makerbase-mks/MKS-Robin-Nano-V1.X/hardware/Image/MKS_Robin_Nano_Wiring_Cn.png

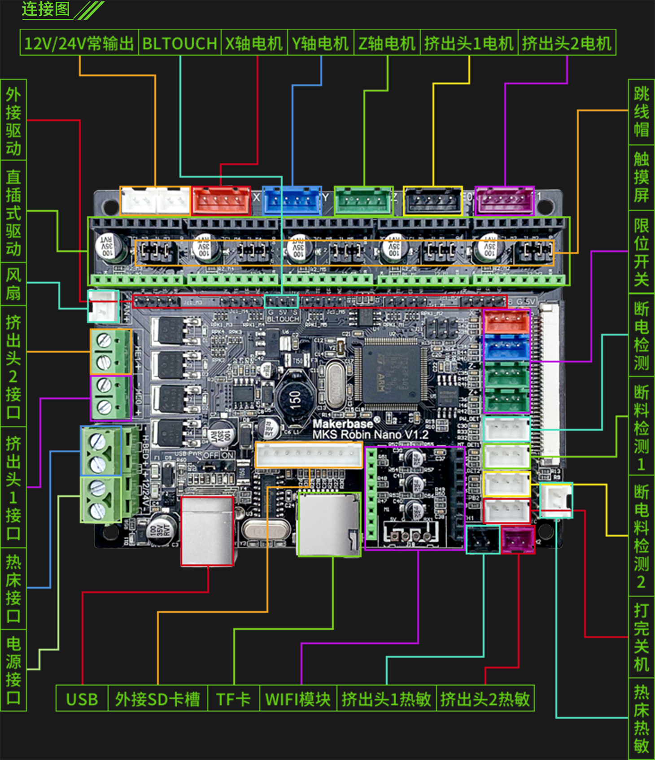
hardware/Image/MKS_Robin_Nano_Wiring_Cn.png
