makerbase-mks/MKS-Robin-Nano-V1.X/hardware/README.md

# MKS-Robin-Nano hardware log
MKS Robin Nano V1.2_004 change(2020/03/03)
Change base on 003 version
- Optimize TF card package

MKS Robin Nano V1.3_002 change(2021/1/30)
change base on V1.2_004 version
- MCU compatible with STM32F103VET6 and STM32F407VET6
- MKS Robin Nano V1.3_002 hardware MCU use STM32F407VET6

MKS Robin Nano-S V1.3_001
- MCU use STM32F407VET6
- Integrated 4 TMC2225 standard mode + 1 plug-in drive interface
