makerbase-mks/MKS-Robin-Nano-V1.X/Nano firmware v1.x.x/README.md

# MKS-Robin-Nano
1、The files in the nano32 folder are for nano + robin tft32.</br>
2、The files in the nano35 folder are for nano + robin tft35.</br>
