makerbase-mks/MKS-Robin-Nano-V1.X/hardware/Image/MKS_Robin_Nano_Pin.png

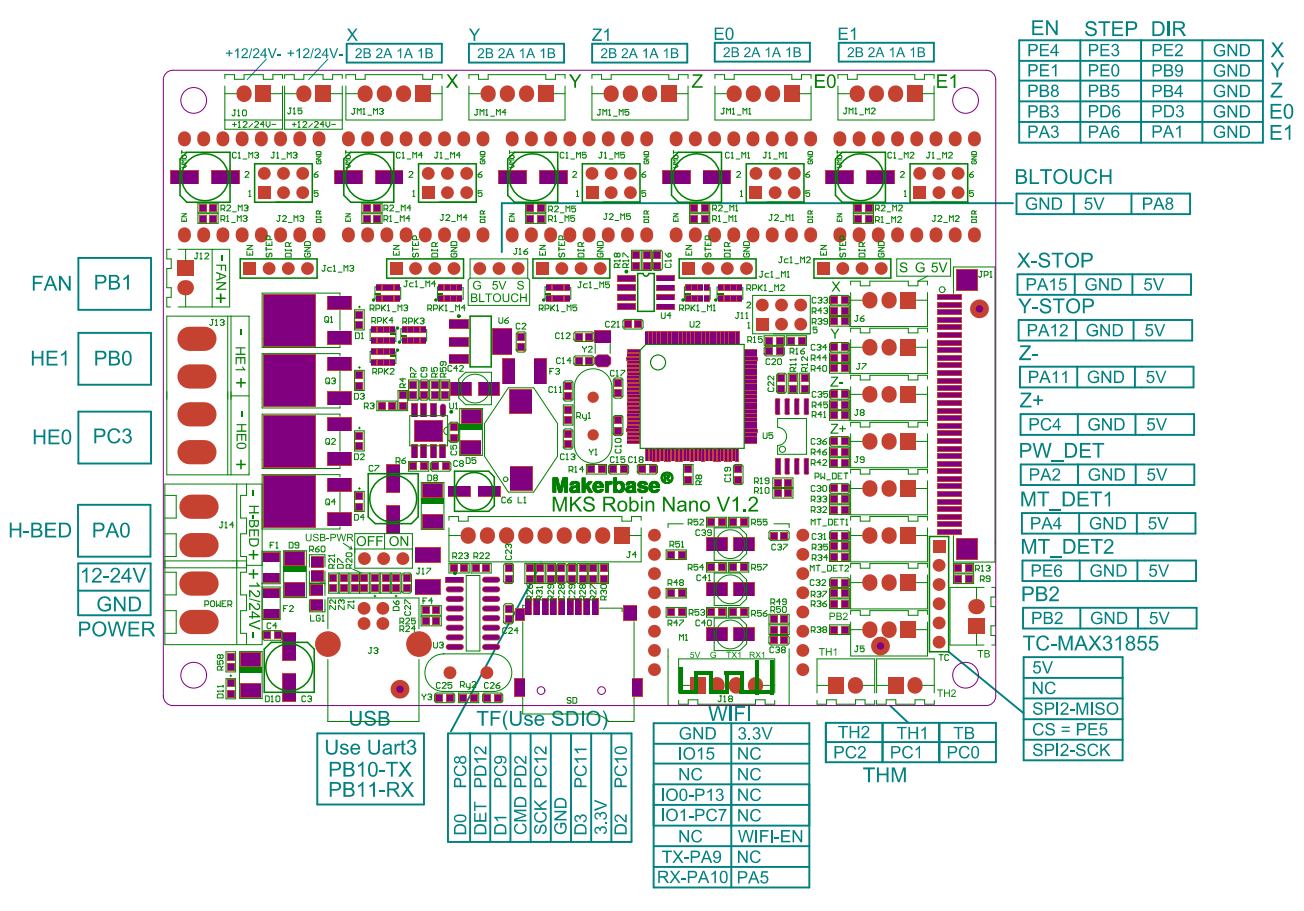
hardware/Image/MKS_Robin_Nano_Pin.png
