makerbase-mks/MKS-Robin-Nano-V1.X/hardware/Image/MKS_Robin_Nano_Size.png

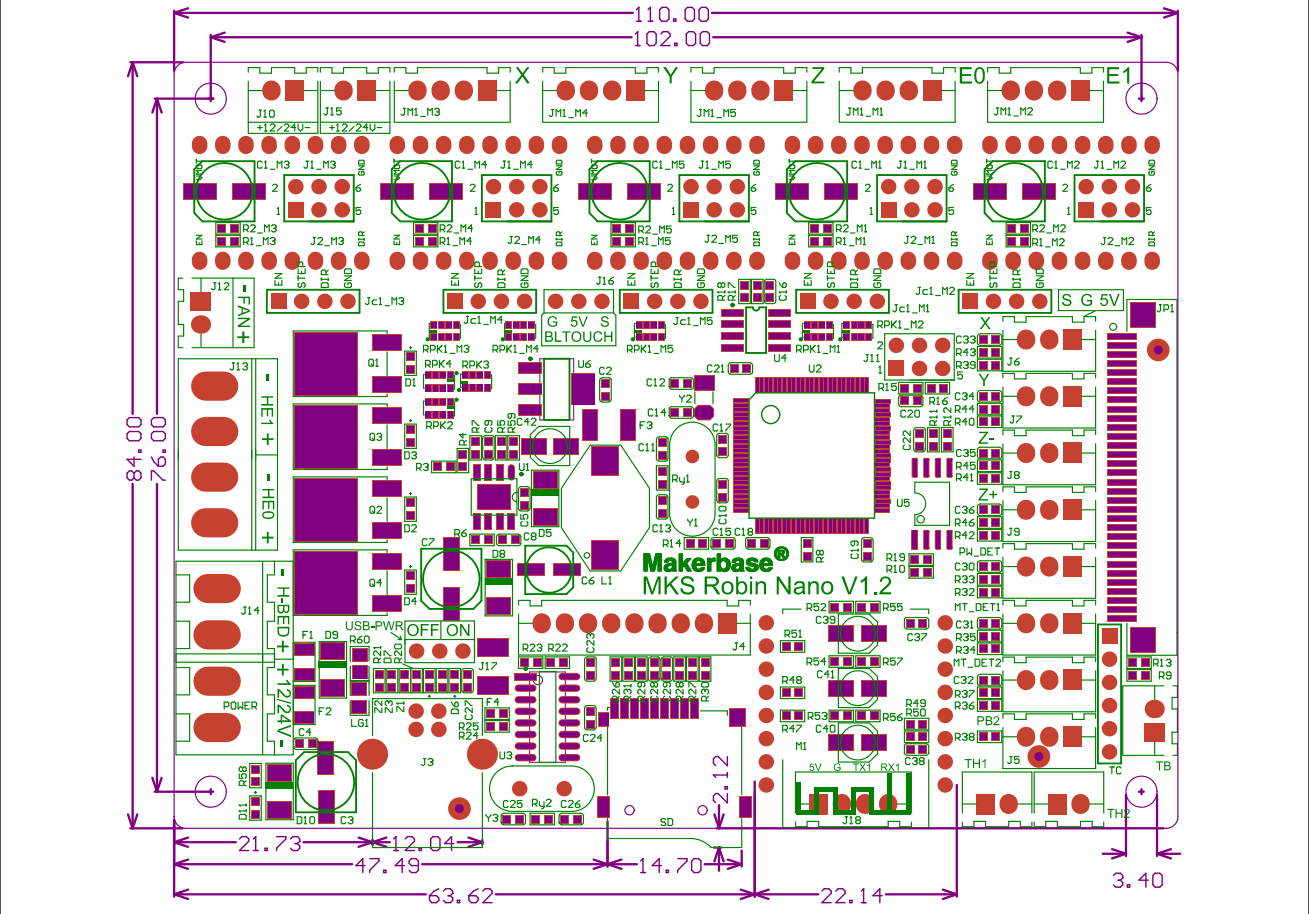
hardware/Image/MKS_Robin_Nano_Size.png
