makerbase-mks/MKS-Robin-Nano-V1.X/(threads)

Thread 2 (2019-12-10):

How to configure 2208 Driver

vespassassina, 2019-12-10:
I need to replace the existing drivers with 2208, how do i configure the firmware and hardware to use them ?

makerbase-mks, 2019-12-12:
Hi, no setup required, just plug it in and use

MowMoney, 2019-12-13:
> Hi, no setup required, just plug it in and use

Will this work with 2208 v3.0 IN UART?
I can adjust my VREF and switch between speadcycle and silent modes on my display with my SKR boards. I hope to have this ability with my Robin Nano as well.

Thank you

makerbase-mks, 2019-12-14:
OK, thank your suggestion！

Closed 2020-04-08.

Thread 4 (2020-01-11):

BED LEVELING (MESH) PROBLEM

pepe1125, 2020-01-11:
Hello,

I have an Two Trees Sapphire Plus 3D Printer, and I configured this firmware to Auto/Manual MESH bed leveling, and the firmware not corrected the bed level when I print. I used Two Tree Auto Level sensor, and manual mesh leveling. Is there a bug in the firmware?

My Config:

#===================Advanced  Settings=======================================
>cfg_insert_det_module			0			#Assemble power outage module (1:mks 220det;0:mks pwc)

>cfg_have_ups_device			0			# UPS(1:yes;0:no)

>cfg_print_over_auto_close		1			# auto-off when print finishes(1:yesŁ»0:no)

>PRINT_FINISHED_COUNT 			180			#After the shutdown delay time (unit: second)

>cfg_filament_det0_trigger_level	1			#the level signal of  outage detection E0 module (1:high level;0:low level)
>cfg_filament_det1_trigger_level	1			#the level signal of  outage detection E1 module (1:high level;0:low level)

>cfg_filament_load_length		100			#the lenght to extrude filament (mm),Max:2000mm
>cfg_filament_load_speed		800			#the speed to extrude filament(mm/min)
>cfg_filament_load_limit_temperature	200			#It is the minimum temperature to extrude filament .

>cfg_filament_unload_length		100			#It is the minimum temperature to extrude filament .
>cfg_filament_unload_speed		800			#the speed to retract filament(mm/min)
>cfg_filament_unload_limit_temperature	200			#It is the minimum temperature to retract filament .

#=========================== Bed Leveling  =============================
#Leveling mode settings
>cfg_leveling_mode			1			#1:auto-leveling; 0:manual leveling

#=========================== Manual Leveling ==================================

>cfg_point_number			5			#the point number of manual leveling(3,4,5 point available)

#the 5 point location of  manual leveling
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

#========================== Auto Leveling ===================================

>cfg_auto_leveling_cmd:G28;G29;                                #the setting of auto-leveling command button

#=================== Language settings ==========================================
>cfg_language_adjust_type		1	#multi-language(enable:1, disable:0)

>cfg_language_type			2	#languages setting,this configuration is valid when "cfg_multiple_language" is disabled.
						#(simplified Chinese:1; traditional Chinese:2; English:3; Russian:4; Spanish:5;French:6;Italian:7).
#==================Display Effect(refer to MKS TFT datasheet)=================================
#user-defined function1
>setmenu_func1_display		1				#1:display this buttonŁ¬0:no

#each command must be separated by semicolon ";"
>setmenu_func1:M84;

>moreitem_pic_cnt		0				#the number of "more" button

#edit command for 1~7 "More" button
#each command must be separated by semicolon ";"
#each icon command must be less than 200 bytes
>moreitem_button1_cmd:G28 X0;G28 Y0;G28 Z0;

>moreitem_button2_cmd:G28 X0;G28 Y0;G28 Z0;

>moreitem_button3_cmd:G28 X0;G28 Y0;G28 Z0;

>moreitem_button4_cmd:G28 X0;G28 Y0;G28 Z0;

>moreitem_button5_cmd:G28 X0;G28 Y0;G28 Z0;

>moreitem_button6_cmd:G28 X0;G28 Y0;G28 Z0;

>moreitem_button7_cmd:G28 X0;G28 Y0;G28 Z0;

#the number of "more" button to dispaly on printing interface
>morefunc_cnt			0

#button1~button6 function
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

#-------------------------------------------------------------
########  Display Customization ##########

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

>cfg_btn_text_offset		23		#position of button font offset bottom(unit:pixel)

>cfg_screen_display_mode	1		#the style of display on the screen home(0:classic,1:simple)
>cfg_screen_overturn_180	0x00		#The screen flips 180ˇă (0x00: no flip, 0xEE: flip)

#============================= Basic Settings =========================

>MACHINETPYE  2		# 0:Cartesian; 1:DELTA ; 2:COREXY

>HAS_TEMP_BED 1	        # whether enable the heated bed (disable: 0, enable: 1)

>EXTRUDERS    1		#This defines the number of extruders

#enable z2.
#====2 in 1 out setting===
>SINGLE_NOZZLE		0             #(0:disable;1:enable)

>Z2_STEPPER_DRIVERS	0		#1:enable z_dual;	0:disable
>Z2_ENDSTOPS		0	#Enable Z-axis double limit;   	0:disable;	1:enable;
>Z2_USE_ENDSTOP		0	#Z axis second limit interface;  	0:useless;  1:Z_MAX;	2:Z_MIN

# Travel limits after homing (units are in mm)
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

# position of hotend  for filament change and pause print
>FILAMENT_CHANGE_X_POS 5	 # X position of hotend  for filament change and pause print
>FILAMENT_CHANGE_Y_POS 5	 # Y position of hotend  for filament change and pause print
>FILAMENT_CHANGE_Z_ADD 5	 # Z addition of hotend (lift)	for filament change and pause print

#Offset of the second extruders.
>HOTEND_OFFSET_X 	-20.00 		#(in mm) offset of the second hotend on the X axis ,Offsets for the first hotend must be 0.0.
>HOTEND_OFFSET_Y 	-5.00  		#(in mm) offset of the second hotend on  the Y axis ,Offsets for the first hotend must be 0.0.
#============================== Stepper Motor Settings ============================
#Invert the stepper direction.
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

#Movement setting
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

#For Inverting Stepper Enable Pins  (0:Low,1:High)
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

>PULSE_DELAY		5		#Pulse hold time (unit: machine cycle)
#============================= Thermal Settings ============================
>TEMP_SENSOR_0		1		#1: 100k thermistorŁ»-3 : thermocouple with MAX31855

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

#======================== Thermal Runaway Protection =======================
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

# Type of heat manager for extruder.
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

#Type of heat manager for this heatedBed.
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

#============================== Endstop  Settings ===========================

>MIN_SOFTWARE_ENDSTOPS	 1              # 0:axes can move below MIN_POS;  1:axes won't move below MIN_POS.
>MAX_SOFTWARE_ENDSTOPS 	 1              # 0:axes can move below  MAX_POS;  1:axes won't move below MIN_POS.

# Mechanical endstop with COM to ground and NC to Signal uses "false" here (most common setup).
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

# Specify here all the endstop connectors that are connected to any endstop or probe.
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

#==============================  Home Settings ==============================

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

#============================= Z Probe Options =============================
#BLTOUCH			0	# 0:disable BLTOUCH; 1:enable BLTOUCH
#Select for a probe connected to Z-Min or Z-Max.
>Z_MIN_PROBE_PIN_MODE		2	# 0 : NULL; 1: ZMIN; 2: ZMAX

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

#=============================== Bed Leveling ==============================

>BED_LEVELING_METHOD 		5	# 0:NULL_BED_LEVELING; 3:AUTO_BED_LEVELING_BILINEAR; 5:MESH_BED_LEVELING

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

# Set the boundaries for probing (where the probe can reach).
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

>MESH_INSET			20	# Mesh inset margin on print area for MESH_BED_LEVELING
#============================= Z_PROBE settings =============================
>BLTOUCH			0	# 0:Disable BLTOUCH; 1:Enable BLTOUCH

#============================== Delta Settings =============================
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

#============================== Wifi Settings =============================
>CFG_WIFI_MODE			0			#wifi mode(0:sta;1:ap)
>CFG_WIFI_AP_NAME		WiFitest		#wifi name
>CFG_WIFI_KEY_CODE		makerbase		#wifi password

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

#Do not display wifi button 0: Display WiFi button 1: Do not display
>DISABLE_WIFI		1

#About information
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

#Suspend/resume extrusion configuration (unit: mm)
>PAUSE_UNLOAD_LEN   -3
>RESUME_LOAD_LEN    10

#Suspend/resume extrusion increase percentage, when 0, the item does not work (unit: %)
>RESUME_SPEED    80

#Wake mode configuration
>cfg_Standby_mode		0			#Whether to enable the wake-up function (0: off, 1: on)
>cfg_Standby_gap_time           600                     #Set to enter sleep time (unit: second)

#end.

makerbase-mks, 2020-03-05:
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
These two values you set to the same value try.

mks-viva, 2020-11-11:
Hi! No response, then I will temporarily close this question.

Closed 2020-11-11.

Thread 5 (2020-01-23):

Mks Robin Nano ,Why  mks firmware can't play buzzer with M300 gcode?

fenoloji, 2020-01-23:
I have Two trees bluer and it's mks firmware 1.0.3
I send gcode M300 but can't play buzzer.
However load Marlin firmware, it's play buzzer with gcode M300.
Mks firmware is bug.
How to solve?

makerbase-mks, 2020-02-29:
1. First, the motherboard only installs an active buzzer; it can only be turned on or off, and cannot be controlled by frequency;
2. Of course, you can add control buzzer switch……
3. If you have the programming ability, you can also add the switch buzzer function by yourself, Nano motherboard source code: https://github.com/makerbase-mks/MKS-Robin-Nano-Firmware

Closed 2020-04-08.

Thread 6 (2020-01-27):

TFT35 screen on Sapphire PRO - Marlin 2

EG1313, 2020-01-27:
Have installed Marlin 2 ("bugfix") on Sapphire Pro and it works fine (board MKS Robin Nano).
Trying to do the same with latest Marlin release (official), ATOM produces the BIN file but as on upload screen goes to 128x64 resolution and so far didn't manage to bring it to 320x240 pixel size.
Upscale x3 - doesn't work, low resolution menu screen with clearly visible items is jammed to upper left corner.

Please help, thanks.
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

makerbase-mks, 2020-02-29:
I has upload Nano+robin tft35 marlin firmware
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

EG1313, 2020-03-29:
Hello!
my point is - I have succeeded with Marlin 2.0 (bugfix) version but no luck with official releases - any of them.
For instance I'm trying to get screen "in place" with 2.0.5 and having the same issue.
Permanently low resolution screen gets attached to upper left corner, so called "upscale 3" wont work.
One more, buttons are working and they are where they are suppose to be but hidden.
Essentially printer is functional but screen...

Appreciate any help on this, thanks!
Attaching my configuration files

P.S. as well, I can control the printer with any terminal program.

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
[Marlin_conf.zip](https://github.com/makerbase-mks/MKS-Robin-Nano/files/4398283/Marlin_conf.zip)

mks-viva, 2020-11-11:
Hi! At present, the latest marlin firmware has fully supported this function. So I will close this question.

Closed 2020-11-11.

Thread 7 (2020-02-02):

Random movements during printing due to sd card reading errors

atomphil, 2020-02-02:
I got an issue with the MKS Robin nano v1.1. The print head moves to random locations in the middle of printing, after that printing continues as normal.
I have activated the debugging of the board (M111 S7) and can see that the errors happen randomly when reading from SD card. It is not because of the SD card itself. I have tried different tested cards and different file systems.
At the moment I use vanilla Marlin.

In the change log there is a point:

    2.V1.0.2 Modifications:
    2.1.Fix the bug that read Large capacity sd card data error sometimes.

@makerbase-mks What did you do to fix the read errors?

makerbase-mks, 2020-03-05:
I modified some card reading functions and changed the types of some of these variables

atomphil, 2020-03-05:
>
>
> I modified some card reading functions and changed the types of some of these variables

What did you changed to make it work better?

makerbase-mks, 2020-03-05:
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
You can change the type of the variable so that it can accommodate a larger address.

mks-viva, 2020-11-11:
Hi! I will close this question temporarily.

Closed 2020-11-11.

Thread 8 (2020-02-24):

Adding a language

karohan, 2020-02-24:
Hello.

I want to add the language of my country.
I cannot edit the .bin files.
Markerbase Image Editor Does not work properly.

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

Can you help me?

makerbase-mks, 2020-02-25:
Hello, this tool can help you.
https://github.com/makerbase-mks/Software/blob/master/MKS_Image2bin_tool/MKS_Image2bin_tool.rar

karohan, 2020-02-25:
I know how to make .bmp to.bin files.
I did not ask you this.
how to add a new language?
Please help me

makerbase-mks, 2020-02-25:
Hello, there are two ways to add a language:
1. Disable multi-language in the configuration file
> cfg_language_adjust_type 0 # multi-language (enable: 1, disable: 0)
You add your language when designing the picture, and then convert the picture into a .bin file. After updating, you can see the text you designed on the picture.
2. The source code needs to be modified. We have opened the source code for Robin_nano35. You can modify the source code to add your language.

karohan, 2020-02-26:
hi mks.
I managed to turn the buttons.
where should i translate the articles?
I can't interfere in Chinese writing
All posts, error messages, alerts are in chinese
Please Help me.

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

makerbase-mks, 2020-02-27:
The articles supports the following 7 languages, which you can configure in the configuration file. If you want to add other languages, you need to modify the source code:
> cfg_language_type 2 #languages setting, this configuration is valid when "cfg_multiple_language" is disabled.
# (simplified Chinese: 1; traditional Chinese: 2; English: 3; Russian: 4; Spanish: 5; French: 6; Italian: 7).

karohan, 2020-02-27:
Thank you. Where can I find the source code?

makerbase-mks, 2020-02-27:
https://github.com/makerbase-mks/MKS-Robin-Nano-Firmware/tree/1.0.5

makerbase-mks, 2020-02-27:
https://github.com/makerbase-mks/MKS-Robin-Nano-Firmware/tree/1.0.4

karohan, 2020-02-27:
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
I did not make any changes.
I wanted to test it.
I get this error.
thanks a lot for your support.
All my devices mks <3

makerbase-mks, 2020-03-05:
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
Maybe you should open it with this version.

karohan, 2020-03-12:
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

What is the problem?

mks-viva, 2020-11-11:
Has this problem been resolved?

Closed 2021-08-09.

Thread 10 (2020-03-03):

No manual move if endstops on double Z triggered

PowerEditon, 2020-03-03:
Hi,

with double Z only Z,
double optical/mechanical endstops,
endstops on Z **triggered** after homing,

power off,
restart,

now you can't move any axis over manual menu,

homing on all axis are working!

Simple solution is to move Z 5 mm after homing to untrigger, but i cloud not
found a setting for the config file.

Thanks

PowerEditon, 2020-03-03:
`#===================Advanced  Settings=======================================
>cfg_insert_det_module			0			#Assemble power outage module (1:mks 220det;0:mks pwc)

>cfg_have_ups_device			0			# UPS(1:yes;0:no)

>cfg_print_over_auto_close		1			# auto-off when print finishes(1:yes£ª0:no)

>cfg_filament_det0_trigger_level	0			#the level signal of  outage detection E0 module (1:high level;0:low level)
>cfg_filament_det1_trigger_level	0			#the level signal of  outage detection E1 module (1:high level;0:low level)

>cfg_filament_load_length		100			#the lenght to extrude filament (mm),Max:2000mm
>cfg_filament_load_speed		800			#the speed to extrude filament(mm/min)
>cfg_filament_load_limit_temperature	200			#It is the minimum temperature to extrude filament .

>cfg_filament_unload_length		100			#It is the minimum temperature to extrude filament .
>cfg_filament_unload_speed		800			#the speed to retract filament(mm/min)
>cfg_filament_unload_limit_temperature	200			#It is the minimum temperature to retract filament .

#=========================== Bed Leveling  =============================
#Leveling mode settings
>cfg_leveling_mode			0			#1:auto-leveling; 0:manual leveling

#=========================== Manual Leveling ==================================

>cfg_point_number			5			#the point number of manual leveling(3,4,5 point available)

#the 5 point location of  manual leveling
#Printer Head Body at the corners of the headbed, X,Y
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

#========================== Auto Leveling ===================================

>cfg_auto_leveling_cmd:G28;G29;                                #the setting of auto-leveling command button

#=================== Language settings ==========================================
>cfg_language_adjust_type		1	#multi-language(enable:1, disable:0)

>cfg_language_type			3	#languages setting,this configuration is valid when "cfg_multiple_language" is disabled.
						#(simplified Chinese:1; traditional Chinese:2; English:3; Russian:4; Spanish:5;French:6;Italian:7).
#==================Display Effect(refer to MKS TFT datasheet)=================================
#user-defined function1
>setmenu_func1_display		1				#1:display this button£¨0:no

#each command must be separated by semicolon ";"
>setmenu_func1:M84;

>moreitem_pic_cnt		0				#the number of "more" button

#edit command for 1~7 "More" button
#each command must be separated by semicolon ";"
#each icon command must be less than 200 bytes
>moreitem_button1_cmd:G28 X0;G28 Y0;G28 Z0;

>moreitem_button2_cmd:G28 X0;G28 Y0;G28 Z0;

>moreitem_button3_cmd:G28 X0;G28 Y0;G28 Z0;

>moreitem_button4_cmd:G28 X0;G28 Y0;G28 Z0;

>moreitem_button5_cmd:G28 X0;G28 Y0;G28 Z0;

>moreitem_button6_cmd:G28 X0;G28 Y0;G28 Z0;

>moreitem_button7_cmd:G28 X0;G28 Y0;G28 Z0;

#the number of "more" button to dispaly on printing interface
>morefunc_cnt			2

#button1~button6 function
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

#-------------------------------------------------------------
########  Display Customization ##########

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

>cfg_btn_text_offset		7		#position of button font offset bottom(unit:pixel)

>cfg_screen_display_mode	0		#the style of display on the screen home(0:classic,1:simple)

#============================= Basic Settings =========================

>MACHINETPYE  2		# 0:Cartesian; 1:DELTA ; 2:COREXY

>HAS_TEMP_BED 1	        # whether enable the heated bed (disable: 0, enable: 1)

>EXTRUDERS    1		#This defines the number of extruders

#enable z2.
>Z2_STEPPER_DRIVERS 1		#1:enable z_dual;     0:disable
>Z2_ENDSTOPS 1                  #enable z2_endstop;   0:disable z_dual_endstop;    1:enable z_dual_endstop;
>Z2_USE_ENDSTOP 1               #use Z_MIN or Z_MAX;  0:unused;1:Z_MAX;    2:Z_MIN

# Travel limits after homing (units are in mm)
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

# position of hotend  for filament change and pause print
>FILAMENT_CHANGE_X_POS 5	 # X position of hotend  for filament change and pause print
>FILAMENT_CHANGE_Y_POS 5	 # Y position of hotend  for filament change and pause print
>FILAMENT_CHANGE_Z_ADD 5	 # Z addition of hotend (lift)	for filament change and pause print

#Offset of the second extruders.
>HOTEND_OFFSET_X 	20.00 		#(in mm) offset of the second hotend on the X axis ,Offsets for the first hotend must be 0.0.
>HOTEND_OFFSET_Y 	5.00  		#(in mm) offset of the second hotend on  the Y axis ,Offsets for the first hotend must be 0.0.
#============================== Stepper Motor Settings ============================
#Invert the stepper direction.
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

#Movement setting
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

#For Inverting Stepper Enable Pins  (0:Low,1:High)
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

#============================= Thermal Settings ============================
>TEMP_SENSOR_0		1		#1: 100k thermistor£ª-3 : thermocouple with MAX31855

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

#======================== Thermal Runaway Protection =======================
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

# Type of heat manager for extruder.
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

#Type of heat manager for this heatedBed.
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

#============================== Endstop  Settings ===========================

>MIN_SOFTWARE_ENDSTOPS	 1              # 0:axes can move below MIN_POS;  1:axes won't move below MIN_POS.
>MAX_SOFTWARE_ENDSTOPS 	 1              # 0:axes can move below  MAX_POS;  1:axes won't move below MIN_POS.

# Mechanical endstop with COM to ground and NC to Signal uses "false" here (most common setup).
# Optical Endstop set to 0
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

# Specify here all the endstop connectors that are connected to any endstop or probe.
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

#==============================  Home Settings ==============================

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

#============================= Z Probe Options =============================
#BLTOUCH			0	# 0:disable BLTOUCH; 1:enable BLTOUCH
#Select for a probe connected to Z-Min or Z-Max.
>Z_MIN_PROBE_PIN_MODE		2	# 0 : NULL; 1: ZMIN; 2: ZMAX

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

#=============================== Bed Leveling ==============================

>BED_LEVELING_METHOD 		0	# 0:NULL_BED_LEVELING; 3:AUTO_BED_LEVELING_BILINEAR; 5:MESH_BED_LEVELING

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

# Set the boundaries for probing (where the probe can reach).
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

>MESH_INSET			20	# Mesh inset margin on print area for MESH_BED_LEVELING
#============================= Z_PROBE settings =============================
>BLTOUCH			0	# 0:Disable BLTOUCH; 1:Enable BLTOUCH

#============================== Delta Settings =============================
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

#============================== Wifi Settings =============================
>CFG_WIFI_MODE			0			#wifi mode(0:sta;1:ap)
>CFG_WIFI_AP_NAME		WiFitest		#wifi name
>CFG_WIFI_KEY_CODE		makerbase		#wifi password

>CFG_CLOUD_ENABLE		1			#cloud service enable(0:disable;  1:enable)
>CFG_WIFI_CLOUD_HOST		www.baizhongyun.cn	#cloud server url
>CFG_CLOUD_PORT			10086			#cloud server port

#============================== About information =========================

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

#end.`

bates1337, 2020-03-20:
Same probleme here with a mks robin nano v1.1

MKS-Sean, 2020-03-28:
[robin_nano35_cfg.txt](https://github.com/makerbase-mks/MKS-Robin-Nano/files/4396565/robin_nano35_cfg.txt)
I use this configuration file is normal, you can modify some parameters, such as pulse, motor direction, etc., and then try to use on your machine

Thread 9 (2020-03-03):

Changed Leveling Points at the Manual Leveling Menu !!!

PowerEditon, 2020-03-03:
Hi,
why you change the level Points at the Leveling Menu.

From 1.02-1.04 to now 2.0 you change the 4 manual leveling points,
or only the icons, can you correct this or is it a needed change!?

1.03:
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

2.0:
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

PowerEditon, 2020-03-03:
`#===================Advanced  Settings=======================================
>cfg_insert_det_module			0			#Assemble power outage module (1:mks 220det;0:mks pwc)

>cfg_have_ups_device			0			# UPS(1:yes;0:no)

>cfg_print_over_auto_close		1			# auto-off when print finishes(1:yes£ª0:no)

>cfg_filament_det0_trigger_level	0			#the level signal of  outage detection E0 module (1:high level;0:low level)
>cfg_filament_det1_trigger_level	0			#the level signal of  outage detection E1 module (1:high level;0:low level)

>cfg_filament_load_length		100			#the lenght to extrude filament (mm),Max:2000mm
>cfg_filament_load_speed		800			#the speed to extrude filament(mm/min)
>cfg_filament_load_limit_temperature	200			#It is the minimum temperature to extrude filament .

>cfg_filament_unload_length		100			#It is the minimum temperature to extrude filament .
>cfg_filament_unload_speed		800			#the speed to retract filament(mm/min)
>cfg_filament_unload_limit_temperature	200			#It is the minimum temperature to retract filament .

#=========================== Bed Leveling  =============================
#Leveling mode settings
>cfg_leveling_mode			0			#1:auto-leveling; 0:manual leveling

#=========================== Manual Leveling ==================================

>cfg_point_number			5			#the point number of manual leveling(3,4,5 point available)

#the 5 point location of  manual leveling
#Printer Head Body at the corners of the headbed, X,Y
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

#========================== Auto Leveling ===================================

>cfg_auto_leveling_cmd:G28;G29;                                #the setting of auto-leveling command button

#=================== Language settings ==========================================
>cfg_language_adjust_type		1	#multi-language(enable:1, disable:0)

>cfg_language_type			3	#languages setting,this configuration is valid when "cfg_multiple_language" is disabled.
						#(simplified Chinese:1; traditional Chinese:2; English:3; Russian:4; Spanish:5;French:6;Italian:7).
#==================Display Effect(refer to MKS TFT datasheet)=================================
#user-defined function1
>setmenu_func1_display		1				#1:display this button£¨0:no

#each command must be separated by semicolon ";"
>setmenu_func1:M84;

>moreitem_pic_cnt		0				#the number of "more" button

#edit command for 1~7 "More" button
#each command must be separated by semicolon ";"
#each icon command must be less than 200 bytes
>moreitem_button1_cmd:G28 X0;G28 Y0;G28 Z0;

>moreitem_button2_cmd:G28 X0;G28 Y0;G28 Z0;

>moreitem_button3_cmd:G28 X0;G28 Y0;G28 Z0;

>moreitem_button4_cmd:G28 X0;G28 Y0;G28 Z0;

>moreitem_button5_cmd:G28 X0;G28 Y0;G28 Z0;

>moreitem_button6_cmd:G28 X0;G28 Y0;G28 Z0;

>moreitem_button7_cmd:G28 X0;G28 Y0;G28 Z0;

#the number of "more" button to dispaly on printing interface
>morefunc_cnt			2

#button1~button6 function
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

#-------------------------------------------------------------
########  Display Customization ##########

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

>cfg_btn_text_offset		7		#position of button font offset bottom(unit:pixel)

>cfg_screen_display_mode	0		#the style of display on the screen home(0:classic,1:simple)

#============================= Basic Settings =========================

>MACHINETPYE  2		# 0:Cartesian; 1:DELTA ; 2:COREXY

>HAS_TEMP_BED 1	        # whether enable the heated bed (disable: 0, enable: 1)

>EXTRUDERS    1		#This defines the number of extruders

#enable z2.
>Z2_STEPPER_DRIVERS 1		#1:enable z_dual;     0:disable
>Z2_ENDSTOPS 1                  #enable z2_endstop;   0:disable z_dual_endstop;    1:enable z_dual_endstop;
>Z2_USE_ENDSTOP 1               #use Z_MIN or Z_MAX;  0:unused;1:Z_MAX;    2:Z_MIN

# Travel limits after homing (units are in mm)
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

# position of hotend  for filament change and pause print
>FILAMENT_CHANGE_X_POS 5	 # X position of hotend  for filament change and pause print
>FILAMENT_CHANGE_Y_POS 5	 # Y position of hotend  for filament change and pause print
>FILAMENT_CHANGE_Z_ADD 5	 # Z addition of hotend (lift)	for filament change and pause print

#Offset of the second extruders.
>HOTEND_OFFSET_X 	20.00 		#(in mm) offset of the second hotend on the X axis ,Offsets for the first hotend must be 0.0.
>HOTEND_OFFSET_Y 	5.00  		#(in mm) offset of the second hotend on  the Y axis ,Offsets for the first hotend must be 0.0.
#============================== Stepper Motor Settings ============================
#Invert the stepper direction.
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

#Movement setting
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

#For Inverting Stepper Enable Pins  (0:Low,1:High)
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

#============================= Thermal Settings ============================
>TEMP_SENSOR_0		1		#1: 100k thermistor£ª-3 : thermocouple with MAX31855

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

#======================== Thermal Runaway Protection =======================
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

# Type of heat manager for extruder.
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

#Type of heat manager for this heatedBed.
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

#============================== Endstop  Settings ===========================

>MIN_SOFTWARE_ENDSTOPS	 1              # 0:axes can move below MIN_POS;  1:axes won't move below MIN_POS.
>MAX_SOFTWARE_ENDSTOPS 	 1              # 0:axes can move below  MAX_POS;  1:axes won't move below MIN_POS.

# Mechanical endstop with COM to ground and NC to Signal uses "false" here (most common setup).
# Optical Endstop set to 0
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

# Specify here all the endstop connectors that are connected to any endstop or probe.
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

#==============================  Home Settings ==============================

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

#============================= Z Probe Options =============================
#BLTOUCH			0	# 0:disable BLTOUCH; 1:enable BLTOUCH
#Select for a probe connected to Z-Min or Z-Max.
>Z_MIN_PROBE_PIN_MODE		2	# 0 : NULL; 1: ZMIN; 2: ZMAX

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

#=============================== Bed Leveling ==============================

>BED_LEVELING_METHOD 		0	# 0:NULL_BED_LEVELING; 3:AUTO_BED_LEVELING_BILINEAR; 5:MESH_BED_LEVELING

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

# Set the boundaries for probing (where the probe can reach).
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

>MESH_INSET			20	# Mesh inset margin on print area for MESH_BED_LEVELING
#============================= Z_PROBE settings =============================
>BLTOUCH			0	# 0:Disable BLTOUCH; 1:Enable BLTOUCH

#============================== Delta Settings =============================
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

#============================== Wifi Settings =============================
>CFG_WIFI_MODE			0			#wifi mode(0:sta;1:ap)
>CFG_WIFI_AP_NAME		WiFitest		#wifi name
>CFG_WIFI_KEY_CODE		makerbase		#wifi password

>CFG_CLOUD_ENABLE		1			#cloud service enable(0:disable;  1:enable)
>CFG_WIFI_CLOUD_HOST		www.baizhongyun.cn	#cloud server url
>CFG_CLOUD_PORT			10086			#cloud server port

#============================== About information =========================

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

#end.`

makerbase-mks, 2020-03-05:
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

We just made an icon correction, the position of the leveling point is still according to the coordinates of the configuration file

kcinnayblackcat, 2022-11-26:
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

Thread 11 (2020-03-15):

Firmware v2.x.x for nano + tft32

artdezigner, 2020-03-15:
Hello, please tell me, the firmware v.2.x.x will be for Robin nano v1.1 + TFT 32?
Can I use v2.0.0 firmware for Nano+tft 35 for my configuration?

And second question: does the pin of coldend fan work automatically in firmware v1.0.4?

mks-viva, 2020-03-16:
Hi!
1. firmware v2.x.x default is Nano+Robin TFT35
2. This FAN is in the printing process, it will be automatically turned on after the first layer printing is completed

artdezigner, 2020-03-17:
please tell me when the firmware for Nano+TFT 32 will be made?

duyleekun, 2020-05-23:
I'm using the tft24, where to change the config?

mgcrea, 2020-06-13:
@mks-viva I've seen that there is a `Robin-TFT32` git branch on the [firmware repository](https://github.com/makerbase-mks/Mks-Robin-Nano-Marlin2.0-Firmware/tree/Robin-TFT32), would this branch work with a TFT32 or is it still work in progress?

Thread 12 (2020-04-09):

Mks_Nano35_V2.0.1 can't use G34 - Z Steppers Auto-Alignment

chenxiaowei107, 2020-04-09:
the next version firmware will Support？
My machine have dual Z and bltouch, If i use marlin2.0,I can user Z steppers Auto-Alignment ,It's very convenient and convenient。But marlin is ugly and not convenient for 3.5TFT Touch-screen。
The MKS-Robin-Nano was Very convenient and beautiful，I like it.
I Hope Next Firmware will support Z Steppers Auto-Alignment.

makerbase-mks, 2020-04-10:
Hi! V2.0.1 version firmware, already compatible with this function.

chenxiaowei107, 2020-04-10:
> Hi! V2.0.1 version firmware, already compatible with this function.

How can I use?

chenxiaowei107, 2020-04-10:
> Hi! V2.0.1 version firmware, already compatible with this function.
I send G34 code ，but the machine no response

makerbase-mks, 2020-04-10:
Of course! You can download it and update it to your Nano board.
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
https://raw.githubusercontent.com/makerbase-mks/MKS-Robin-Nano/master/Nano%20firmware%20v2.x.x/Mks_Nano35_V2.0.1%20Release%20file.rar

chenxiaowei107, 2020-04-10:
> Of course! You can download it and update it to your Nano board.
> 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
> https://raw.githubusercontent.com/makerbase-mks/MKS-Robin-Nano/master/Nano%20firmware%20v2.x.x/Mks_Nano35_V2.0.1%20Release%20file.rar

I have Flash this firmware，but the menu no  Z steppers Auto-Alignment menu.

makerbase-mks, 2020-04-10:
This function of G34 may not be supported, but 3DTOUCH and limit function are compatible.

chenxiaowei107, 2020-04-10:
> This function of G34 may not be supported, but 3DTOUCH and limit function are compatible.

我是不是回复中文就可以了，marlin2.0可以利用bltouch自动平衡z轴。2.0.0.1的固件没有这个功能。

makerbase-mks, 2020-04-10:
2.0.1固件已经支持bltouch和限位功能，但是还不支持G34指令

chenxiaowei107, 2020-04-10:
> 2.0.1固件已经支持bltouch和限位功能，但是还不支持G34指令

是的，支持bltouch我知道，但是希望下个版本可以支持G34，我的是双z，用e1电机位置作为第二个z轴，marlin2.0 G34可以自动校准2个z轴的高度，非常方便实用。

makerbase-mks, 2020-04-10:
这个可以有，后续我们会考虑增加上去。

chenxiaowei107, 2020-04-10:
> 这个可以有，后续我们会考虑增加上去。

因为用双z，所以现在只能用marlin，但是marlin真的界面太难看，也不友好，mks的固件比较方便。期待你们得下个版本。

hakimio, 2020-08-11:
@makerbase-mks any news on G34 (Z axis Auto-Alignment)?

Thread 13 (2020-04-16):

Mesh Edit Z Step is to big

AndyCGN, 2020-04-16:
The Z step size in manual mesh leveling is to big. In the UI I can only switch between values 1mm and 0.1mm. The configuration file do show any optione like MESH_EDIT_Z_STEP.

mks-viva, 2020-04-26:
Hi! We will fix similar problems

Closed 2020-06-06.

Thread 14 (2020-04-21):

Compiling for Robin Nano35 issue

imberest, 2020-04-21:
Hello, I've been trying to tweak Marlin 2.0 for my needs, but it fails to compile. I've tried stock Marlin 2.0 and it compiles with no problems.
Mks-Robin-Nano-Marlin2.0-Firmware-master gets stuck on:
**Compiling .pio\build\mks_robin_nano35\lib22d\USBComposite\usb_scsi_data.c.o
Compiling .pio\build\mks_robin_nano35\lib22d\USBComposite\usb_setup.cpp.o
Compiling .pio\build\mks_robin_nano35\lib22d\USBComposite\usb_x360.c.o
Archiving .pio\build\mks_robin_nano35\lib22d\libUSBComposite.a
Archiving .pio\build\mks_robin_nano35\lib690\libU8glib-HAL_ID1932.a** <--- stuck...

Tried VS+PlatformIO and tried MKS-Marlin2.0-Compile-Tool so far.

**EDIT**
So, the new release fixed it and I can successfully compile it. The issue I am having is that TFT35 is blank.
Does anyone have any tips or ideas?

All i need is to change stepper drivers to TMC2209_Standalone and FAN pin to PB0 as i shorted PB1 pin...

Problem i am facing is that if i upload _Robin_nano35.bin_ compiled by MKS screen works as normal. Now if i compile **Mks-Robin-Nano-Marlin2.0-Firmware** and upload freshly compiled Robin_nano35.bin to board screen goes blank. Shows only booting message at start.

Also noticed files are different size. Bin provided by MKS 490ish kb and mine is 300kb.

What should i add to my Config.h file?

imberest, 2020-04-22:
So, the new release fixed it and I can successfully compile it. The issue I am having is that TFT35 is blank.
Does anyone have any tips or ideas?

mks-viva, 2020-04-26:
Hi! You can use mks has add UI marlin2.0.5, link：https://github.com/makerbase-mks/Mks-Robin-Nano-Marlin2.0-Firmware

mks-viva, 2020-11-11:
Hi! No response, then I will temporarily close this question.

Closed 2020-11-11.

Thread 15 (2020-04-24):

TMC2208 UART Connection Error

Leetspeak1286, 2020-04-24:
Hi,

I try to run longer on the Robin Nano 1.2 TMC 2208 in UART mode but always get

X 0x00: 00: 00: 00 Bad response!
Testing X connection ... Error: All LOW

Have I tried 1 cable and like a Y cable with 1k ram stand for TX and always the same?

Uploaded my Pins.h and Configs, unfortunately I can't get any further: /
[conf.zip](https://github.com/makerbase-mks/MKS-Robin-Nano/files/4531436/conf.zip)

VIXIVIXIV, 2020-05-05:
@le3tspeak, were you able to get it to work? I'm planning on a driver upgrade and want to UART.

hannesweisbach, 2020-12-11:
Have you reduced the baudrate? 19200 worked for me.

I put `#define TMC_BAUD_RATE 19200` in `Marlin/src/pins/stm32f1/pins_MKS_ROBIN_NANO.h`. I think the default is something like 56700 and that was too fast to reliably work. It worked sometimes but the my TMC2208 did not always initialize properly and M122 never worked. However I could see the TMC2208 sometimes responded to a status request from Marlin on the oscilloscope.

thierryzoller, 2020-12-11:
This was closed, but what was the solution?

hannesweisbach, 2020-12-11:
@le3tspeak never commented on what was the problem or if s/he solved it. From my experience I'd say too high of a baud rate in the config. But this is just a guess on my part at this point.

Closed 2020-04-26.

Thread 16 (2020-04-25):

BL-Touch 3.1V does not work properly

heavy2119, 2020-04-25:
Wiring is normal

Problem.

1. Power on → BL touch pin needle up and down 2-3 times → pin needle waiting
→ When the signal line is connected, the power turns on → The pin needle comes out
→ Remove signal wire and turn on the power → Pin needle does not come out

2. It does not work on M280 P0 S90, M280 P0 S10, but it works up / down using M280 P0 S120.

3. Pin-up, pin-down and pin-up are not detected during auto-leveling.
→ Auto leveling results are well maintained.

Attach the video in question

https://youtu.be/2M8nTG85QXc

https://youtu.be/myXfHmgcO8k

mks-viva, 2020-04-26:
Hi! V2.0.0 firmware version has support bltouch v3.1, you can download it and test...

Bunta-Impreza, 2020-09-27:
Hello,
News? I have the same problem with BLT 1.3 and 3Dtouch.
Version 3.0.3.3

Closed 2020-05-21.

Thread 17 (2020-04-26):

Bltouch does not work on 2.0.0v and 2.0.1v

heavy2119, 2020-04-26:
Bltouch does not work on 2.0.0v and 2.0.1v
I want to find the cause
Please help

AuntJemima, 2020-04-28:
> Bltouch works on 2.0.2v but Servo does not rise after probe detection

I have this exact problem as well, and it's the only thing preventing me from printing with the BLTouch!

james013, 2020-05-09:
works for me:

in config file :

>Z_MAX_ENDSTOP_INVERTING 1

>Z_MIN_PROBE_ENDSTOP_INVERTING 1

>USE_ZMAX_PLUG	1

>Z_MIN_PROBE_PIN_MODE		2	# 0 : NULL; 1: ZMIN; 2: ZMAX

>BLTOUCH			1	# 0:Disable BLTOUCH; 1:Enable BLTOUCH

AuntJemima, 2020-05-09:
>
>
> > USE_ZMAX_PLUG 1

Perhaps the problem is that I put it in ZMIN rather than ZMAX? I'll have to give that a shot instead.

Bunta-Impreza, 2020-07-08:
Hello, any news here?
I have the problem too.
I’m on version 2.0.3.2
[robin_nano35 Bunta_cfg.txt](https://github.com/makerbase-mks/MKS-Robin-Nano/files/4890866/robin_nano35.Bunta_cfg.txt)

https://www.youtube.com/watch?v=MFSIoimxCeg&feature=youtu.be

Sorry for my poor English, I use reverso.

Thread 18 (2020-05-13):

MKS Robin Nano TMC 2209 v 3.0 UART how is install ?

dejavuxer, 2020-05-13:
Hi friend.

Sorry for my broken English. I have two trees bluer 3d printer.
There are 2 TMC 2208 and 2 A4998 on it. Can I replace it with the TMC 2209 v3 uart I have?

Can you tell me how to do it?
Can you give information about the software and installation.
Should I take action on the config file?

Thank you.

Teslafly, 2020-05-20:
The uart pins are not connected correctly to the pins on the tmc2209 drivers. I am also trying to do this.
you will need to use the wifi (or other) uart port and run it to the tmc drivers configured on different addresses using the microstepping jumpers, the uart will be connected to the slp pins direct to rx, and to tx through a 1k resistor.
I may post here if i get my setup working.

this would not be hard to implement in a hardware revision.
If they did, i would suggest adding jumpers to support native usb too.

makerbase-mks, 2020-05-21:
1. You can use an IO to drive the TMC2208 / 2209 UART mode; UART_TX = UART_RX
2. You can connect to the free pin of the WIFI module to drive the TMC UART

GrumpaV2, 2020-05-22:
Good so WiFi will still work then. Has this been tested?

makerbase-mks, 2020-05-26:
Because you use marlin2.0, robin wifi is not available, so wifi IO can be used for TMC uart

Closed 2020-06-06.

Thread 19 (2020-05-15):

define MULTIPLE_PROBING 2 is not

heavy2119, 2020-05-15:
//#define MULTIPLE_PROBING 2→ #define MULTIPLE_PROBING 2

If you change
There are no compilation errors

Infinite booting occurs.
Is there a workaround?

Thread 20 (2020-05-16):

Mks_Nano35_V2.0.5 Release

lhanliang, 2020-05-16:
When is the official release of Mks_Nano35_V2.0.5.3 , version without need to compile

mks-viva, 2020-11-13:
@lhanliang
The current function is relatively complete, we will collect relevant feedback. We recommend you to directly use MKS Robin Nano marlin2.0 firmware to your motheriboard.

Closed 2020-11-13.

Thread 21 (2020-05-16):

cfg_Standby_mode and hesitation problem

serdartaylan, 2020-05-16:
Hello there.
I use "Two Tress" brand "Bluer" model printer.
My printer now has v2.0.2 installed. I use "Cura".

I set the cfg_Standby_mode value to 1 to turn off the screen from the settings. My screen turns off at the end of the time I set.

Sometimes, when I touch the screen to turn the screen back on, there is a pause of 1 second (maybe shorter) during the printing process.

My Experience:
This pause does not make the process of filling.
It usually pauses when building the outer walls.

What is the problem, how should I solve it?

Do you want me to shoot a video?

makerbase-mks, 2020-05-21:
Hi! If you do n’t set it, will the printer not be suspended?

serdartaylan, 2020-05-21:
If I turn off the "cfg_Standby_mode" setting, that is, if the screen is always on, there is no hesitation.
this happens only when we touch the screen after the screen turns off at the end of the time.
I can shoot videos if you want...

cemiloztas, 2020-05-21:
What do you think Mks ? You are asking to user. Did not you test your card?  when it was wake up from stand by mode what was happening and how is it wake up . Is there any problem etc.

ttutuncu, 2020-05-27:
There is a problem in the 2.0.2 version, maybe older versions too. When the screen is turned off by standby mode we need to wake up the screen by touching it. If the printer is printing a wall and we touch the screen to wake it up the printer pauses. This pause causes a blob on the wall. Can you check the standby modes behaviour while the printer is printing. There is some sort of lag causing the board to stop sending gcode to the printer. This mostly happens on wall prints, it doesn't occur while printing infill.

Thread 22 (2020-05-26):

Excessive heating of the motors. (In this case only the Y axis)

LuigyU, 2020-05-26:
After waiting a long time due to the delay with the shipping of the covid-19, I finally received the item.
Then I installed it on my printer, following all the instructions I received from its github portal and with great satisfaction to see that everything was working correctly.

But my disappointment was that during the first impression I noticed that the nema17 0.9A motor of the Y axis was overheated (to such an extent that it could not be touched by hand because it burned, it was almost like the bed at more than 70º or more )
The X and E0 axis motors were also warming up but were acceptable.

Firstly, see if my Y axis car had any impediment in its movement that made it go wrong and it was not.

I understood that the voltage with which the various MKS TCM2208 V2 came as they come from the factory is too high (1,171) and I proceeded to lower it as I had previously on my old board. (0.80V)

Still, it was still very hot, and I proceeded to lower it even further, to the 0.7 limit of the driver.
The temperature of the Y motor was hot and seemed correct but in this situation, I was already missing my motor steps.

Believing that the driver could be damaged, I changed it with another, but it was still just as hot.

Perhaps suspecting that my motor might be damaged, I would change it for a different and stronger one, a 1.2A nema 17 and adjust the driver to 1V to test it. I had to stop printing (which was an hour) because the engine was excessively hot.

All my mounting information that I have followed step by step and the software I have found here.
https://github.com/makerbase-mks/MKS-Robin-Nano/tree/master/Nano%20firmware%20v2.x.x
and from the videos
https://www.youtube.com/watch?v=_qMahRSUtDY
Is what I have done correct?

The X, Z, and E0 axes are fine, but I **only have the problem on the Y axis.**

I don't know what to do anymore, I have everything stopped and I can't print anything without compromising the integrity of the printer.
I really need your help and advice

chshkhr, 2020-06-11:
Hi,
correct `Vref `for [TMC2208](https://wiki.fysetc.com/TMC2208/) is **1,69V**.
While correct `Vref` for [TMC2209](https://wiki.fysetc.com/TMC2208/) is **2,82V**.
`Vref` is proportional to `Irms` (as for TMC2008 `Vref = (Irms * 2.5V) / 1.77A = Irms * 1.41 = Imax`). So the more `Vref` you set the less current you need to get the same power `P = I * V`. So to reduce consumed current (which is the reason for motors heating) you need to increase`Vref`.
Am I right?
Anyway, I increased `Vref` for my TMC2209 up to 2,61V (this is the maximum value I could get via the resistor on TMC2209). Temperature decreased from 84C to 50C while printing. Heating on standby mode (without disabling motors) disappeared at all

thierryzoller, 2020-06-11:
Sounds counterintuitive to me, I am interested in the responses.

chshkhr, 2020-06-11:
As I understand now we should look at not only on RMC of stepper driver but on RMC of stepper motor because it much lower... _"For NEMA 17 motors from 3D printers the current is in general in the range of 0.5A to 0.8A RMS, which is a reference voltage (Vref) of 0.7V to 1.1V."_
[Here is the source](https://learn.watterott.com/silentstepstick/faq/)

Thread 23 (2020-05-27):

Configuring LINEAR ADVANCE

ttutuncu, 2020-05-27:
Hi,
How can we configure linear advance in MKS Robin Nano?
LIN_ADVANCE

makerbase-mks, 2020-05-28:
Hi! Are you use marlin2.0 or Nano's  firmware? If it is marlin2.0, then you can directly set it in configuration_adv.h, if it is the motherboard's own firmware, it may not be supported yet.

ttutuncu, 2020-05-28:
I am using Nano's firmware. I don't want to loose the fancy UI of the firmware because I use a touchscreen.

ttutuncu, 2020-06-08:
I have never worked on Marlin before. But Teaching Tech on youtube has an extensive explanation on how to setup linear advance. https://www.youtube.com/watch?v=c5jjwBqARpo

Thread 24 (2020-05-28):

When will the firmware be upgraded to Marlin 2.0.5.3 version?

ttutuncu, 2020-05-28:
Hi,

When will the firmware be upgraded to Marlin 2.0.5.3 version? Is it in the works?
Also it would be cool to have a menu for manual mesh bed leveling with Z +/- settings for each spot.

Thanks.

Miraculix200, 2020-06-19:
Did you see this repo? https://github.com/makerbase-mks/Mks-Robin-Nano-Marlin2.0-Firmware

Thread 25 (2020-05-30):

Errors version 2.02

Engi23, 2020-05-30:
1. The second print fails. The printer abuts the carriage against the frame. Rebooting solves the problem.
If you specify G91 in the final code (for example, to move the table down by 10cm corexy), then with the beginning of the second one it will fail. It is decided by the G90 team in the start code. It would be nice if the firmware eliminated such an error.
2. Files in the menu no longer display correctly
1 icon = bmp_custom1
2 icon = bmp_custom1
3 icon = bmp_custom2
4 icon = bmp_custom3
Are they resolved in version 2.03?

makerbase-mks, 2020-06-06:
We will follow up on this issue

Closed 2020-11-16.

Thread 26 (2020-05-30):

Editing the Russian language

Engi23, 2020-05-30:
1. Replace the "выдавить" to "Извлечь". The word "выдавить" in Russian is associated with squeezing plastic from a nozzle, and introduces confusion and confusion.
It is also advisable to replace "втянуть" на "Заправить"
2. Correct errors in words
"Ткорость экстр" right  "Скорость экстр"
"Ткорость движ" right  "Скорость движ"
3. Can you write words with a capital letter? It's a shame, in all languages words are written with a capital letter, and in Russian with a small one. If you need, I will provide a complete list of words written from a large buva, if you have any problems with typing.

makerbase-mks, 2020-06-10:
Thank you for your feedback. Can you list the problematic translations or use improper vocabulary, we will correct it.

makerbase-mks, 2020-06-16:
Ok thank you again!

Spider84, 2020-06-18:
May be make font change to more better?

Thread 29 (2020-06-11):

Inductive sensor options?

themacboy, 2020-06-11:
It is possible to use a inductive sensor on a Robin Nano board?

How can I do that?

makerbase-mks, 2020-06-16:
As long as your module meets the output high and low levels

Engi23, 2020-06-21:
I used this circuit
[https://www.cnc-club.ru/forum/download/file.php?id=24409&mode=view](url)

themacboy, 2020-06-28:
I dont need all that, Im using a 5v inductive sensor from trianglelabs:
https://es.aliexpress.com/item/33006152423.html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,searchweb201602_,searchweb201603_

The current problem is that after instgallation Im not sure what parameters I must set in config, and the motherboard turn crazy and set Z displaced 40 mm and Z servo stop working when I set autolevel to on.

Can someone help with configs? Thanks in advance

themacboy, 2020-06-28:
here example of my configs and the problem:

https://www.youtube.com/watch?v=P_9MJ-f3pHE

Engi23, 2020-07-15:
1. The offset does not go there, the printer does not enter the table with the sensor. Try an offset of X -100 instead of 100.
2. Naturally, you need to check that the sensor sees metal - the lamp on the sensor lights up.
3. It is advisable to check that the printer sees the signal from the sensor, for example by connecting it instead of Z home. Perhaps the sensor is incorrectly electrically connected or the type in the firmware is incorrectly selected (open / close)

mks-viva, 2020-11-11:
@themacboy
Has this problem been resolved?

themacboy, 2020-11-12:
yes, thx I have learned a lot since this question.

Closed 2020-11-12.

Thread 30 (2020-06-11):

TFT35 screen

usebaz, 2020-06-11:
Hi,
I want to try add support of TFT35(Robin TFT 3.5, Sapphire Pro) with Robin Nano to Klipper. When I can find more info about screen(type of microscheme, maybe some docs how work with it)?
Thanks

makerbase-mks, 2020-06-16:
Hi! Do you want to know information about Robin TFT35, such as the driver IC of the screen, connection method, initialization...

usebaz, 2020-06-16:
I need realize similar function: https://github.com/KevinOConnor/klipper/blob/master/klippy/extras/display/st7920.py
and for it I want as much information as possible about Robint TFT35. Thanks!

mks-viva, 2020-10-22:
MKS Robin TFT35:
1. FSMC 16bit
2. use ILI9488
3. 320*480
About inital code, you can refer to : https://github.com/makerbase-mks/Mks-Robin-Nano-Marlin2.0-Firmware

mks-viva, 2020-11-03:
I will close this question temporarily

Closed 2020-11-03.

Thread 31 (2020-06-13):

[1.0] Configuring stepper driver in robin_nano_config.txt

mgcrea, 2020-06-13:
I have an Flsun Q5 that is using this board with 3 TMC2208 drivers for X,Y,Z and a cheaper driver for E1. I have bought a spare TMC2208 driver but I'm not sure how I can configure it. Here is the `robin_nano_config.txt` file that came with the printer:

[robin_nano_config.txt](https://github.com/makerbase-mks/MKS-Robin-Nano/files/4774352/robin_nano_config.txt)

mgcrea, 2020-06-15:
Driver does work out of the box (in legacy mode, no UART), you just have to inverse the extruder direction (using `>EXT0_INVERSE 0` in the `robin_nano_config.txt` before flashing.

Closed 2020-06-15.

Thread 32 (2020-06-17):

MKS Robin Nano boot loader

haxiny, 2020-06-17:
Hi, i need MKS Robin Nano BOOT LOADER. Does anyone have it?

Spider84, 2020-06-18:
I have from nano 1.1 with TFT3.2

haxiny, 2020-06-18:
> I have from nano 1.1 with TFT3.2
Please....Can you upload it? Thank you very much! I need it!

Spider84, 2020-06-18:
[MKS-Robin-Nano-Bootloader.zip](https://github.com/makerbase-mks/MKS-Robin-Nano/files/4798525/MKS-Robin-Nano-Bootloader.zip)
This loader don't flash nano35 firmwares...
Let me know if you can find TFT35 board owner :) I'll show way how to download bootloader from work board.

haxiny, 2020-06-18:
OK!Thank you very much!
I will find it!

------------------&nbsp;原始邮件&nbsp;------------------
发件人: "Alexey Belyaev"<notifications@github.com&gt;;
发送时间: 2020年6月18日(星期四) 晚上8:36
收件人: "makerbase-mks/MKS-Robin-Nano"<MKS-Robin-Nano@noreply.github.com&gt;;
抄送: "Mr.张"<6046246@qq.com&gt;; "Author"<author@noreply.github.com&gt;;
主题: Re: [makerbase-mks/MKS-Robin-Nano] MKS Robin Nano boot loader (#32)

MKS-Robin-Nano-Bootloader.zip
 This loader don't flash nano35 firmwares...
 Let me know if you can find TFT35 board owner :) I'll show way how to download bootloader from work board.

—
You are receiving this because you authored the thread.
Reply to this email directly, view it on GitHub, or unsubscribe.

nickrodie, 2020-06-30:
> [MKS-Robin-Nano-Bootloader.zip](https://github.com/makerbase-mks/MKS-Robin-Nano/files/4798525/MKS-Robin-Nano-Bootloader.zip)
> This loader don't flash nano35 firmwares...
> Let me know if you can find TFT35 board owner :) I'll show way how to download bootloader from work board.

I'd be happy to help. It won't be a problem I've downloaded boot loader before. Just can't remember exactly how so instructions required. Nano V1.2 TFT 35

Spider84, 2020-06-30:
Download and compile this firmware https://github.com/Spider84/MKS-Robin-Bootloader (or I can give compiled)
Flash it like you flasing regular firmware. And Wait some time (10-15 sec), after take SDcard - it will contain bootloader.bin file.
After this you can flash back default firmware.

nickrodie, 2020-07-01:
Flashed bootloader. Got stuck at end of TFT load 100%. No file saved to SD.

Spider84, 2020-07-01:
Check that SD connected to same pins and spi1.
Alsow try connect to USB-uart and chack "log" in console.

nickrodie, 2020-07-01:
Nah. It doesn't work. The documentation is all available.

Spider84, 2020-07-01:
you flashed only bootloader? Which one?

nickrodie, 2020-07-01:
I built the nano35 from your source

Spider84, 2020-07-01:
Can you connect USB cable to you printer and open terminal on pc immediately after turning printer on with 115200 bps?
And wait 10-15 seconds. It must print STM32F103ZET6 and then error if error ocured.

nickrodie, 2020-07-01:
I would hope it didn't I have a VET chip

Spider84, 2020-07-01:
[Robin_nano.zip](https://github.com/makerbase-mks/MKS-Robin-Nano/files/4856995/Robin_nano.zip)
Can you test this?

nickrodie, 2020-07-01:
Ok that one worked.
Was a bit too tired yesterday. Had a fresh look this morning.
If I compile the source I notice my files are about 28kb. Not sure why they larger than yours. I get nothing back from console.
I ran your original compiled version with console and it failed because couldn't get sd access. I noticed it was built for ZET6 though.
Tried the latest version you sent. Success :)
[Robin_nano35_bootloader.zip](https://github.com/makerbase-mks/MKS-Robin-Nano/files/4861259/Robin_nano35_bootloader.zip)

nickrodie, 2020-07-01:
FYI fan didn't rotate. I have bare board with nothing but screen attached atm.

Spider84, 2020-07-02:
thx!.

mks-viva, 2020-11-03:
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
I will close this question temporarily.

X-Ryl669, 2021-01-07:
I've set up a [blog post](https://blog.cyril.by/en/3d-printers/mks-robin-nano35-advanced-debugging) about how to use this bootloader after unlocking it so you can debug the board a lot more easily

X-Ryl669, 2021-01-07:
@mks-viva The bootloader's HEX file in this repository does not work: it's 1.2MB, you can't program it on the 512kB flash, or I'm missing how you do that.

mks-viva, 2021-01-07:
OK, I need to report this issue to the engineer.

poon-holder, 2022-03-21:
Why are the robin boards so quirky?  X-Ryl blog is very informative. many thanks for putting that together.
I have had a huge headache flashing a v1.1 and now v1.3 both got stuck at "Updating 100%" often changing the .bin file to the correct extension. however the do not properly flash and will not communicate over usb with host. It seems only trial and error works with these boards...?

Thread 33 (2020-06-18):

Nozzle fan.

fenoloji, 2020-06-18:
Can three nozzle fans be connected to this socket(PB1)?
Each fan works with 50mA current. Total 150mA.
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

makerbase-mks, 2020-06-19:
Hi! This is no problem.

fenoloji, 2020-06-19:
Thank you..

Closed 2020-06-19.

Thread 35 (2020-06-18):

Connection time out error MKS robin nano board

Jasontwd, 2020-06-18:
HI,
After several months of successful prints.
My board is now having connection time out issues and the printer halts mid print after 2 or so hours and waits for commands. I use Octoprint to drive this via Rpi4 and up to date octo firmware.
Ive tried:

1. New USB cables, still same issue
2. Using Slicer to directly communicate to board, still same issue
3. Replaced Rpi4 with new

What else can anyone think this might be??

cheers
jason

Miraculix200, 2020-06-19:
Tried a lower connection speed yet?

makerbase-mks, 2020-06-19:
Hi! You can try to change buadrate to 115200.

Closed 2021-09-02.

Thread 36 (2020-06-19):

Flashing firmware via MKS Slot2 fails

Miraculix200, 2020-06-19:
I have a problem with my MKS Slot2 SD card extension connected to MKS Robin Nano v1.2.

When I try to flash a firmware with the SD card connected to MKS Slot2, it says "TFT flashing" on the display and jumps from 1% straight to 100%. But the firmware is still the same as before.

When I flash it through the onboard SD card slot, then everything works fine.

Is this normal? Or is there anything I can do about it?

Note that I cut the MKS Slot2 cable and soldered it to make it about 20cm longer. But my MicroSD to SD card extension has about the equal length and doesn't create that problem.

makerbase-mks, 2020-07-08:
The line is same as?

Miraculix200, 2020-07-08:
Yes, it's the same. Just longer.

Are the lines the same on the board? MKS Slot2 connector and SD card connector have the same lines?

mks-viva, 2020-12-01:
Hi! This phenomenon is that the cable is too long, which leads to an error in reading the SD card firmware. It is recommended to use a short cable.

Closed 2020-12-01.

Thread 37 (2020-06-21):

Miniature distortion when printing Mks_Nano35_V2.0.3.1 (decided)

Engi23, 2020-06-21:
When sending a print via wi fi, a distorted picture is displayed on the screen.
Use ultimaker cura + mks plugin wifi 1.0.2
firmrare  Mks_Nano35_V2.0.3.1
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

Engi23, 2020-07-08:
The problem is resolved. You need to use the latest version of the plugin mks plugin wifi https://github.com/Jeredian/mks-wifi-plugin

Closed 2020-07-13.

Thread 38 (2020-06-24):

White screen on when i printing

pablorusso88, 2020-06-24:
hi!

i have a two tree printer on fw 2.0.1

why when I'm printing my screen turns white?
I touch the screen and it doesn't come back, but it does respond because sometimes I touch something and it stops printing

thanks!
i new on this

n0xxA1337, 2020-08-02:
I have the same problem on Mks_Nano35 V2.0.3.3. Are you printing from Octoprint or the SD card ?

pablorusso88, 2020-08-03:
SD card, the fw 2.3.1 works fine

makerbase-mks, 2020-08-11:
You can try to update firmware to latest version

wealthybigpenis, 2021-01-23:
i am also having this problem with 2.03.5. it only happens about about an hour into printing once the display has gone to sleep. when i touch it to wake it up i have a white screen the rest of the print

mks-viva, 2021-01-25:
@wealthybigpenis
Can you provide some picture to me when you printing?

wealthybigpenis, 2021-01-27:
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
Just a solid white screen. Been printing about 3 hours.

mks-viva, 2021-01-29:
Is printing still in progress? Just the screen cannot display information?

wealthybigpenis, 2021-01-29:
Yes the printing continues and finishes however the printer has to be power cycled before the screen will start working again

mks-viva, 2021-02-01:
What seems to affect the display

rubiotel, 2021-02-09:
Exactly the same thing happens to me, after 2 or 3 hours of printing, I have to turn off the printer and when I try to load filament (outwards) the Z rises.

iMarkus, 2022-11-14:
Noticed the same on a TwoTrees Bluer printer with Marlin 2.1.1
Sometimes this happens directly after starting the printing process via OctoPrint.

Printing process is not affected.

Thread 39 (2020-06-29):

How can I setup my new thermistor?

themacboy, 2020-06-29:
Just purchased a PT100 thermistor and a V6 clone hotend.

How can i setup all this in this printer?

nickrodie, 2020-07-02:
Change robin_nano35_cfg.txt from `>TEMP_SENSOR_0		1		#1: 100k thermistor£»-3 : thermocouple with MAX31855` to `>TEMP_SENSOR_0		-5		#-5 : PT100 / PT1000 with MAX31865 (only for sensors 0-1)`

makerbase-mks, 2020-07-04:
Hi! If you use MAX31855, you need chnag it to -3

nickrodie, 2020-07-04:
FYI here's the Marlin comments from configuration.h
`/**
 * --NORMAL IS 4.7kohm PULLUP!-- 1kohm pullup can be used on hotend sensor, using correct resistor and table
 *
 * Temperature sensors available:
 *
 *    -5 : PT100 / PT1000 with MAX31865 (only for sensors 0-1)
 *    -3 : thermocouple with MAX31855 (only for sensors 0-1)
 *    -2 : thermocouple with MAX6675 (only for sensors 0-1)
 *    -4 : thermocouple with AD8495
 *    -1 : thermocouple with AD595
 *     0 : not used
 *     1 : 100k thermistor - best choice for EPCOS 100k (4.7k pullup)
 *   331 : (3.3V scaled thermistor 1 table for MEGA)
 *   332 : (3.3V scaled thermistor 1 table for DUE)
 *     2 : 200k thermistor - ATC Semitec 204GT-2 (4.7k pullup)
 *   202 : 200k thermistor - Copymaster 3D
 *     3 : Mendel-parts thermistor (4.7k pullup)
 *     4 : 10k thermistor !! do not use it for a hotend. It gives bad resolution at high temp. !!
 *     5 : 100K thermistor - ATC Semitec 104GT-2/104NT-4-R025H42G (Used in ParCan & J-Head) (4.7k pullup)
 *   501 : 100K Zonestar (Tronxy X3A) Thermistor
 *   512 : 100k RPW-Ultra hotend thermistor (4.7k pullup)
 *     6 : 100k EPCOS - Not as accurate as table 1 (created using a fluke thermocouple) (4.7k pullup)
 *     7 : 100k Honeywell thermistor 135-104LAG-J01 (4.7k pullup)
 *    71 : 100k Honeywell thermistor 135-104LAF-J01 (4.7k pullup)
 *     8 : 100k 0603 SMD Vishay NTCS0603E3104FXT (4.7k pullup)
 *     9 : 100k GE Sensing AL03006-58.2K-97-G1 (4.7k pullup)
 *    10 : 100k RS thermistor 198-961 (4.7k pullup)
 *    11 : 100k beta 3950 1% thermistor (4.7k pullup)
 *    12 : 100k 0603 SMD Vishay NTCS0603E3104FXT (4.7k pullup) (calibrated for Makibox hot bed)
 *    13 : 100k Hisens 3950  1% up to 300°C for hotend "Simple ONE " & "Hotend "All In ONE"
 *    15 : 100k thermistor calibration for JGAurora A5 hotend
 *    18 : ATC Semitec 204GT-2 (4.7k pullup) Dagoma.Fr - MKS_Base_DKU001327
 *    20 : Pt100 with circuit in the Ultimainboard V2.x with 5v excitation (AVR)
 *    21 : Pt100 with circuit in the Ultimainboard V2.x with 3.3v excitation (STM32 \ LPC176x....)
 *   201 : Pt100 with circuit in Overlord, similar to Ultimainboard V2.x
 *    60 : 100k Maker's Tool Works Kapton Bed Thermistor beta=3950
 *    61 : 100k Formbot / Vivedino 3950 350C thermistor 4.7k pullup
 *    66 : 4.7M High Temperature thermistor from Dyze Design
 *    67 : 450C thermistor from SliceEngineering
 *    70 : the 100K thermistor found in the bq Hephestos 2
 *    75 : 100k Generic Silicon Heat Pad with NTC 100K MGB18-104F39050L32 thermistor
 *    99 : 100k thermistor with a 10K pull-up resistor (found on some Wanhao i3 machines)
 *
 *       1k ohm pullup tables - This is atypical, and requires changing out the 4.7k pullup for 1k.
 *                              (but gives greater accuracy and more stable PID)
 *    51 : 100k thermistor - EPCOS (1k pullup)
 *    52 : 200k thermistor - ATC Semitec 204GT-2 (1k pullup)
 *    55 : 100k thermistor - ATC Semitec 104GT-2 (Used in ParCan & J-Head) (1k pullup)
 *
 *  1047 : Pt1000 with 4k7 pullup
 *  1010 : Pt1000 with 1k pullup (non standard)
 *   147 : Pt100 with 4k7 pullup
 *   110 : Pt100 with 1k pullup (non standard)
 *
 *  1000 : Custom - Specify parameters in Configuration_adv.h
 *
 *         Use these for Testing or Development purposes. NEVER for production machine.
 *   998 : Dummy Table that ALWAYS reads 25°C or the temperature defined below.
 *   999 : Dummy Table that ALWAYS reads 100°C or the temperature defined below.
 */`

Closed 2020-07-24.

Thread 40 (2020-06-30):

File upload via wifi error

nickrodie, 2020-06-30:
When I try to upload gcode via wifi from pronterface it fails with `[ERROR] Can't write to printer (disconnected?) (Socket error 10054): An existing connection was forcibly closed by the remote host` and at top right corner of TFT I get `Err5`
Can anyone help?

Nano V1.2
TFT 35
Mks_Nano35_V2.0.3.2

Engi23, 2020-07-06:
I use ultimaker cura, Mks_Nano35_V2.0.3.1 it work. Try to place the printer not far from wifi. microSD inserted? The problem is not fully described. Is the printer connected to the wifi? Does the program see the temperature of the extruder, etc.?

mks-viva, 2020-12-01:
I think your plug-in should be updated to the latest. You can check the wifi connection status on Robin TFT35, etc.

mks-viva, 2021-01-18:
Hi! If have not response, i will close this issues temporarily.

Closed 2021-01-18.

Thread 41 (2020-07-04):

linear Advance

jan-mike, 2020-07-04:
Add Linear Advance on LCD setting on latest firmware

Please maybe you can ADD linear Advance on latest firmware so that it is easy to adjust on LCD Display..

Thank you

Engi23, 2020-08-11:
I ran a test with a k factor from 0 to 2 and I don't see any difference. Apparently the Linear Advance is off.
You can at least turn on Linear Advance? Please...

jan-mike, 2020-08-11:
I have no idea how to enable the linear advice. Maybe some can add the
linear advance seeting on the display setting so that no need to configure
on firmware.

Jan

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

RFSTER, 2021-06-22:
In order to use Linear Advance, your steppers need to be operating in UART mode. By default they are using Step/Dir mode. This requires hardware mods if you are using a MKS Robin Nano V1.1 or V1.2. On other more recent boards, it is a matter of setting the jumpers under the stepper driver boards correctly. You also need to adjust your FW. Check YouTube. MKS has a series of videos, and one is about UART mode.

themacboy, 2021-06-23:
Linear advance needs Uart mode? Why? There is any reference to that
sentence in Marlin docs?

El mié., 23 jun. 2021 0:38, RFSTER ***@***.***> escribió:

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

RFSTER, 2021-06-23:
Sorry I forgot to mention that applies to TMC2208 (which I was assuming you had). It may be different for other stepper drivers, but this is a well known fact for TMC2208. I have a Robin Nano V1.2 with TMC2208. Linear advance made no difference just as you described. I did the modification here: https://youtu.be/7ShcFKXrVHo  ; and then linear advance worked as it is supposed to.

themacboy, 2021-06-24:
> Sorry I forgot to mention that applies to TMC2208 (which I was assuming you had). It may be different for other stepper drivers, but this is a well known fact for TMC2208. I have a Robin Nano V1.2 with TMC2208. Linear advance made no difference just as you described. I did the modification here: https://youtu.be/7ShcFKXrVHo ; and then linear advance worked as it is supposed to.

Please read my question. Thx

RFSTER, 2021-06-24:
As far as I can tell, your question is" "why "and if "there is any reference in Marlin documentation."
I don't know why, I have not seen reference in Marlin docs, but I just know it is the way it is with TMC2208. If I recall, you also have to run in SpreadCycle mode (which is why you need UART).
This seems to be due to some sort of bug with TMC2208 and Marlin documentation is not going to include every bug for every hardware.
If you spend some time to google "TMC2208 linear advance", you will find a lot of people having this issue; and a lot of people having success by running UART/SpreadCycle mode.
https://github.com/MarlinFirmware/Marlin/issues/11825

Either way, I'm just telling you what works for me with a MKS Robin Nano V1.2 and TMC2208.

Thread 42 (2020-07-06):

Problem with original firmware

grau0, 2020-07-06:
Hello everyone, I just got the nano v1.2 + TFT 35 + TMC2209 MKS V2 + WIFI, and I have a problem with allí original firmware.
The motors only rotate in one direction, even though I try through the LCD it does not rotate (if reversing the rotation in the LCD rotates the other way, but not both ways).
If I load marlin, it works fine, but the icons on the LCD come out without text.
Can somebody help me?
Thank you.

Engi23, 2020-07-07:
It looks like you haven't completed the move home. Immediately after switching on, not all movements work. Make a move home and the movement will work both ways.

makerbase-mks, 2020-07-07:
Can you provide vidoe to me about your board runing? for example, move motoer and so on.

Thread 44 (2020-07-07):

Motor shutdown does not work immediately

Engi23, 2020-07-07:
Mks_Nano35_V2.0.3.1
1. I go to the home movement menu and start the home movement. Sometimes you need to interrupt the movement, for example, if the switch is far. But pressing “Turn off the motors” does not turn off the motors immediately, but only when the limiter switch is pressed. Sometimes the limit switch cannot be pressed due to a mechanical problem, it is usually one of the first starts and I am ready for it, I click Turn off the motors, but the motor continues to work spoils the belt, etc.
2. Going home during the printing process is also unsafe. Sometimes the limit switch cannot be pressed. The printer is unreasonably trying to move the axis for a long time, I expect that the movement home should not exceed # Travel limits after homing (units are in mm)
((X_MAX_POS)-(X_MIN_POS))*1,2 (20% запаса)

makerbase-mks, 2020-07-08:
For your first question, I think Turn off motor when you moving motor is can not, because firmware this function is need motor enter stop status, so, we need wait motor stop and turn off motor(disable drive)

Engi23, 2020-07-09:
Do not understand the second answer. What distance will the motor travel if the limit switch is not pressed?

Thread 45 (2020-07-07):

update the display measurements of the Robin Nano v2

nictronik99, 2020-07-07:
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
Is it possible to add the measurements I have drawn on the image? They are essential to design a case for the display !!

makerbase-mks, 2020-07-08:
OK! This you can refer to Robin TFT35, because MKS TS35 only is longer 15mm than MKS Robin TFT35
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

mks-viva, 2020-10-22:
@nictronik99 https://github.com/makerbase-mks/MKS-TFT-Hardware/blob/master/MKS%20TS35/MKS%20TS35%20V2.0_001/MKS%20TS35%20V2.0_001%20SIZE.DWG

Closed 2020-10-22.

Thread 46 (2020-07-10):

Can't make switching nozzle to work with a digital servo motor

jeor112, 2020-07-10:
Hi

First, sorry if I'm in the wrong forum!
My issue is, that I want to upgrad my dual extruder and dual hotend printer with the Robin Nano v1.2, but unfortunately, I can't set it up in the stock firmware.
So that is why I'm trying to install Marlin v.2.0.X bugfix, but still having troubles to get it to work with switching nozzle.

I also use BLTouch, connected to pin PA8 as servo0 - That is working!

Next I have tried to connect the sw. nozzle servo motor to PA9 or PA10 pins on the Wifi connectors. That didn't work.
Then I have tried PE5, PA4 - still not working.

I'm not sure if my problem is unusable pins or firmware configuration.

I hope you folks can help me!

pins_MKS_ROBIN_NANO.h:

`#ifndef FIL_RUNOUT_PIN
  #define FIL_RUNOUT_PIN  -1  // PA4  // JEOR FIL_RUNOUT not enabled - Pin PA4 used for Sw. Nozzle // MT_DET
#endif

//
// SERVOS
//

#define SERVO0_PIN PA8 //BLTouch
#define SERVO1_PIN PA9 // Sw. Nozzle

//#define SERVO0_TIMER_NUM 8 // E1 STP = 8, Z- = 1

//
// Steppers
//
#define X_ENABLE_PIN       PE4
#define X_STEP_PIN         PE3
#define X_DIR_PIN          PE2`

Configuration.h:

`// A dual-nozzle that uses a servomotor to raise/lower one (or both) of the nozzles
#define SWITCHING_NOZZLE
#if ENABLED(SWITCHING_NOZZLE)
  #define SWITCHING_NOZZLE_SERVO_NR 0
  //#define SWITCHING_NOZZLE_E1_SERVO_NR 1          // If two servos are used, the index of the second
  #define SWITCHING_NOZZLE_SERVO_ANGLES { 20, 250 }   // Angles for E0, E1 (single servo) or lowered/raised (dual servo)
#endif`

`/*
* Number of servos
 *
 * For some servo-related options NUM_SERVOS will be set automatically.
 * Set this manually if there are extra servos needing manual control.
 * Leave undefined or set to 0 to entirely disable the servo subsystem.
 */
#define NUM_SERVOS 2 // Servo index starts with 0 for M280 command

// (ms) Delay  before the next move will start, to give the servo time to reach its target angle.
// 300ms is a good value but you can try less delay.
// If the servo can't reach the requested position, increase it.
#define SERVO_DELAY { 300, 300 }

// Only power servos during movement, otherwise leave off to prevent jitter
//#define DEACTIVATE_SERVOS_AFTER_MOVE

// Allow servo angle to be edited and saved to EEPROM
#define EDITABLE_SERVO_ANGLES`

jeor112, 2020-07-10:
Hmm, don't know what's wrong with the "code insert".
Hope you can read it anyway.

Closed 2020-07-25.

Thread 47 (2020-07-14):

Firmware for Robin nano V2

nictronik99, 2020-07-14:
hi I wanted to know if the mks firmware for Robin nano allows the setting and monitoring of thw stepper current etc.  through UART with TMC 2209

makerbase-mks, 2020-08-11:
Of course, you can settings it by **Settings** -> **Config** -> **Motor settings** -> **TMC Current settings**

Closed 2020-10-22.

Thread 48 (2020-07-17):

MKS PWC does not work when overheated

Engi23, 2020-07-17:
1. I have MKS PWC and I expected that in an emergency (significant overheating) the board would disconnect itself from the power supply, but this did not happen. Heaters are controlled by transistors. It is well known that transistors often turn on during combustion. With settings.> HEATER_0_MAXTEMP 275
the temperature went up to 350 degrees, why didn't the board disconnect from the network ?! It is obvious. This is generally the main point of payment - to protect the house from fire!

makerbase-mks, 2020-08-11:
Hi! Generally speaking, the thermal protection function of marlin can avoid the problem you mentioned.

mks-viva, 2020-10-22:
@Engi23 Has this problem been solved? I will temporarily close it.

Closed 2020-10-22.

Thread 49 (2020-07-17):

Temperature control does not work when I upload files via wifi

Engi23, 2020-07-17:
I turned on the printer and started preheating the M140 S50; M104 S200;
I went to the computer and started sending the wifi via wifi
It's obvious that
1.the temperature of the nozzle did not have time to rise above 100 degrees and the PWM output was about 100%
2. During download, the last state of the PWM or bang-bang output is saved
This time I downloaded a very large file and it took 5 minutes or more to download.
When I approached the printer, smoke came out of the nozzle and the temperature of the nozzle was 350 degrees, with
> HEATER_0_MAXTEMP 275

I often did this, but before that i was just getting error 2 or 6 or 7. But 2 events happened at the same time, I loaded a large file and the nozzle temperature did not have time to stabilize.
Please make sure that the temperature control works during Wifi boot!

M-Coop, 2021-04-30:
Ah I was wondering what the smell of melting plastic on my Flsun Q5 was! Luckily I don't think it did any damage. I assume it's a version of this firmware. Happened whilst I uploaded a file using the wifi. I'll be careful not to preheat

delaosa, 2021-05-06:
Same here with official FLSUN firmware, (V2.5 XYZ 2208 Extruder 4988 firmware), which version are you using?

Thread 50 (2020-07-17):

Latest firmware does not work on Robin nano V2

mgcrea, 2020-07-17:
I received an [MKS Robin Nano V2.0 from AliExpress](https://www.aliexpress.com/item/4001185795620.html) that I had to reflash to configure a delta printer (FLSUN Q5).

Did reflash with the latest [Mks_Nano35_V2.0.3.3 Release file.rar](https://github.com/makerbase-mks/MKS-Robin-Nano/tree/master/Nano%20firmware%20v2.x.x)

Unfortunately the printer does not work anymore as I have a blank white screen after boot:

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

What firmware should I upload to have the printer work? Thanks!

nictronik99, 2020-07-17:
I believe that the only firmware running on Robin nano v2 is currently Marlin-based.

mks-viva, 2020-10-22:
@mgcrea You can update the lastest firmware and test it, MKS has add a lots of function, include change partmeters by MKS TS35 online

Closed 2020-10-22.

Thread 53 (2020-07-19):

Problem after update v2.0.3.3 in a Robin Nano v.1.2 ...

themacboy, 2020-07-19:
Hello ! There are (at the moment 2 issues)

After update the update files aren't removed, then after each restart firmware is updated again (if I dont removed those files manually):

Btw, In the About section (in the mother board setup) there isn't information about Type and Firmaware version. It is blank.

Please can you crorrect it.

mks-viva, 2020-11-16:
Hi! About 2 issues
1. You need to delete the folder
2. About firnware version information, mks has open parmeters in config, you can define it
3. Can you provide your config file to me?

Thread 54 (2020-07-23):

Inductive sensor z-offset settings?

Marcookl, 2020-07-23:
Hello, i have a problem with the Inductive sensor.  On the MKS Base_L V2.1 There was an option for the Z-offset function so i can adjust the height for the z-offset after homing but on the Robin Nano the z-offset function is gone i looked into the software and the draw-zoffset.ccp is there not anymore?!? How i can fix this?

Regards,
Marco

Thread 55 (2020-07-24):

Can we upgrade MKS-Robin-Nano firmware v2.x.x to MKS-Robin-Nano v1.2 Board

cemiloztas, 2020-07-24:
There is no clear information about it.
Can we upgrade MKS-Robin-Nano firmware v2.x.x family to MKS-Robin-Nano v1.2 Board. Or we need v2.x board.

And i upload Marlin2.0 to V1.2 board but it does not work. Screen is black.

nictronik99, 2020-07-25:
I'm not sure I understand your question, but I try to answer you: MKS Robin Nano firmware is only for Robin nano v1.1 or 1.2 Both v1.x.x and v2.x.x.
On Robin nano v2 runs only  Marlin 2.x.
To load Marlin 2.x on Robin nano v1.2 you must make sure that the names of the board and the environment are set correctly. When you compile the firmware on VSCode you find compiled firmaware robin_nano35.bin  in the directory .pio / build / mks_robin_nano35 you don't have to use the one in the firmware folder, from that folder you have to take only the other two elements present, not the .bin

thierryzoller, 2020-07-25:
To run marlin 2.0 on Nano Robin 1.1 & 1.2 look here:
https://github.com/le3tspeak/Marlin-2.0.X-MKS-Robin-Nano

wbucket, 2020-09-26:
I just bought a new v1.2 broad and it came pre-installed with v2 firmware. Hope this means u can flash v2 firmware onto v1.2 broad.

Thread 57 (2020-07-28):

Hotbed temperature issue

WesleyvH, 2020-07-28:
Hello,

I'm building a DIY 3D printer with a MKS Robin Nano v1.2 with 3.5" touchscreen.

I connected everything and it works except for the hotbed, it keeps reading a temperature of 103 degrees Celsius even when it's cold. I tried to heat it up by increasing the temperature to 145 degrees Celsius which is max, and it heats up to about 40 degrees Celsius and then gives me Err6 on screen and stops heating.

Is there a way to fix this? Can i change thermistor type or thermostat type of the hotbed in the firmware?

makerbase-mks, 2020-08-11:
The maximum temperature that the hot bed can reach depends on its power and has nothing to do with the motherboard. You should replace the hot bed with a higher power instead of measuring the temperature.

mks-viva, 2020-11-16:
@WesleyvH
I will close this question temporarily.

Mrjavaci, 2021-10-04:
I am having the same problem.
How do I fix this problem?

WesleyvH, 2021-10-04:
Check your wiring, i accidently switched up 2 wires of the hotbed. I found out, switched them the way they should and that fixed the problem.

Mrjavaci, 2021-10-06:
I solved problem with reset machine firmware.

Closed 2020-11-16.

Thread 58 (2020-08-02):

Inconvenience of printing

Engi23, 2020-08-02:
I would like to draw your attention to an important feature. When you click on the "Print" button, a list opens starting with the oldest files, you need to scroll down and each time it takes longer and longer. Make it so that the bottom page (the most recent files) opens immediately, this is convenient when you print from a USB flash drive. This is convenient if you print via wifi and you need to run the last file again (sometimes 50-100 files accumulate on the flash drive)

mks-viva, 2020-10-22:
@Engi23 This suggestion is very good, we will consider it comprehensively, thank you for your feedback.

Thread 60 (2020-08-20):

PARAMETER PROBLEM MKS1.2

Yetreyert, 2020-08-20:
I created my firmware by modifying the master firmware that marlin 2.0 that I find on the site, the print works well but the tft35 remains in simple mode. if I try to generate a firmware for tft35 from your tools it doesn't change anything and the words under the icons disappear

mks-viva, 2020-10-23:
If you use the configuration tool and no text is displayed at the end, then you need to update the font for it.
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

mks-viva, 2020-12-01:
I will close this issues temporarily.

Closed 2020-12-01.

Thread 61 (2020-08-21):

Hardware: MKS robin nano uses 5v for io voltage supply

Teslafly, 2020-08-21:
Since the micro controller is 3.3v, the io voltage should be 3.3v. this can cause intermittent issues with the tmc2209 driver if you are sending it 3.3v logic and it is using 5v for determining if the signal is high or low.

at the vary least the logic voltage supply for the stepper motors should be selectable if not permanently changed to 3.3v.

Figured this out after connecting the uart pins on the tmc2209 to the wifi uart and had problems communicating with more than 2 drivers. the uart high voltage would sag too low.

Teslafly, 2020-08-21:
this is on the mks robin nano hw V1.2

mks-viva, 2020-10-23:
@Teslafly Thank you for your feedback, we will consider it comprehensively.

mks-viva, 2020-12-01:
Hi! I will close it temporarily.

Closed 2020-12-01.

Thread 63 (2020-08-27):

Problems with the MKS 3D TOUCH, add the offset.

pistachin2, 2020-08-27:
Hello, I have the original MKS 3DTOUCH mounted, and its operation is correct.
The problem comes when the second and subsequent autolevels are performed. The offset of Z is added, that is, each time an autolevel is carried out it adds the deviation, and when printing the nozzle it is separated more and more from the bed.
The first impression (just calibrated according to the MKS video) is perfect, the second the filament barely reaches the bed, and the third and successive you can imagine, a ball of filament.
At the start GCODE I have to perform a G28 and G29, and it happens with firmware 2.0.3.2, 2.0.3.3 and 2.0.3.4. With later fimrwares I have not tried.
Thank you very much.

hbismis, 2020-09-01:
hi, i have a same problem my nano v1.2 motherboard z offset is always chancing when print restart or resume.
i connet the sensor for auto leveling and is working but when is start to pirint there is a 5-6 mm diffirenc and if i set zoffset -5-6 mm, than 3-4mm more this time can u help me

Thread 64 (2020-09-01):

Unable to flash with a different tft attached

adams79, 2020-09-01:
I'm using the MKS Robin nano 1.2 with a TFT24 that is already mounted in my printer. Unfortunately to flash the firmware I'm forced to connect the TFT35 otherwise the flash doesn't start. Is there a way to flash the board without connecting the TFT 35 display?

adams79, 2020-09-01:
Solved, it's required to rename the file to Robin_nano.bin

Closed 2020-09-01.

Thread 68 (2020-09-18):

Missing advanced settings after firmware update

rodrigowebjump, 2020-09-18:
Hi,

After updating the firmware, the machine settings (step, invert, ...) in the setting menu was missing.
I already tried to updated the firmware using both Marlin, MKS 1.x and 2.x and the menu is never shown.

What I need to do to see this menu again.
In settings I have: Wifi, Fan, about, Filament, continue, language.

There is a blank space between continue and language that was the space reserved for this missing menu.

Thanks

rodrigowebjump, 2020-09-20:
Hi I just discovered that this is enabled by the following line on robin_nano35_cfg.txt.

>MACHINE_PARAMETER		1

How can I enable this menu in Marlin?

mks-viva, 2020-11-07:
If define MACHINE_PARAMETER  1 DIY moudle
If define MACHINE_PARAMETER 0  parameter cann't be change

Thread 69 (2020-09-22):

Uart menu options support

costelasleontin, 2020-09-22:
Will there be options for uart (maybe even spi) in the cfg.txt file to activate and configure it? And be able to activate/deactivate stealthchop from menu, change currents, etc...

makerbase-mks, 2020-09-23:
Nano V1.2？

costelasleontin, 2020-09-24:
Oh sorry. Yes it's board is mks Robin nano V1.2 and screen is mks Robin Tft35.

makerbase-mks, 2020-09-24:
Use it has uart setting: https://github.com/makerbase-mks/Mks-Robin-Nano-Marlin2.0-Firmware

Closed 2020-10-22.

Thread 70 (2020-09-22):

Nano V1.2 on Delta, is it possible?

pistachin2, 2020-09-22:
Hhello everyone, I have a Nano V1.2 mounted on a CoreXY running like a shot.
I have built a homemade Delta, and wanted to know if anyone has this plate mounted on a Delta.
I have my doubts with the endstops, since the delta use the max and this board does not have them implemented, although MKS indicates that it is valid for deltas.
Does anyone have this board mounted on a delta printer?
Any connection suggestions?
Thank you very much.

makerbase-mks, 2020-09-23:
If use delta, so your X,Y,Z max connect to X Y Z+ endstop

pistachin2, 2020-10-05:
Hello,
So if I use marlin, the configuration would look like this:
_#define USE_XMIN_PLUG
#define USE_YMIN_PLUG
// # define USE_ZMIN_PLUG // a Z probe
#define USE_XMAX_PLUG
// # define USE_YMAX_PLUG
// # define USE_ZMAX_PLUG_
It is correct or I am wrong.
Thank you very much.

mks-viva, 2020-10-22:
You can enable all

mks-viva, 2021-01-18:
Hi! I will close this issues temporarily.

Closed 2021-01-18.

Thread 71 (2020-09-24):

Pause to change color M600

ivograca, 2020-09-24:
M600 dosnt work on any versions of firmware

mks-viva, 2020-10-22:
Hi! If you use M600 function, so you need enable it.

ivograca, 2020-10-22:
and how to activate the m600 in the MKS firmware

mks-viva, 2020-10-22:
Which motherboard and screen do you use?

ivograca, 2020-10-22:
mks robin nano 1.2 and 3.5 screen in a two trees bluer

mks-viva <notifications@github.com> escreveu no dia quinta, 22/10/2020 à(s)
09:35:

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

mks-viva, 2020-10-22:
Which firmware and version do you use?

ivograca, 2020-10-22:
https://github.com/makerbase-mks/MKS-Robin-Nano-V1.X/tree/master/Nano%20firmware%20v2.x.x
the version is the 2.0.3.4

A quinta, 22/10/2020, 11:50, mks-viva <notifications@github.com> escreveu:

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

mks-viva, 2020-11-07:
You need setting it:
1. In robin_nano35_cfg.txt file enable
```
>MACHINE_PARAMETER		1			#Online parameter(0: disable, 1: enable)
```
2. MKS Robin TFT35: Setting->Machinesettings->Machine->Endstop type->Filament sensor and Open it
3. Your need use fliament sensor connect to MT-DET1 on the motherboard
More information refer to: https://www.youtube.com/watch?v=eubfvnOriuk

mks-viva, 2020-12-01:
Has this issues be resolved, if there is no response, I will temporarily close it.

Closed 2020-12-01.

Thread 73 (2020-09-25):

New to MKS Nano Robin

wbucket, 2020-09-25:
Hi,

I just bought MKS Robin Nano V1.2 that comes with V2.0 firmware to upgrade my Anet A8. Finally set-up with all the connections. Can move, home, heat up and extrude material.

1. When I want to print, after inserting the SD card, the software claims that there is "no files found". There is 2 gcodes in the SD card, so don't know what is wrong.
2. I set-up cura wifi plug in and was able to remotely control the printer. But every time i want to send a print file, there was an error. I was unable to view any files using the view SD card function this way too.

Any idea what i am doing wrong?

wbucket, 2020-10-02:
After reading some other web and testing out certain areas. Realise my SD card might have some errors preventing the board from reading it. Even after formatting it in windows doesn't help. So I downloaded SD Card Formatter and format it again. Then the board can read already. Printed my first print via MKS Nano Robin fitted onto Anet A8.

Closed 2020-10-02.

Thread 77 (2020-11-04):

Why does the preview of printing model appear uncorrectly?

aRTIKa-afk, 2020-11-04:
i have some trouble with preview of printing model, i've attached [photo](https://user-images.githubusercontent.com/63347935/98154877-e18b8900-1eee-11eb-98dc-bff47b19e26c.jpg) and [link]( https://yadi.sk/d/GURvAJYd1yDMLw) to gcode for print this model! I hope that u can find solution for this problem!

mks-viva, 2020-11-06:
You need use the latest mks plug of the cure.

Closed 2020-11-07.

Thread 78 (2020-11-13):

how to use UART mode with TMC2225

system3rd, 2020-11-13:
Hello

I have Robin nano V1.2 with TMC2225 and I don't know how to use UART mode.

as MKS youtube instruction, https://youtu.be/7ShcFKXrVHo?t=34  it should be soldered and wired to wifi socket.

but regarding to tmc2225 datasheet, https://wiki.fysetc.com/TMC2225/  tmc2225 don't need to soldering.

please let me know how to use uart with tmc2225.

Thanks~!

mks-viva, 2020-11-13:
Hi! It is easy. You only need settings like follow:
1. Acording to MKS youtube setting X Y Z E wiring
2. Firmware setting and add pin define:
  - Setting drive type is: TMC2208（）
  - Add pin define
  ```
  #if HAS_TMC_UART
  /**
   * TMC2208/TMC2209 stepper drivers
   *
   * Hardware serial communication ports.
   * If undefined software serial is used according to the pins below
   */
  //#define X_HARDWARE_SERIAL  Serial
  //#define X2_HARDWARE_SERIAL Serial1
  //#define Y_HARDWARE_SERIAL  Serial1
  //#define Y2_HARDWARE_SERIAL Serial1
  //#define Z_HARDWARE_SERIAL  Serial1
  //#define Z2_HARDWARE_SERIAL Serial1
  //#define E0_HARDWARE_SERIAL Serial1
  //#define E1_HARDWARE_SERIAL Serial1
  //#define E2_HARDWARE_SERIAL Serial1
  //#define E3_HARDWARE_SERIAL Serial1
  //#define E4_HARDWARE_SERIAL Serial1

  //
  // Software serial
  //

  #define X_SERIAL_TX_PIN                   PA10
  #define X_SERIAL_RX_PIN                   PA10

  #define Y_SERIAL_TX_PIN                   PA9
  #define Y_SERIAL_RX_PIN                   PA9

  #define Z_SERIAL_TX_PIN                   PC7
  #define Z_SERIAL_RX_PIN                   PC7

  #define E0_SERIAL_TX_PIN                  PC13
  #define E0_SERIAL_RX_PIN                  PC13

  // Reduce baud rate to improve software serial reliability
  #define TMC_BAUD_RATE                    19200
  #endif // TMC2208 || TMC2209
  ```

system3rd, 2020-11-13:
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

Thanks for your reply!!
but tmc 2225 datasheet has different board layout with tmc2208. (R8 and UART -> TX and RX)
do I have to soldering TX and RX on tmc2225? and wiring to wifi socket as mks youtube?

mks-viva, 2020-11-13:
You can connect to RX and test it. Tx need not connect.
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

system3rd, 2020-11-13:
> You can connect to RX and test it. Tx need not connect.
> 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

OK. soldering RX and wiring to wifi socket!! I will try this weekend. Thanks!!

mks-viva, 2020-11-16:
It is will working?

mks-viva, 2020-12-01:
Has this issues be resolved, if there is no response, I will temporarily close it.

adamo000, 2022-11-26:
@mks-viva, how about Robin Nano 1.3-s? Is it possible on this version?
The mainboard has 4x soldered TMC2225 with 1x pluggable driver.

Serox13, 2023-10-02:
> @mks-viva, how about Robin Nano 1.3-s? Is it possible on this version? The mainboard has 4x soldered TMC2225 with 1x pluggable driver.

you just use the TMC 2208 uart configs in klipper and it should work. TMC2225 and 2208 get used on big tree tech boards and they just use TMC2208 uart configs

Closed 2020-12-01.

Thread 79 (2020-11-14):

Nano 1.2 extruder won't work

WillOrum, 2020-11-14:
I have tested the extruder wire in a different and it works completely fine so no hardware fault. I have tried heating the hot end up to 215 degrees and trying then but to no avail. I have tried swapping out the stepper driver for one I know works but this did nothing also. Printer is a TwoTrees Sapphire Plus

Any help would be appreciated.

Thanks,
Will

WillOrum, 2020-11-15:
Issue resolved. A combination of faulty wire and an unintuitive printer interface was the issue

Closed 2020-11-15.

Thread 80 (2020-11-25):

MARLIN 020007 does not compile on NANo v1.2

Frederic-SABU, 2020-11-25:
Trying to upgrade to MARLIN 020007 on a SAPPHIRE PRO but will not compile on platform.io. MARLIN 020000 works fine but I wanted to get the MARLIN color UI.
Can you help ?

mks-viva, 2020-11-25:
Can you provide your firmware to me and i will build it and test it?

Frederic-SABU, 2020-11-25:
Thks but I have trashed it in the meantime since I have managed to
compile a MARLIN 2.00.6 adapting it from a FLSSUN Q5 (NANO v1.2 + TFT 2.4).

I wanted to be able to use the MARLIN Color UI with a touch screen but
in a larger TFT (3.5).

Cheers,
Frd

Le 25/11/2020 05:08, mks-viva a écrit :
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

mks-viva, 2020-11-25:
You use MKS Robin Nano V1.2+MKS Robin TFT35?

Frederic-SABU, 2020-11-25:
No I was referring to a Nano v1.2 with a flat cable 3.5 TFT (OEM on a
Sapphire pro).

Works great with Touch Screen Marlin (2.0.6) and Color UI.

Frd

You use MKS Robin Nano V1.2+MKS Robin TFT35?

mks-viva, 2020-11-25:
You want to use Nano v1.2 with a flat cable 3.5 TFT run the latest version marlin firmware color UI?

Frederic-SABU, 2020-11-25:
Yes but I am already running version 2.0.6 and I gave a try to 2.0.7
and got "bool" and "random" errors when compiling on Platform io.

Frd

Le 25/11/2020 11:46, mks-viva a écrit :
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

mks-viva, 2020-11-25:
Ok! I will try to test it.

mks-viva, 2020-11-25:
You need set it
In configuration.h file:
Set board: #define MOTHERBOARD BOARD_MKS_ROBIN_NANO
Enable #define MKS_ROBIN_TFT35 and #define TFT_COLOR_UI
Enable #define TOUCH_SCREEN

In platformio.ini file: set default_envs = mks_robin_nano35

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
[Robin_nano35_test_bin.zip](https://github.com/makerbase-mks/MKS-Robin-Nano-V1.X/files/5596282/Robin_nano35_test_bin.zip)
[Marlin-bugfix-2.0.x.zip](https://github.com/makerbase-mks/MKS-Robin-Nano-V1.X/files/5596287/Marlin-bugfix-2.0.x.zip)

Frederic-SABU, 2020-11-25:
No luck, still the same errors, MARLIN from your link.

C:\users\msabu\.platformio\packages\framework-arduinoststm32-maple\STM32F1\cores\maple/wirish_types.h:65:9:
error: unknown type name 'bool'

and

C:\users\msabu\.platformio\packages\framework-arduinoststm32-maple\STM32F1\cores\maple/ext_interrupts.h:90:6:
error: conflicting types for 'attachInterrupt'

Frd

Le 25/11/2020 12:15, mks-viva a écrit :
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

mks-viva, 2020-12-01:
I think it’s a problem with your compilation environment and has nothing to do with firmware.

Frederic-SABU, 2020-12-01:
Could be.
I am running a Marlin v2.0.6. which is compiling just fine for the Nano
v1.2 and let me use the MARLIN Color UI and mostly the touch screen so I
am happy.

Works good for both the TFT 2.4 and 3.5.

Thks for your support anyway.
Rgds,
Frd

Le 01/12/2020 13:34, mks-viva a écrit :
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

mks-viva, 2020-12-02:
Haha! So, I will close this issues.

Frederic-SABU, 2021-01-11:
Hello,

PLATFORM IO must have updated something on their board definition since
ROBIN E3 does not exist anymore and it stopped compiling on my thre E3D
boards with error :

Marlin\src\HAL\HAL_STM32F1\dogm\../../../inc/../HAL/./HAL_STM32F1/fastio.h:30:10:
fatal error: libmaple/gpio.h: No such file or directory

Can you help ?

Rgds,
Frd

Frederic-SABU, 2021-01-11:
Pls disregard, forgot to check your GIT.

Rgds,
Frd

Le 11/01/2021 10:30, MSABU a écrit :
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

mks-viva, 2021-01-12:
@Frederic-SABU You can try to use the latest version marlin test it.

Frederic-SABU, 2021-01-12:
This is what I did in the end from your Git and it works.

Rgds,
Frd

Le 12/01/2021 02:19, mks-viva a écrit :
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

Frederic-SABU, 2021-02-17:
I seem to be unable to find a valid Marlin for the NANO v2.0 on your
github. I need it for a CORE XY machine.

Where can I get it ?

Rgds,
Frd

Le 25/11/2020 12:15, mks-viva a écrit :
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

Closed 2020-12-02.

Thread 81 (2020-11-25):

fillament sensor and step motor

misterry08, 2020-11-25:
2 minutes after the resin identification sensor has run out, all stepper motors are put to rest. It causes a step deviation problem because when changing the resin it moves the X and Y axes because the stepper motor is idle. Can you show me how to keep the stepper motor on to keep the coordinates when out of fillament.

mks-viva, 2020-11-26:
Hi! Which firmware are you using?

misterry08, 2020-11-26:
i use Mks_Nano35_V2.0.3.2

mks-viva, 2020-11-26:
In Configuration_adv.h file
#define DEFAULT_STEPPER_DEACTIVE_TIME 120
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

misterry08, 2020-11-26:
I found the place you pointed out but there was another problem :((
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
which one should I choose now
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
I don't know what to write in this place to stop errors

mks-viva, 2020-11-27:
You need enable a LCD type in configuration.h file, for xexample, if you use MKS Robin TFT35, so you need enable "TFT_LVGL_UI_FSMC"

misterry08, 2020-12-16:
Can you help me fix it?
for me it's really hard.
I use this version so can you edit it and send it to me?
https://github.com/makerbase-mks/MKS-Robin-Nano-V1.X/blob/master/Nano%20firmware%20v2.x.x/History%20Version/Mks_Nano35_V2.0.3.2%20Release%20file.rar

Thread 82 (2020-11-30):

other screen by UART

dacentichka, 2020-11-30:
good day, I have a Robin nano v1.2 with the screen, I was able to connect to it the screen Ewart third party, as it failed to do the firmware with a graphical interface and drivers тмс2209 by Ewart and Sensorless homing and Wi-Fi, the chip on the Board does not have enough memory, and now I have no limit switches, wifi is working fine but the problem is that the Board does not start unless I unplug native tft35, please tell me what settings I need to zakommentirovat in the Marlin 2.xxx to get everything working without native screen?

mks-viva, 2020-12-01:
Hi! I don’t seem to know what you mean, can you describe them precisely?

dacentichka, 2020-12-01:
Yes, of course

dacentichka, 2020-12-01:
now I'll take pictures and attach them

mks-viva, 2020-12-01:
Ok! Waiting your pictures...

dacentichka, 2020-12-01:
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

this is the screen I want to put on

dacentichka, 2020-12-01:
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

this is a screen that I can't disable in the firmware, nothing works without it

mks-viva, 2020-12-02:
Yes, if you need to use UART, then you will not be able to use the original firmware, you need to use the new marlin and support uart mode

dacentichka, 2020-12-02:
the problem is that I built a new Marlin from github Marlin, and the Board without its screen does not work (((tell me what you need to disable in the firmware so that it does not poll the screen when loading??

mks-viva, 2020-12-02:
Haha! You can refer to MKS WIKI：

dacentichka, 2020-12-02:
did you give me the settings for this screen?
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

mks-viva, 2020-12-03:
Hi! There is a difference between MKS TFT35 and MKS Robin TFT35. MKS Robin TFT35 is just a display screen. MKS TFT35 has its own CPU that can work independently and communicate with the motherboard through the serial port.

dacentichka, 2020-12-03:
so how do I make Robin nano 1.2 work without my own screen??? I tried all the options from the table above and when the screen is turned off, the Board stops starting, it does not flash without the screen, and if it is controlled from the screen via UART, it does not respond(((

mks-viva, 2021-01-06:
You need to connect the screen to see the firmware update process, otherwise, it is difficult for you to judge what your motherboard is doing at this moment.

dacentichka, 2021-01-09:
good afternoon, you know your board very poorly, I was helped to deal with my problem by another person on github, he knows about your board garazdo more, below I will describe step by step how to get rid of this useless screen and free up space on the microcontroller. The first step in the firmware is to disable these parameters #define ADVANCED_PAUSE_FEATURE
#define FILAMENT_RUNOUT_SENSOR
#define LCD_BED_LEVELING
#define TOUCH_SCREEN
#define TFT_COLOR_UI
#define MKS_ROBIN_TFT35

After building the firmware file Robin_nano35.rename bin to Robin_nano.bin and put it on the memory card. Disconnect the screen from the board and turn it on. To check that everything has started, you can connect via USB, and after restarting the board flashes the LED of the mosfet of the fan blowing the model, you can also look at it, and then on the Wi-Fi pad on the px and tx connect any display on the uart. This works, but if you then flash the board without a native display 5 times in a row, it goes into protection, then you need to connect the native display back and flash the Robin_nano35 file.bin, and then rename again and flash with the display disabled. I tried to describe in great detail all the subtleties of this process if you have any questions, please contact me.

mks-viva, 2021-01-09:
I am sorry, that we did not consider this way of use. We agree that users only use MKS Robin TFT35.

Closed 2021-08-09.

Thread 83 (2020-12-19):

Can not update firmware

alikosif, 2020-12-19:
Hi. I have a MKS Robin Nano v1.2. I have updated its firmware to V2.0.3.2 three months ago (maybe older) and I stopped wotking on it at that time. Now today ı want to activate my 3d printer, it can not read the micro SD card. I tried many different formats (ntfs, fat32, exfat). Why I want to update firmware: endstop signal must be inverted.

Can anyone help me?
Thank you.

mks-viva, 2020-12-21:
You Tf card need FAT32

alikosif, 2020-12-21:
I tried Fat 32 but it did not work. Card is 16 gb. not only firmware file, robin nano can not read the tf card including g code. is there different solution?

mks-viva, 2020-12-21:
Can you try another card to test it

alikosif, 2020-12-21:
I tried with a different old 8 gb Fat32 formatted tf card and I can update firmware. I'm sorry to discuss a simple problem here. Thank you.

mks-viva, 2020-12-22:
Ha! So, i will close this issues temporarily

pkozlenko, 2021-03-05:
I would like to throw my name in on this issue also.
I currently have the original firmware (never been updated - V2.0.1). I am using an 8GB FAT32 formatted micro SD card. Compiled 'Successfully' using VS Code. Copied 'assets' folder and Robin_nano_v3.bin file created.
I put the SD card into my MKS Robin Nano v1.2 board - and the board boots with no indication that it recognised the SD card whatsoever.
Now - I am not sure whether V3 firmware is too agressive and I should stick to v2 generation. (???)
Any comments?
I am going to try a V2 firmware update now to see if this 'IS' the issue or not.

pkozlenko, 2021-03-05:
Downloaded (MKS-Robin-Nano-V1.X/Nano firmware v2.x.x/Mks_Nano35_V2.0.3.5 Release file.rar) - extracted the file and copied the bin file (Robin_nano35.bin) to the same SD card - message indicated: Updating TFT. Completed. When I select the 'About' on the display it still indicates V2.0.1 for the firmware.
One good point - the SD card was readable.

Closed 2020-12-22.

Thread 84 (2020-12-24):

lights on

Yetreyert, 2020-12-24:
MKS ROBIN NANO 1.2
MARLIN 2.0.6
is it possible to turn a 24v led strip on and off by controlling a pin of the board?

mks-viva, 2020-12-25:
You can use He1 interface and control led by it

Yetreyert, 2020-12-25:
is there a tutorial? or what commands should I enter in marlin?

mks-viva, 2020-12-26:
If your light strip is only powered on, then you can use the He1 interface and use it as an ordinary fan. You can tell me which kind of light strip you use, or provide me with a link

mks-viva, 2021-01-06:
Hi! Does it work properly? If there is no response, then I will close this issue temporarily.

Closed 2021-01-06.

Thread 85 (2020-12-28):

Make the buzzer sound

Tony4aro, 2020-12-28:
Hi,

I saw the other thread about M300 and possibly adding a speaker.  But I know my Robin Nano V1.2 already has a buzzer.  And, I know it works if the filament out sensor trips.   Is there a way to make it sound at the end of a print?  Is there an M or G to just to turn it on and off?  This is with the factory firmware.  (not Marlin)

mks-viva, 2020-12-29:
Hi! I'm sorry, this is not possible.

Closed 2020-12-29.

Thread 86 (2021-01-03):

max31865+pt1000

dacentichka, 2021-01-03:
good afternoon, please tell me how I can connect max31865 + pt1000 to mks robin nano 1.2? and what settings need to be performed in marlin?

Try2beHarder, 2021-01-18:
I am also in with die question.

But i think pt1000 doesnt need a board. I read something about change resistors but i dont know witch 🤷‍♂️.

Thread 87 (2021-01-22):

5V power

Adi146, 2021-01-22:
Hi, is it possible to power the Makerbase Robin Nano V1.2 over a 5V Pin? Like you can power it over USB but over one of the GPIO Pins?

mks-viva, 2021-01-25:
Select power DC5V or USB‘s 5V by jupmers？

Adi146, 2021-01-25:
Yes but which Pins do I have to use for 5V and Ground? Can it be any 5V and Ground?

mks-viva, 2021-01-26:
MKS Robin Nano V1.2 has add USB 5V power select

Closed 2021-04-07.

Thread 88 (2021-01-29):

MAX31855

dacentichka, 2021-01-29:
good afternoon, tell me can I use two MAX31855? one for the hotend and one for the table? in the pin folder there is a second pin for entering from MAX 31855 to pin PE6 in the mt_det2 connector ?

Thread 89 (2021-02-02):

Cooling problem

bl4ck1c3pt, 2021-02-02:
MKS-Robin-Nano-V1.X/Nano firmware v1.x.x/nano32/

After updating to version Mks_Nano_V1.0.4 the cooling fan doesn't start after the extruder heats up.

Do I need to change anything? Do I have to change the wiring?

mks-viva, 2021-02-04:
Hi! What firmware did you use originally?

bl4ck1c3pt, 2021-02-06:
Hello! I was using the original firmware from TEVO (Based on mks robin nano 1.0.1) and my board is v1.1

acca84, 2021-03-11:
Hello
I have the same problem with Robin nano v1.2 and Mks-Robin-Nano-Marlin2.0-Firmware
Did you solve it ?
Thanks

Thread 90 (2021-02-03):

Implementation of G34 (Z Steppers Auto-Alignment)

pistachin2, 2021-02-03:
Hello, I wanted to ask you if you can include the G34 (Z Steppers Auto-Alignment) command within the "robin_nano35_cfg.txt" of the owner signature.
For those of us who have electronics in a CoreXY it would be very useful.
Thank you very much and greetings.

martinrosolino, 2023-07-03:
hey! where you able to set sensorless homing with robin nano v1.2?

madurani, 2023-07-04:
I did it according this how to: https://www.youtube.com/watch?v=7ShcFKXrVHo&t=10s

Thread 91 (2021-02-05):

PB0 and PB1 pins stopped working

Bobby-McBobface, 2021-02-05:
I am using MKS Robin Nano V1.2.
I tried to turn on the fans, but it didn't work.
The fans worked before; they suddenly stopped working.
The fans are working; I probed the PB0 and PB1 pins and they weren't giving out a voltage.
Everything else is working.
I did not update any firmware.

Is my board broken or is this a software issue?

mks-viva, 2021-02-07:
You need check the board is work or is kill by USB connect to pc?

Bobby-McBobface, 2021-02-08:
I found out one of the pins on the board was bent. I have fixed it. Thank you for your help

Closed 2021-02-08.

Thread 92 (2021-02-10):

"#error \"Unknown MOTHERBOARD value set in Configuration.h\"", 	 737,  6,

Lkettlewell, 2021-02-10:
Hello,

I am losing my mind! I have been fighting with, and sadly losing in my battle trying to revive my Ender 3 V1 that hasn't printed since March, poor quality filament damaged my hotend so I changed it for a Triangle Labs V6 Clone, added a Bondtech direct drive extruder, a Triangle Labs NEMA 17 pancake stepper driver, dual Z axis stepper, and paired it all with an MKS Robin Nano V1.2 with the TFT35 (not the cool new SPI version but the ribbon cable version controlling TMC2209 drivers. I also have a MKS BLTouch clone that I need to print a bracket for before installing, as well as I plan to use a Z-MAX sensor, again need to print a mount... I am very much looking forward to having this function again!

I wanted to update the firmware on it with the MKS V2.0.3.5, or whatever the current version is, but found it to be too flakey: not retaining settings, constantly dropping the connection to HE TC giving me an "Err 2" message that would only go away if I reflashed the firmware, it was getting tedious! I have yet to test the stepper motor for the extruder because of the "Err 2" message, I think?! I have checked all of my wiring connections and have everything corrected properly, at least I can get the resistance of every sensor and coil... After x # of days being frustrated, I decided to say "F*** it!" and "I'll just put Marlin on it then!"

This has also increased my frustration as I had to figure out Visual Studio Code after realising that with Arduino IDE I could not compile the proper .bin as the Nano MB is a 32-bit job, onto platformIO! I have gone through all of the configuration / advanced config files, making the appropriate changes, knowing I will have some tweaking to do after I get through basic operation and need to activate my extra components (BLTouch, Z-MAX, some other shiny bits). I was constantly getting 2 error messages when I would try to compile the workgroup, and I eventually managed to smash my way through the first one; the cleared fault just required redefining some pin names / allocations for the dual Z axis from the dual extruder (who knows maybe I will need to change things around if I ever get to building a cabinet and dry-box, I may need a relaying stepper for the filament?). However, the second fault code I cannot get to clear no matter what I have tried, which is the subject of this post. Now, I have pulled the Motherboard value straight from the .\core\boards.h file via copy / paste and it gives the same error.

The interesting part is that previously, I also received a "code error for missing binary value" before the 4013 value; the error showed up in the terminal box if I scrolled through the event log. That error code stopped showing up, but that may be due to the compiler failing sooner in its operation as those would happen in the ~15 second runs, while it is currently making ~ 1 second runs before failure?

Another interesting thing is that while the board is listed as supported, when I tried to use the Marlin Building tool, I also got the same error message and could not get past the first screen.

I have included my config files [lkettlewell-Marlin](https://drive.google.com/file/d/149rugBH3ZAjK91kBWm_tsFvlq3w5Cfce/view?usp=sharing) and see if there is something that sticks out about that line or some other reason for it not compiling that would be much appreciated.

Thanks

organizedkaos, 2021-02-21:
I’m posting from my mobile so I can’t see your files.

I can say that I have been able to compile Marlin2.0.7 with no errors onto my MKS Robin Nano v1.2 with TFT35, tmc2209 drivers in uart mode and sensorless homing on xy, and bltouch.

I compiled marlin with a few changes though which was mainly for the uarts, sensorless homing and I changed from the lvgl gui to the marlin built in tft gui.

It can be done.

Dom749s, 2021-03-02:
Hello,

Modify
```
#ifndef MOTHERBOARD
  #define BOARD_MKS_ROBIN_NANO       4013  // MKS Robin Nano (STM32F103VET6)
#endif
```
to
#ifndef MOTHERBOARD
  #define BOARD_MKS_ROBIN_NANO    // MKS Robin Nano (STM32F103VET6)
#endif

Closed 2021-08-09.

Thread 94 (2021-02-21):

Access SDCard via computer

organizedkaos, 2021-02-21:
I have mks sgen-L boards that allow me to access the sdcard over usb.

I just finished building marlin2.0.7 for my mks robin nano v1.2 and I am unable to access the sdcard via usb.

Is the robin nano v1.2 incapable of this feature?  My sgen-L boards show up as /dev/ttyACM* devices but the mks robin nano v1.2 is showing up as /dev/ttyUSB0 with no access to sdcard.

Closed 2021-02-23.

Thread 95 (2021-02-28):

Update failed

Beachbone, 2021-02-28:
I try to update my Robin nano V1.2 to the Firmware 2.0.3.5
I download the FW from here (Mks_Nano35_V2.0.3.5 Release file.rar)
I extract all the files and customized a few settings for my printer.
Then I copy the 2 folders and the 3 files to a TF Card and insert it in the board.
I start the board and I see the messages that the files are updated. Then the display went black and nothing more happens.
After taking out the TF Card and restart the board I got only a message "Booting..."
Did I desrtoy the board?
What can I Do?

Beachbone, 2021-02-28:
After new formatting the card the update works now.

Closed 2021-03-02.

Thread 96 (2021-03-02):

Thermal Runaway

Beachbone, 2021-03-02:
After assembling my printer, I preheat the hotend. During this time I play a litlle with the settings. and so I changed the E0 nozzle temperature type from NTC to MAX31855. The displays shows an error, but the nozzle DON'T stop heating.
So the hotend overheats -> DANGEROUS
Used FW Mks_Nano35_V2.0.3.5 Release file.rar

Thread 97 (2021-03-11):

TMC2208 Heating

acca84, 2021-03-11:
Hello
I'm wiring A Mks robin nano v1.2 on Tronxy D01 printer
I use TMC2208 for x, y, z and extruder axis
all axis move correctly but one of the driver becomes very hot as soon as the printer is turned on. Other drivers don't have this problem and have the same Current set in marlin firmware

am i lossing something ?

madurani, 2021-03-11:
I had same problem, but current I set up manually via potentiometer on driver TMC2209. My steppers motors have current 0.9A and on driver I set up current 0.6A. After this change driver and motor aren't more hot.

acca84, 2021-03-12:
Ok, thanks my motors have 1,68A rated current, the default voltage on TMC2208 is 1,1v it seams ok if i apply 1,68/1,41
Am i right ?

Is that supposed to apply the correct current if i declare TMC2208 (and not TMC2208 standalone) in Marlin firmware and don't wire UART to Wifi connectors ?

madurani, 2021-03-12:
Should be OK, but very good support for MKS robin nano v1.2 you can find here:https://www.youtube.com/watch?v=d52u0Mss7fI&lc=UgxGzGn41DB5plWRb1F4AaABAg.9KGjfEzHp6S9KKsx5oR9qi
Under video in chat, you can find with my name solution for same issue with a current and hot driver and motor.
In case, that you have some question you can write there and Makerbase Team will response on your question.

Thread 99 (2021-03-26):

Driver extender for secondary z-motor

madurani, 2021-03-26:
Hello All,

Do you have somebody experience with installation of secondary driver to z-axis(second extruder I have plug)? it should be possible via extender: https://www.aliexpress.com/item/1000007369401.html?spm=a2g0o.cart.0.0.11103c00xEgyQe&mp=1
 and here is how to: https://www.youtube.com/watch?v=vIChqkEAuto&t=484s

How do you solve issue with rated current of two motors on z-axis? Motors with "holding torque" more, then 400N.mm have value of rated current approximately between 1.5-1.7A. For two motors it is 2x 1.5 = 3A, but driver tmc2209 has current max only 1.7A.

Closed 2021-06-13.

Thread 100 (2021-03-28):

Robin Nano 1.2 with UART and Neopixel not working.....

galluccib, 2021-03-28:
Have MKS Robin Nano 1.2 with MKS 2209 V2 running Marlin current bugfix and when in standalone NeoPixels are working fine on pin PB2. After switching to UART they no longer work. If I go back to standalone they started working. Only thing added to the pins file is below and configs are attached.

#if HAS_TMC_UART

  #define X_SERIAL_TX_PIN                   PA10
  #define X_SERIAL_RX_PIN                   PA10

  #define Y_SERIAL_TX_PIN                   PA9
  #define Y_SERIAL_RX_PIN                   PA9

  #define Z_SERIAL_TX_PIN                   PC7
  #define Z_SERIAL_RX_PIN                   PC7

  #define E0_SERIAL_TX_PIN                  PC13
  #define E0_SERIAL_RX_PIN                  PC13

  #define E1_SERIAL_TX_PIN                  PA5
  #define E1_SERIAL_RX_PIN                  PA5

  // Reduce baud rate to improve software serial reliability
  #define TMC_BAUD_RATE                    19200
#endif // HAS_TMC_UART

[Configuration.zip](https://github.com/makerbase-mks/MKS-Robin-Nano-V1.X/files/6216863/Configuration.zip)

mks-viva, 2021-09-02:
You can try to the latest version marlin.

Thread 101 (2021-03-29):

écran blanc sur MKS ST35 V2

vosphil, 2021-03-29:
Bonjour, j'ai une carte MKS ROBIN NANO Nano V2, avec un écran MKS ST35V2.
lorsque la carte reboot, âpres avoir mis le firmware "Nano firmware v2.x.x" l'écran reste blanc.
j'ai essayer plusieurs version. mais aucune ne fonctionne .pouvez vous m'aider .
j'ai essayer avec marlin, mais je n'y arrive pas.

merci

mks-viva, 2021-04-14:
You want to update firmware?

Closed 2021-08-19.

Thread 103 (2021-04-04):

I can't upgrade the firmware MKS Robin Nano V1.2 from Micro Sd

Neo70777, 2021-04-04:
Hi
I can't upgrade the MKS Robin Nano V1.2 from TF sd card slot (micro-Sd) in mainboard because it can't read it. I Try with multiple Sdcards and the issue persist.

How can it Upgrade the mainboard?.

Thank you

mks-viva, 2021-04-14:
1、Copy Robin_nano35.bin to TF card
2、Insert TF card to board and repower on

Neo70777, 2021-04-14:
Thank you for your support.

I found the issue now and test it.

I format to Fat 16 and fat 32 the micro sd  from an SD adapter. If format from it the mainboard it don't detect the Micro Sd. I format the micro Sd from smartphone and now detect the Micro Sd card and i upgrade the Mainboard.

Thank so much for your support and attention.

Closed 2021-04-14.

Thread 104 (2021-04-05):

Не происходит возврата в меню "Printing:" из меню "Z Offset" при нажатии кнопки "Назад"

XcLxAd, 2021-04-05:
1. После запуска печати появляется меню "Printing:"
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

2. После выполнения в стартовом G-коде команды G29 автоматически появляется меню  "Z Offset"
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

3. Проблема заключается в том, что при нажатии кнопки "Назад" из меню "Z Offset" происходит выход в стартовое меню, а не в меню "Printing:"
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

4. Прошу сделать выход из меню "Z Offset" при нажатии кнопки "Назад" в меню "Printing:"

Thread 105 (2021-04-21):

Design UI

misterry08, 2021-04-21:
Can you give me the design of UI Version 2.0.6. I need to redesign my style.
Thanks!

misterry08, 2021-04-21:
I use Adobe Illustrator

gensoloone, 2021-04-26:
You take the LogoBuilde program. You translate the icon in the mks_pic folder from the format .bin to image format. You edit it. You convert the edited image back to the bin format. And so with all the files in the mks_pic folder.
You can also use the service for configuring firmware for Robin series cards https://baizhongyun.cn/home/mkstoolview (but there are not all the icons that are in the firmware). I changed the design in both ways. First through the site, then, those icons that can not be changed through the site, edited through LogoBuilder.
----------------------------------------------------------------------------------------------------------------------------------------------
Берешь программу LogoBuilde. Переводишь иконку в папке mks_pic из формата .bin в формат изображения. Редактируешь. Переводишь отредактированное изображение обратно в формат bin. И так со всеми файлами в папке mks_pic.
Также можно воспользоваться сервисом по конфигурации прошивок для плат серии Robin https://baizhongyun.cn/home/mkstoolview (но там не все иконки которые есть в прошивке). Я изменял дизайн обоими способами. Сперва через сайт, затем, те иконки которые нельзя изменить через сайт, редактировал через LogoBuilder.

misterry08, 2021-04-27:
tôi đã làm được điều bạn làm rồi.. Cảm ơn. Thật ra tôi là một nhà thiết kế. Nhưng tôi chỉ cần đổi màu của các biểu tượng nên nếu vẽ lại thì khá lâu. Nên tôi mới hỏi xin thiết kế gốc dạng .Ai hoặc .PSD để đổi cho nhanh

Thread 106 (2021-05-19):

Source for MKS Robin Nano v1.2 TFT35 - Mks_Nano35_V2.0.3.6 Release file.rar

Tomza86, 2021-05-19:
Hi,

I'm using this firmware on my 3D printer: Mks_Nano35_V2.0.3.6 Release file.rar. Great job by the way.
Is it possible to get this firmware with all that settings as source files (I want to change some features)?
I just want to add some extra settings and check why some of the current settings won't work correctly. I have PWC module v3.0 and when the printer ends then is only the message "Closing Machine....". The printer won't shut down like newer.
The features I want to add:
- extra driver on the motherboard and use Z Alignment function. Separated drivers for the double Z axis.
- use the Pause feature (M600) and the advanced park feature.
- Mech bed leveling, I'm using bltouch and instead of endstop on Z-axis and if I want to use autobed leveling then only Z offset appears on the screen.

Thanks

WashingtonJunior, 2022-01-09:
Yeah, this firmware is way better than the open source version. Indeed, MKS could release this code to us, so we can set some new features.

Thread 107 (2021-06-28):

Usb connection problem

acca84, 2021-06-28:
Hello

I have a mks robin nano V1.2 with mks TMC2208 and Marlin.

Last week, i tried to connect the motherboard to pronterface by USB

My printer had a stange behaviour  :
I was not ablle to connect tom COM port
The hotend started to heat without any reason
The Usb cable seemed to become hot, so i immediately disconnected it and didn't try anymore
One of my TMC2208 stopped working

I don't understand why
Please help me.

mks-viva, 2021-08-10:
Please check whether there is a power short circuit problem, such as between USB 5V and GND.

Closed 2021-09-02.

Thread 108 (2021-07-12):

Babystepping Z Offset

WashingtonJunior, 2021-07-12:
Version 2.0.3.6 is not showing babystepping Z offset value (although it moves the axis). Previous version, 2.0.3.5, shows it normally.

Thanks!

steve007iii, 2021-10-21:
It is also difficult to define when an automatic leveling is performed.
babystepping Z offset  values shown on the screen do not work

Smarthelpers, 2022-01-08:
Could anyone find a solution for this problem?

WashingtonJunior, 2022-01-09:
> Could anyone find a solution for this problem?

I've been using version 2.0.3.5, until they release a new version fixing that. This is the closed-source version, so only MKS developers can fix it.

Smarthelpers, 2022-01-09:
Thank you for this information - you are right, the 2.0.3.5 is much better then the 3.6. I made my own firmware with marlin, but unfortunately I could not find a way for getting the z probe wizard included. Its a bit hard to get informations about it and mks seems to Focusing on new products only.

WashingtonJunior, 2022-01-09:
> Thank you for this information - you are right, the 2.0.3.5 is much better then the 3.6. I made my own firmware with marlin, but unfortunately I could not find a way for getting the z probe wizard included. Its a bit hard to get informations about it and mks seems to Focusing on new products only.

Which printer do you own? I've tried their open source Marlin version with Two Trees Bluer and BL-Touch and babystepping worked as usual (but I'm having issues with skipping steps on Y axis after first layer, so I switched back to this 2.0.3.5).

Smarthelpers, 2022-01-09:
I developed my own printer, but use the MKS Robin Nano V1.2 Mainboard - all runs fine, but I am missing the Z-Offset-Wizard for changing the Z-Offset comfortable after automatic bed leveling. In the Elegoo Neptune 2 I have this wizard and this printer using a similar board with the same TFT35.

Thread 109 (2021-07-14):

Print paused in the mid print

selvakumaran2016, 2021-07-14:
Hi,

We are using Robin nano V2.0 + TS 35 with SD card extender.

Yesterday we found one issue.

After 2 hours of print, TS screen was frozen, no response from the screen. When we switched off the machine and switched it on, it didn't ask for a Resume. (The machine was installed at a customer location. He is having other brand machines with other boards, in which no issue came.

Thread 110 (2021-08-13):

Wiring Pinout v1.3

LucasvlLima, 2021-08-13:
Hello, When we can get the wiring pinout for Robin Nano v1.3?

willngton, 2021-08-13:
Any update on this request @mks-viva

NetoPanto17, 2021-08-13:
Any update for robin 1.3 @mks-viva

mont2236, 2021-08-13:
Also waiting for any update on this robin 1.3 pinout  @mks-viva

rafildes, 2021-08-13:
Hi, any update for "new" robin 1.3 @mks-viva

mks-viva, 2021-08-19:
MKS Robin Nano V1.3, MCU is STM32F407VET6, the pinout is same as MKS Robin Nano V1.2_004, only change mcu and firmware.

Closed 2021-08-19.

Thread 112 (2021-08-29):

How to update firmware *without* TFT screen attached?

glabifrons, 2021-08-29:
I'm not planning to use the display, but firmware will **_only_** flash if the TFT35 display is attached.

I found the recommendation to rename the firmware from Robin_nano35.bin to Robin_nano.bin in two other discussions: #64 & #82
Unfortunately, that is not working on my board.

I can repeatedly flash with success if both the TFT LCD is attached **_and_** the file is named Robin_nano35.bin.
However, if I disconnect the display, I cannot find a filename the firmware will accept for flashing (I've tried Robin_nano35.bin, Robin_nano.bin, and even Robin.bin).

Note that this board **_is_** available new without the display - so how do people update their firmware without the LCD?

katodo, 2021-10-07:
is there any news about this issue? I need to use this board with klipper and without tft, can be possible?

madurani, 2021-10-07:
I use board RobinNanoV2 without display, because equipment EXP-MOT3 with next three drivers/stepper was replaced with display.
Update of firmware is same as with display: only sd-casd with file Robin_nano35.bin insert to card-reader, start board and wait 30 second.

Only one issue on me side: I have to pull out cable from socket exp1 because motor z4 in socket m3 begin horrible sound/movement generate.

glabifrons, 2021-10-10:
> Thanks! I hope to try this solution next weekend!
>
> isn't available an open bootloader firmware? I need to use this board with klipper.

You flash Klipper to it by putting the image on a microSD card and powercycling the printer with the card in the Robin Nano.
The bootloader doesn't get replaced by the flashing, as it's in a part of the flash that doesn't get overwritten by this process.

Klipper is why I opened this issue (I can't use the stock LCD with Klipper, so I replaced it with a Pi LCD running KlipperScreen).

Germwalker, 2021-11-23:
I have the same problem, i can't flash anything without the TFT screen detached. This is so anoying, the board is integrated deeply inside the printer and i need to unscrew everything to update the klipper firmware.

Germwalker, 2021-11-23:
I'm tired with this crappy bootloader. I think i'll try to go to SWD with an STLINK to flash the klipper firmware.

Kung-Foo-Kamel, 2022-04-27:
I had no issues flashing my Nano-S V1.3 with Klipper?

Flash file must be called robin_nano35.bin and you will need to compile a newer firmware via klipper as this board runs an STM32F407 MCU and has 32kb boot flash vs 28kb on previous boards.

You must have no display connected, also make sure you have the USB cable disconnected, power up the printer and leave it for a few minutes, power down, remove the card, check the card in your PC, if it has been renamed "robin_nano32.CUR" then flash was successful.

NexGen-3D-Printing, 2022-05-01:
I would only do this if there was an issue with the stock bootloader, there may have been something corrupt with yours?

I have created an updated config for this board: https://github.com/NexGen-3D-Printing/klipper/blob/master/config/generic-mks-robin-nano-s-v1.3.cfg

Germwalker, 2022-05-02:
@NexGen-3D-Printing i was tired to deal with the robin nano stock bootloader as i needed to connect the screen every time i flash klipper and connect a SD card for this only purpose. I had no place in my setup to do so (and i don't have the screen anymore), that's why it's easier for me. The only important point is to compile the bootloader with the good memory offset as the bootloader have been erased.

NexGen-3D-Printing, 2022-05-03:
> @NexGen-3D-Printing i was tired to deal with the robin nano stock bootloader as i needed to connect the screen every time i flash klipper and connect a SD card for this only purpose. I had no place in my setup to do so (and i don't have the screen anymore), that's why it's easier for me. The only important point is to compile the bootloader with the good memory offset as the bootloader have been erased.

That's odd, I find my board wont flash "with" the display connected, I had to disconnect it for a successful flash to occur, I have also removed the display and I run an RPI with 4.3 touch screen instead.

Thread 113 (2021-08-30):

Freezing update!

pacocatech, 2021-08-30:
Hello,
I bought a Two Trees Bluer and it came with the MKS Nano S V1.3 board as shown in the image:

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

When trying to update the FW, the printer does not turn on anymore and always stays at the same point, as shown:

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

what can I do?

Bergateo, 2021-09-11:
same issue but haven't find the solution... do you find a way or have you bought a new one?

pacocatech, 2021-09-11:
nothing so far

mks-viva, 2021-09-13:
@pacocatech
You can try to this issues and i reply it: https://github.com/makerbase-mks/MKS-Robin-Nano-S-Firmware/issues/3

pacocatech, 2021-09-13:
still with the same problem

mks-viva, 2021-09-16:
May be reupload bootloader to board
https://github.com/makerbase-mks/MKS-Robin-Nano-V1.X/tree/master/Bootloader

Thread 114 (2021-09-04):

Robin TFT24/28/32/35/43 screen drivers

aSocialMenace, 2021-09-04:
So i am gonna convert my Neptune 2 to Klipper and it would be nice to use the factory TFT screen with Octoprint as Klipper currently does not support touch screens. I will need to wire up the factory screen (Robin TFT24/28/32/35/43 screen) directly to my pi and install the drivers to get it to work with a plugin like octoscreen. Soooo I am looking for drivers and a pinout of the screen its self. Do any such drivers exist or are there generic drivers that might work with for this? Any help would be greatly appreciated!!

willngton, 2021-09-30:
Hey @aSocialMenace  ,that is a very good idea, however,  drive will need to be written from scratch, for what I saw, all TFT are based on FSMC, I haven't seen any drive or dst for this kind of device, only SPI,

Been working on try to get TS35 working with PI, (so far got the TFT but not touch)

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

robbz23, 2024-03-25:
@willngton I know this is many years later, but I also have a Two Trees SP-3 that I am trying to get Klipper going on the screen.  Do you have any instructions on how to build the firmware to work with MKS Robin TFT35?

Thread 115 (2021-09-04):

Incorrect functionality of UART mode

madurani, 2021-09-04:
I tried to configure on RobinNanoV1.2 UART mode(on axis y) with drivers tmc2208, tmc2209, according "how to" on link https://www.youtube.com/watch?v=7ShcFKXrVHo.
Everything worked on first time, but motor after finishing given motion (even though it works properly) shivers and hisses loudly(sound is very similar to sound of television that cant detect signal), however when I switch back to step/dir mode motion of motor is correct(same motor&driver).

Look like that issue is related with kind of stepper motors, because when i use old motors https://www.aliexpress.com/item/32811604070.html?spm=a2g0s.9042311.0.0.27424c4d79bGIL, then problem with hissing sounds occurs, though when I use motor https://www.aliexpress.com/item/32811604070.html?spm=a2g0s.9042311.0.0.27424c4d79bGIL it works correctly(without mentioned sound).
Is it possible to modify marlin configuration for old kind of motors?

What was done for UART configuration:
1 three jumpers under driver were removed
2 cable was soldered on pins of driver(uart and R8) and connected to pin of board (PA9)
3 marlin configuration:
Configuration.h >> #define X_DRIVER_TYPE TMC2208 or #define X_DRIVER_TYPE TMC220 //according installed driver
Configuration_adv.h: #define X_CURRENT 636 // max current of motor is 0.9A
Configuration_adv.h: #define X_MICROSTEPS 16
Configuration_adv.h: #define HYBRID_THRESHOLD
Configuration_adv.h: #define X_HYBRID_THRESHOLD 100
pins_MKS_ROBIN_NANO.h #define Y_SERIAL_TX_PIN                   PA9
 pins_MKS_ROBIN_NANO.h #define Y_SERIAL_RX_PIN                  PA9

Driver tmc2208 and tmc2209 behaves the same way

Here is debug outputs from M122:
```
Connecting...
Printer is now online.
>>> m122
SENDING:M122
		Y	E1
Address		0
Enabled		false	false
Set current	636	636
RMS current	611	611
MAX current	862	862
Run current	19/31	19/31
Hold current	9/31	9/31
CS actual	9/31	9/31
PWM scale
vsense		1=.18	1=.18
stealthChop	false	false
msteps		16	16
interp		true	true
tstep		max	max
PWM thresh.	79	277
[mm/s]		100	30
OT prewarn	false	false
pwm scale sum	11	11
pwm scale auto	0	0
pwm offset auto	36	36
pwm grad auto	14	14
off time	3	3
blank time	24	24
hysteresis
 -end		-1	-1
 -start		1	1
Stallguard thrs	0
uStep count	8	8
DRVSTATUS	Y	E1
sg_result	0
stst
olb		*	*
ola		*	*
s2gb
s2ga
otpw
ot
157C
150C
143C
120C
s2vsa
s2vsb
Driver registers:
		Y	0x80:09:00:C0
		E1	0x80:09:00:C0
Testing Y connection... OK
Testing E1 connection... OK
```

madurani, 2021-09-04:
After adding all 5 drivers to UART mode + dual z + sensor less on xy axis, all work as expected, without mentioned sound(reason of issue wasn't find)

```
  >>> m122
SENDING:M122
                X       Y       Z       Z2      E
Address         0       0                       0
Enabled         false   false   false   false   false
Set current     800     800     636     800     800
RMS current     795     795     611     795     795
MAX current     1121    1121    862     1121    1121
Run current     25/31   25/31   19/31   25/31   25/31
Hold current    12/31   12/31   9/31    12/31   12/31
CS actual       12/31   12/31   9/31    12/31   12/31
PWM scale
vsense          1=.18   1=.18   1=.18   1=.18   1=.18
stealthChop     true    true    true    true    true
msteps          16      16      16      16      16
interp          true    true    true    true    true
tstep           max     max     max     max     max
PWM thresh.     79      79      658     658     277
[mm/s]          100     100     3       3       30
OT prewarn      false   false   false   false   false
pwm scale sum   26      61      54      31      14
pwm scale auto  0       3       4       1       0
pwm offset auto 64      144     163     76      36
pwm grad auto   17      61      14      14      14
off time        3       3       3       3       3
blank time      24      24      24      24      24
hysteresis
 -end           -1      -1      -1      -1      -1
 -start         1       1       1       1       1
Stallguard thrs 150     150                     0
uStep count     216     24      264     264     8
DRVSTATUS       X       Y       Z       Z2      E
sg_result       78      48                      0
stst
olb
ola
s2gb
s2ga
otpw
ot
157C
150C
143C
120C
s2vsa
s2vsb
Driver registers:
                X       0xC0:0C:00:00
                Y       0xC0:0C:00:00
                Z       0xC0:09:00:00
                Z2      0xC0:0C:00:00
                E       0xC0:0C:00:00
Testing X connection... OK
Testing Y connection... OK
Testing Z connection... OK
Testing Z2 connection... OK
Testing E connection... OK

```

mks-viva, 2021-09-06:
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
This is OK.

madurani, 2021-09-07:
Which sort of memory(flash, eeprom, sdcard) use RobinNanoV1.2 for store of parameters from command M500,  when is set up in marlin?

```
/
// EEPROM
//
#if EITHER(NO_EEPROM_SELECTED, FLASH_EEPROM_EMULATION)
  #define FLASH_EEPROM_EMULATION
  #define EEPROM_PAGE_SIZE     (0x800U) // 2KB
  #define EEPROM_START_ADDRESS (0x8000000UL + (STM32_FLASH_SIZE) * 1024UL - (EEPROM_PAGE_SIZE) * 2UL)
  #define MARLIN_
```
 **Flash memory?**

mks-viva, 2021-09-08:
Use Flash

Closed 2021-09-24.

Thread 116 (2021-09-11):

Robin nano S 1.3 "font table booting 100%" stuck

Bergateo, 2021-09-11:
Hi everyone! after I've receaved my 3d printer (flyingbear ghost 5) i've tried to upload your marlin firmware but now the board is stuck on that error (font table booting 100%) and doesn't respond or recover after hours of wait...
Here there the list of the things I've already tried out:
- to plug off and reinstall the same fw,
- to install the old one that was working,
- try another version dowload from an italian repository (but i think it was the same as yours)
- tried out other different fw
- format the ft card to fat32 and try again
- tried out different sd cards
But nothing works, the screen stays on the same error.

i think it's a problem in eleborating/reading files in the ft card...
i would like to try out an arduino or an AVR to force the fw into it or, maybe more simply, to reset to factory data but since i'm not able to do it, i would like to know if is possible and if it is, to kindly have a guide to do it?

mks-viva, 2021-09-13:
I need close this issues, because has :https://github.com/makerbase-mks/MKS-Robin-Nano-S-Firmware/issues/3

Closed 2021-09-13.

Thread 117 (2021-10-04):

STM32F103 / STM32F407 boards should use on-chip USB support

ag88, 2021-10-04:
hi MKS,
Your boards are quite good, but STM32F103 / STM32F407 boards should use on-chip USB support instead of using a separate USB-UART

There is a problem, as seen in this PR for Marlin
https://github.com/MarlinFirmware/Marlin/pull/22529
Because STM32F103 and STM32F407 UART only has a single byte buffer. When the microcontroller is busy it can skip bytes from the host. So it becomes necessary to increase interrupt priority for the UART, this comes at a cost to interrupts to other peripherals such as HardwareTimer.

Both STM32F103 and STM32F407 has on-chip USB support, please revise your designs to use the on-chip USB rather than using a separate USB-UART bridge.

e.g. your MKS-Nano-V3 is correctly designed
https://github.com/makerbase-mks/MKS-Robin-Nano-V3.X
https://github.com/makerbase-mks/MKS-Robin-Nano-V3.X/blob/main/hardware/MKS%20Robin%20Nano%20V3.0_004/MKS%20Robin%20Nano%20V3.0_004%20SCH.pdf
pins PA11 USB D- and PA12 USB D+ goes direct to USB.
But please update your designs so that the Nano-V1 and Robin E3 etc
https://github.com/makerbase-mks/MKS-Robin-E3-E3D
https://github.com/makerbase-mks/MKS-Robin-E3-E3D/blob/master/hardware/MKS%20Robin%20E3%20V1.1_004/MKS%20Robin%20E3%20V1.1_004%20SCH.pdf
use pins PA11 USB D- and PA12 USB D+ goes direct to USB.

Thread 118 (2021-10-04):

STM32F103 / STM32F407 boards BOOT0 pin should have *jumper* (or button) to VDD 3v3

ag88, 2021-10-04:
STM32F103 / STM32F407 boards BOOT0 pin should have *jumper* (or button) to VDD 3v3, and the pin should be resistor to GND.

Your boards are quite good, but for many of your boards
e.g. Robin Nano V3
https://github.com/makerbase-mks/MKS-Robin-Nano-V3.X/blob/main/hardware/MKS%20Robin%20Nano%20V3.0_004/MKS%20Robin%20Nano%20V3.0_004%20SCH.pdf
Robin Nano V1.x
https://github.com/makerbase-mks/MKS-Robin-Nano-V1.X
Robin E3D
https://github.com/makerbase-mks/MKS-Robin-E3-E3D/blob/master/hardware/MKS%20Robin%20E3%20V1.1_004/MKS%20Robin%20E3%20V1.1_004%20SCH.pdf
https://github.com/makerbase-mks/MKS-Robin-Nano-V1.X/blob/master/hardware/MKS%20Robin%20Nano%20V1.3_002/MKS%20Robin%20Nano%20V1.3_002%20SCH.pdf

BOOT0 is tie to GND, this is not good. BOOT0 allows the use of UART to upload firmware on PA9 TX, PA10 RX for STM32F103. And for STM32F407 BOOT0 allows direct USB DFU firmware upload (no need extra boot loader or st-link). The procedure is set BOOT0, press reset, upload firmware.

So for STM32F103 (for STM32F407 as well) uart1 pins PA9, PA10 should be made available on headers. I think this is already ok.

mks-viva, 2021-10-07:
https://github.com/makerbase-mks/MKS-Robin-Nano-V3.X/issues/63

Thread 119 (2021-10-04):

STM32F103 / STM32F407 boards, enhancement request 32khz RTC crystal and VBAT

ag88, 2021-10-04:
STM32F103 / STM32F407 boards, enhancement request 32khz RTC crystal and VBAT

STM32F103 and STM32F407 has built-in RTC (Real time clock), what is needed is a 32Khz watch crystal.
Some design needed there. Check ST documents.

In addition, VBAT pin need to power from 3v coin cell (e.g. cr2032) to keep the RTC running.
I think VBAT can leave open, not connected and goto a header pin if you don't want to put battery on board.
Those who want to use VBAT pin can connect their own cr2032 battery, or you can sell as separate add on module.

Why is this important? Because with VBAT, it is possible to use backup registers or backup SRAM. These are there inside the STM32F103 and STM32F407 chip. e.g. they can be used to store some importantant printer settings and still keep memory after switch off.

The RTC is also important, it keeps time. So for example, can do time based automation, e.g. set alarm clock and goto sleep. wake up in the morning and start heated bed and start printing. But those things need the RTC.
RTC also useful for monitoring print time and a lot of other things.

Thread 120 (2021-10-19):

nano-s uart not working for tmc2209

pznamenskii, 2021-10-19:
hi.
I am trying to install tmc2209 into E1 socket on nano-s board and connect via uart (4th pin on tmc2209 (PDN) as TX to PC14 via 1k resistor and as RX directly to PC15:
```
Marlin/src/pins/stm32f4/pins_MKS_ROBIN_NANO_V1_3_F4.h:
#define E0_SERIAL_TX_PIN                  PC14
#define E0_SERIAL_RX_PIN                  PC15
#define TMC_BAUD_RATE 19200

Marlin/Configuration_adv.h:
#define E0_SLAVE_ADDRESS 0
#define E0_CURRENT      550
#define E0_MICROSTEPS    32
#define STEALTHCHOP_E
#define MONITOR_DRIVER_STATUS
#define TMC_DEBUG

Marlin/Configuration.h:
#define MOTHERBOARD BOARD_MKS_ROBIN_NANO_V1_3_F4
#define E0_DRIVER_TYPE TMC2209
```
driver is no seen with the below M122 S0 response:
```
09:52:10.380 : Driver registers:
09:52:10.380 : E	0x00:00:00:00	 Bad response!
09:52:10.381 : Testing E connection... Error: All LOW
```

mks-viva, 2021-11-23:
You only need to use an IO to connect to the PDN_UART pin of TMC2209, you can refer to：https://www.youtube.com/watch?v=7ShcFKXrVHo

pznamenskii, 2021-11-23:
> You only need to use an IO to connect to the PDN_UART pin of TMC2209, you can refer to：https://www.youtube.com/watch?v=7ShcFKXrVHo

doing so will likely damage your board: nano-s board has MS3 hardwired with a 0Ohm resistor and until your remove it, UART pin on driver will get voltage as in a non-UART configuration. there is no way to connect UART without soldering out that resistor which is an extremely inconvenient board design.

mks-viva, 2021-11-23:
TMC2209 compatible with 3.3V and 5V

pznamenskii, 2021-11-23:
> TMC2209 compatible with 3.3V and 5V

it is, but UART will not work until you remove this resistor
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
by not removing it, you load 3.3 or 5V to the pin on the board you chose to use as UART line, i.e. PC14 - this may damage the board

mks-viva, 2021-11-23:
You need remove it, because it is use to microstep settings for plug driver.

Thread 122 (2021-12-02):

GD32F303VET6 instead of STM32F103VET6

yeochoony, 2021-12-02:
Hello.

I recently bought a KP3S, and inside there is a MKS KP3 V1.2 board in it.

I heard that MKS KP3 V1.2 board is compatiable with MKS Robin Nano V1 board.

The problem is, that my board, in case, has a GD32F303VET6 instead of STM32F103VET6 for the MCU.

I am trying to use klipper, but I cannot find any informations about the parameters for  GD32F303VET6 MCU.

I tried to do the same configuration for MKS Robin Nano V1.2, but it didn't worked.

Any ideas?

Thanks.

Thread 123 (2021-12-16):

How can I change ENABLE for external drivers?

protektwar, 2021-12-16:
Hello,
I have a MKS v1.2 board with pin option for external driver (ENABLE, STEP, DIRECTION and GND), but something is wrong.
In order to debug my problem, I have connected 3 LED to ENABLE, STEP and DIRECTION.
DIRECTION is fine only on and off, and it cam be changed from the interface...

I have 2 problems:
1. ENABLE for the moment is set to LOW when the motor is in action,
    then my LED is OFF and on HIGH when off, and my LED is ON.
    How CAN I reverse that?
2. My LED connection to STEP  blinking only when the motor is rotation in one direction,
    when rotating on the other direction is not blinking at all...

BR,
Alex

protektwar, 2021-12-18:
1.  I found how to change the ENABLE settings
2. the only problem now is STEP, my DRIVER SS570 is not able to read somehow
    the STEP signal from the board, I have bought also a MKS CD v1.0
    which will amplify a little the signal, but with no results. My SS570 driver is working.
I must specify that this DRIVER SS570 I can control it without any problems with my CNC board.

Thread 124 (2022-01-29):

Robin Nano V1.2 dont get current

hitough, 2022-01-29:
Hello everyone. I am having an issue with the card. At the end of the print, the power went out and didn't start again. Then I checked the power supply output and it was ok. When I check the card I noticed the led which is on the corner next to the power input blinking red light. What does it mean? I checked the manual and the web didn't find anything. Any ideas are appreciated. Thanks.

Thread 128 (2022-03-27):

SD not recognize in Marlin 2.0.9.3 with MKS Robin Nano V.1.1

AlviseRecon, 2022-03-27:
Marlin 2.0.9.3 in my MKS Robin Nano v1.1 (STM32F103) dosent recognize the MicroSD, this issue resolt in blackscreen when turning on the printer and when sending a job from Cura Slicer.
This issue is already been posted in the Marlin GitHub, https://github.com/MarlinFirmware/Marlin/issues/22898.

With Marlin 2.0.7.2 this issue dosent occur.

Thanks for the help.

Thread 129 (2022-05-06):

Extend MKS Robin Nano 1.2 with other ATMEGA/STM32 boards

vasilybodnarchuk, 2022-05-06:
Hello!
I have a printer and of course,  OF COURSE, I want to add more functionality.
What Is my idea:
1. Extend printer functionality with other ATMEGA/STM32 board
2. Add new menu items in the Marlin 2.0 firmware (yes, I will have to branch it and customize it)
3. Each menu will send a simple command to another microcontroller (maybe it will be just numbers 0-255)

So, I just need any digital pin and ground from Robin Nano, right? If yes, what pins I should use?

Thread 130 (2022-06-21):

Using aux pins as a thermistor analog pin?

SuhzHome, 2022-06-21:
I accidentally burned the bed and hotend thermistor pins on my Mks Gen L card, I only have 1 hotend analog pin left, I wonder if I can use the aux inputs as analog and read the bed temperature? How can I do this in Marlin?

Thread 132 (2022-10-12):

Are TX1 and RX1 Usable ?

jpmimard, 2022-10-12:
I want to connect SKR-PI with UART connection intead of USB one, so I will have no external cable.
But there is no UART connector on the board, only holes TX1 and RX1
Are they usable ?
My motor drivers use UART mode, is it compatible ?

Thread 136 (2023-05-20):

Marlin COLOR_UI and MKS-WiFi Module

danibor09, 2023-05-20:
Hi, I want to use Marlin COLOR_UI as graphical interface, but that doesn't allow to directly use the MKS-WiFi module. I know that the module and the motherboard can talk through Serial, but I'm not able to get the MKS-WiFi work. Is there any Serial setting I could change to fix this problem?
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

Thread 137 (2023-08-28):

Can I use PB2 as another cooling fan?

Sagigamil, 2023-08-28:
Hi,
I own a v1.2 board and I want to use the PB2 pin to control a laser module using PWM.
I was thinking of recompiling marlin with another fan using PB2, any idea if it will work or if there is something that I may missed and need to know?

thank you, Sagi

Thread 138 (2023-10-01):

Erratic temp Spikes

Serox13, 2023-10-01:
Hi all,
i have scoured the depths of Google for answers but i need the collective help of Klipper.
I'm using an MKS nano S v1.3 board, it flashed into Klipper no worries did all the usual calibrations except the temps of everything even the mcu would fluctuate to the point of shutting the mcu down. power down then on the next day it wouldn't connect to the MCU at all. Connected an old 4.2.2 board up it ran perfectly connected to the MCU, no temp fluctuations at all, ran a print all was good.
i got the MKS board working again connected it to the MCU and again temp fluctuations so i PID calibrate and it doesn't fix or stabilise the temps at all. I also turned off the PSU and left the USB cable to power the board and instantly the temps went to normal no erratic fluctuations. These happen with the stock firmware as well.
I have tested all grounds and earths, PSU puts out 24v, no shorts on the board. changed the thermistor even know its not the problem and still happens, i have also made a data-only USB cable and still it happens. Because it levels out after the PSU is turned off does that suggest its a grounding issue with the PSU or MKS board issue? Do i just accept that the board has lots its will to print and RMS it? any help would be great thanks.
If you need logs or what i can provide them when i get back to the main pc.

amsmith525, 2023-11-17:
I too have this issue. Powering from usb only and the readings are flat - turn on the psu and the readings go erratic.

amsmith525, 2024-02-16:
After increasing the value of capacitor C10 from 0.1uf to 10uf, the temp spikes are significantly reduced.
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

Thread 139 (2023-11-20):

STM32F407 bootloader flash error

BlackSoalt, 2023-11-20:
hello, This article was written through a translator. The sentence can be strange because I can't speak English.

I am using stm32f407. I updated the firmware with an SD card to use the klipper.
However, there was a problem with the connection and I tried to install the initial firmware to start all over again.

I tried to update it by making various firmware, but it didn't respond. The firmware made by someone else didn't respond either.

So I tried to reinstall the bootloader.
I purchased STlink and updated the hex file with a dedicated program.

However, the firmware update using the SD card is still not working. And we're only printing these screens on the LCD.

We've already used 14 days to solve this phenomenon. Has anyone experienced the same problem as me?
I need your help. Help me, please.

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

ByMalicious, 2023-11-23:
Did you solve the problem?

Thread 140 (2024-01-31):

What FFC (ribbon) cable do we need for the Robin Nano 1.1/1.2 board?

mlewis-everley, 2024-01-31:
Hi all,

I managed to damage the ribbon cable connecting the board to the screen. I have been trying to find a replacement, but cannot track down the exact version printed on the cable?

From what I can tell the cable is:

- AWM 20798
- 32pin
- 1mm pitch

Is this correct? If so, where can I purchase one?

I have tried an AWM 20624 with the same pins and pitch, but that doesn't seem to work (I guess they are incompatible).

Many thanks,

Mo

ColdBeer72, 2024-01-31:
I bought these and worked fine
https://a.aliexpress.com/_Eysn64l
