makerbase-mks/MKS-Robin-Nano-V1.X/hardware/MKS Robin Nano-S V1.3_001/MKS Robin Nano-S V1.3_001 SCH.pdf

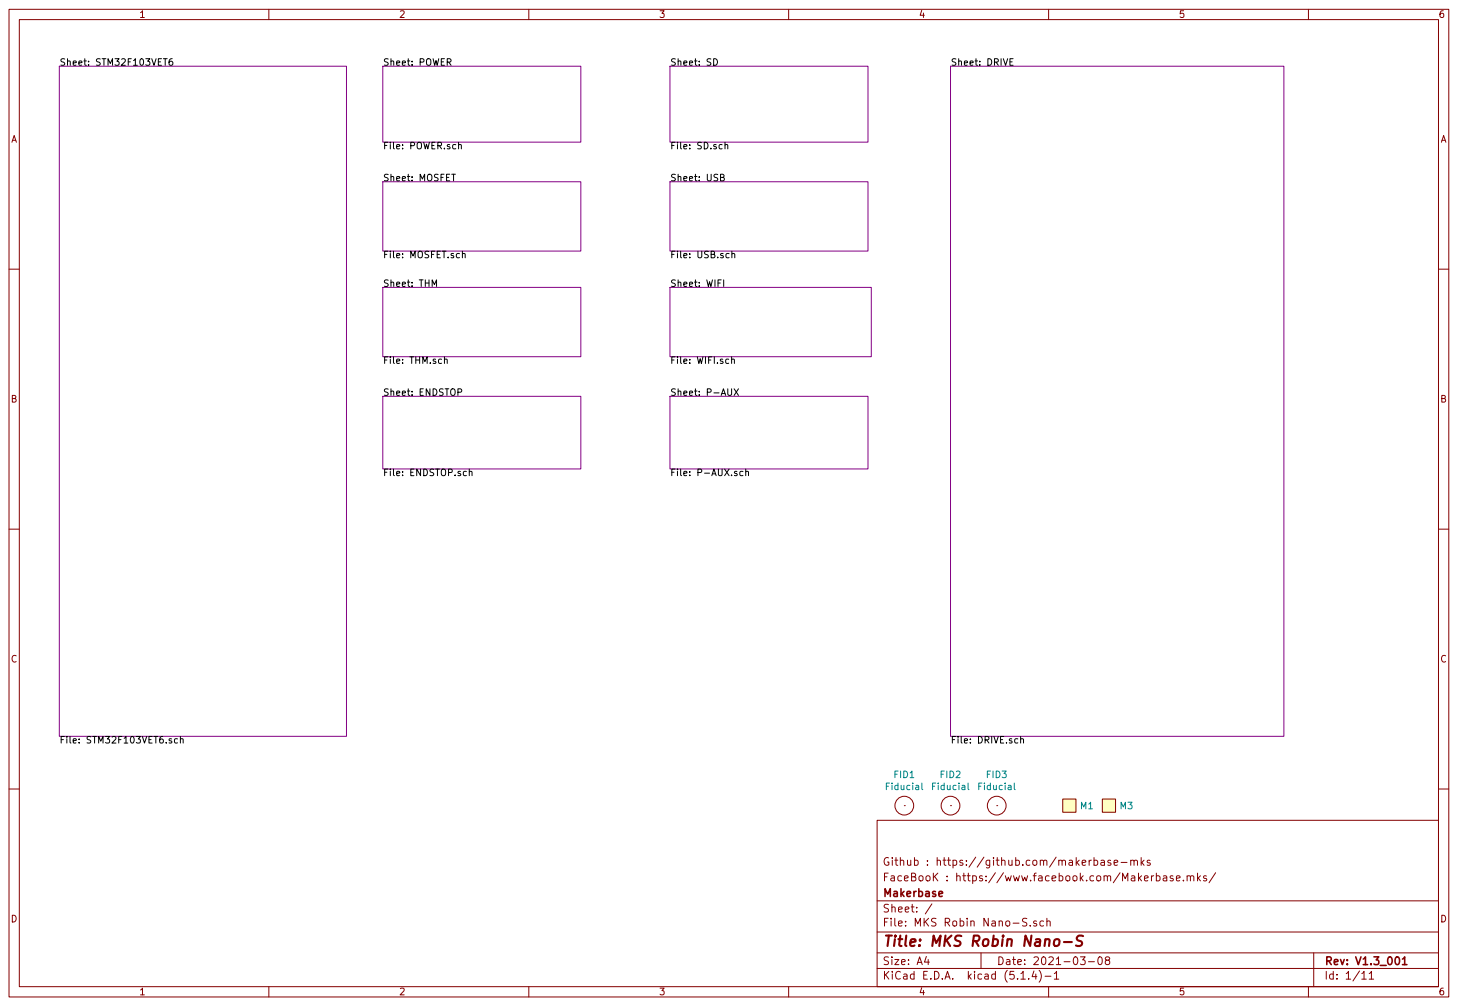
[picture p5: page 1]

File: POWER.sch Sheet: MOSFET

File: SD.sch Sheet: USB

File: MOSFET.sch Sheet: THM

File: USB.sch Sheet: WIFI File: WIFI.sch Sheet: P-AUX

File: THM.sch Sheet: ENDSTOP

Github : https://github.com/makerbase-mks
File: MKS Robin Nano-S.sch Sheet: / Makerbase FaceBooK : https://www.facebook.com/Makerbase.mks/

Id: 1/11 Title: MKS Robin Nano-S

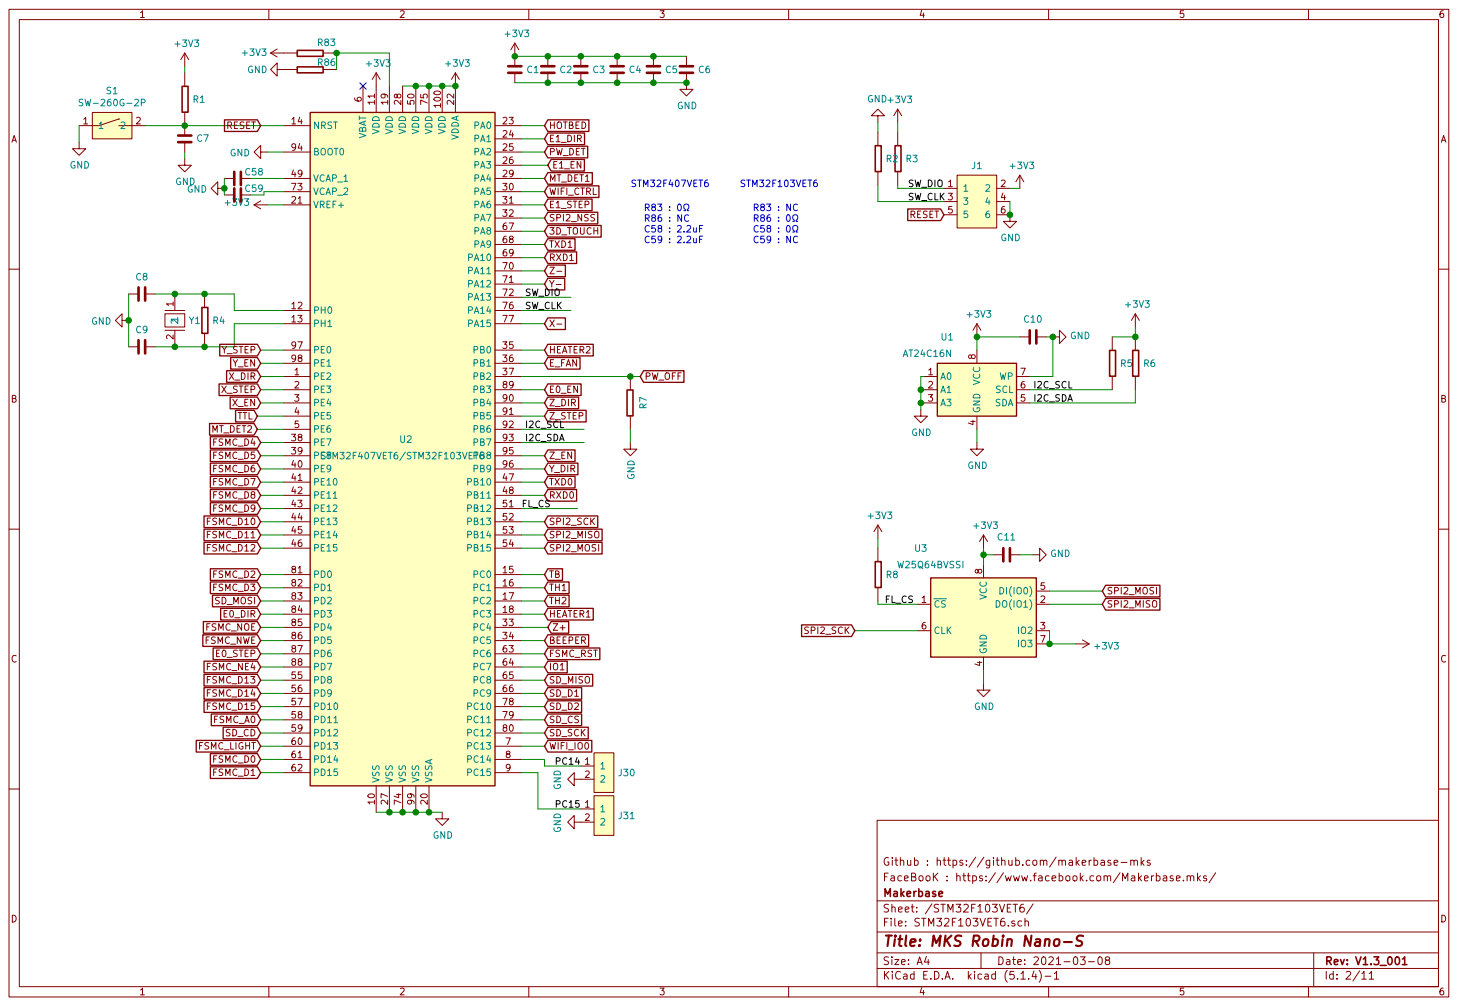
[picture p6: page 2]

Github : https://github.com/makerbase-mks
File: STM32F103VET6.sch Sheet: /STM32F103VET6/ Makerbase FaceBooK : https://www.facebook.com/Makerbase.mks/

Id: 2/11 Title: MKS Robin Nano-S

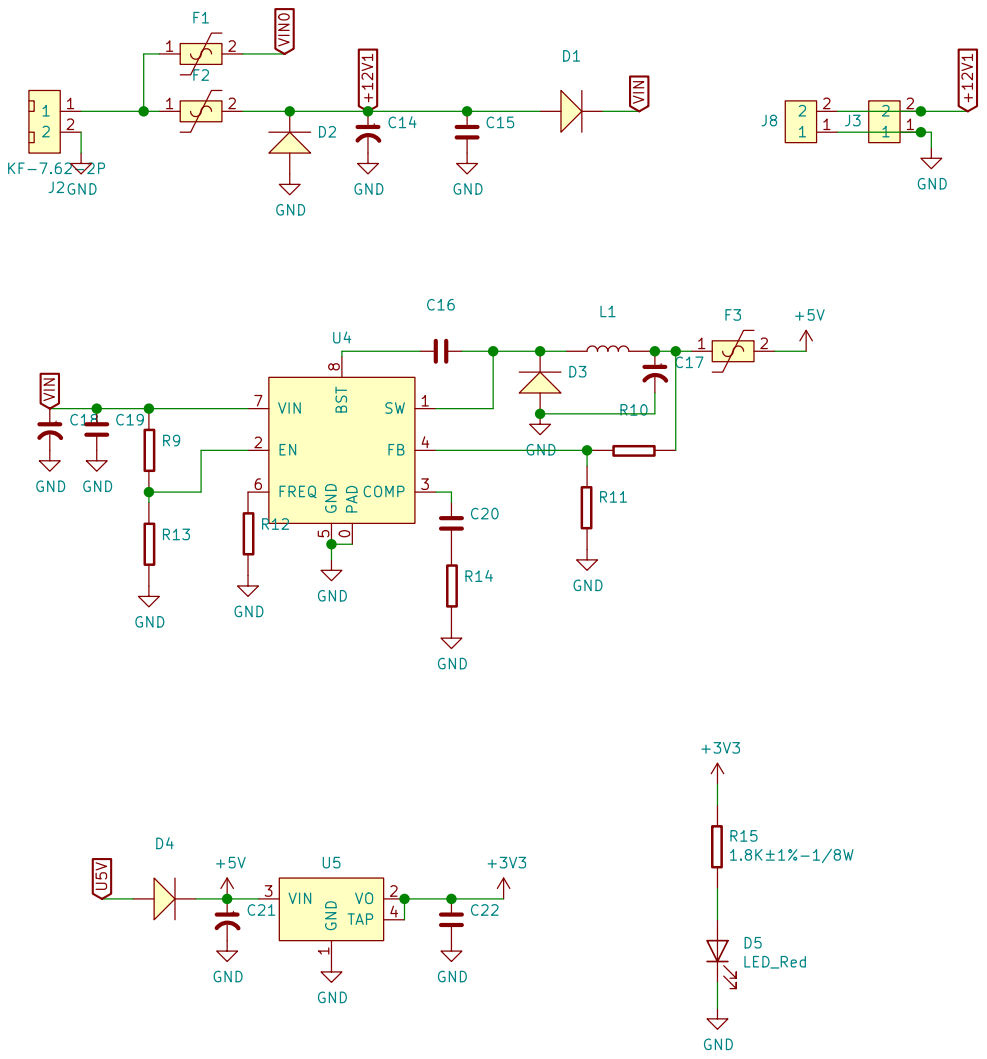
[picture p7: page 3]

1 VO 2 VIN 3 TAP 4 U5 R9 GND

0 SW 1 EN 2 COMP 3 FB 4 GND

R14 C20 GND GND GND GND GND

Github : https://github.com/makerbase-mks
File: POWER.sch Sheet: /POWER/ Makerbase FaceBooK : https://www.facebook.com/Makerbase.mks/

Id: 3/11 Title: MKS Robin Nano-S

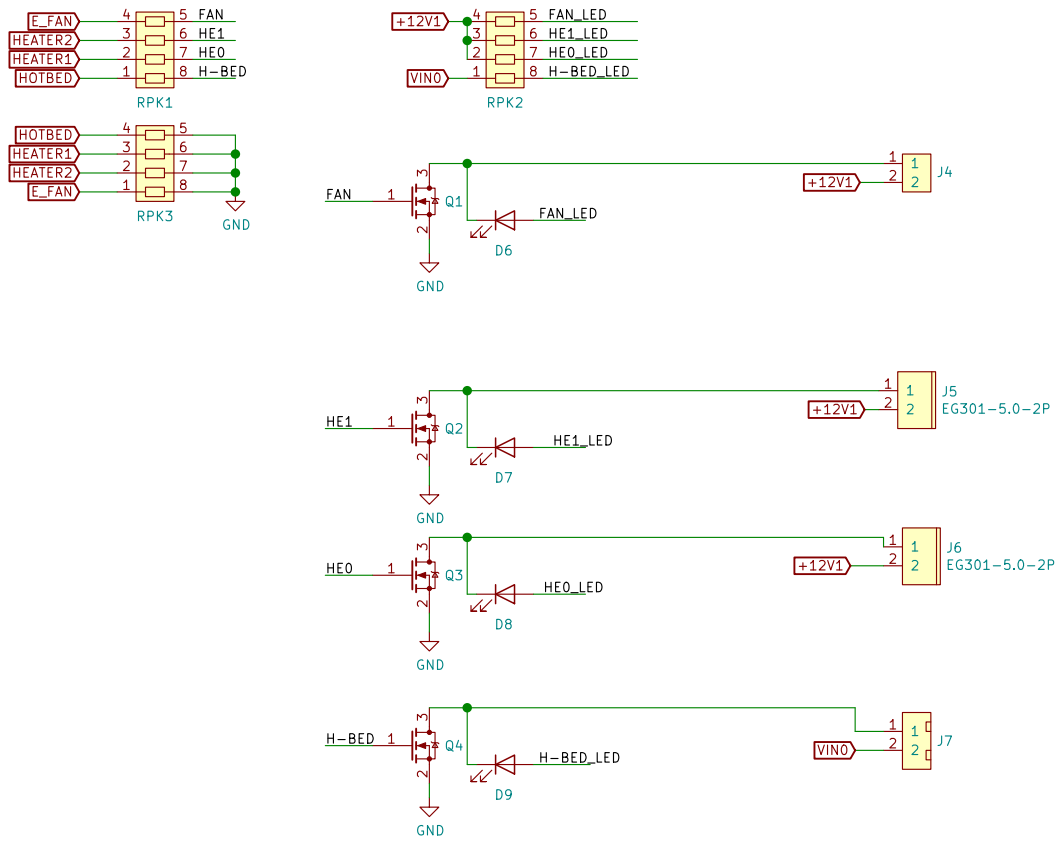
[picture p8: page 4]

Github : https://github.com/makerbase-mks
File: MOSFET.sch Sheet: /MOSFET/ Makerbase FaceBooK : https://www.facebook.com/Makerbase.mks/

Id: 4/11 Title: MKS Robin Nano-S

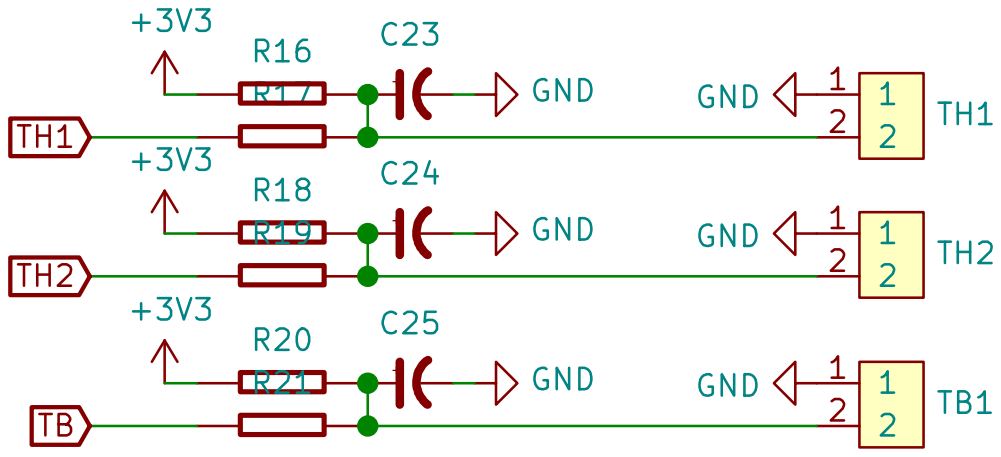
[picture p9: page 5]

Github : https://github.com/makerbase-mks
File: THM.sch Sheet: /THM/ Makerbase FaceBooK : https://www.facebook.com/Makerbase.mks/

Id: 5/11 Title: MKS Robin Nano-S

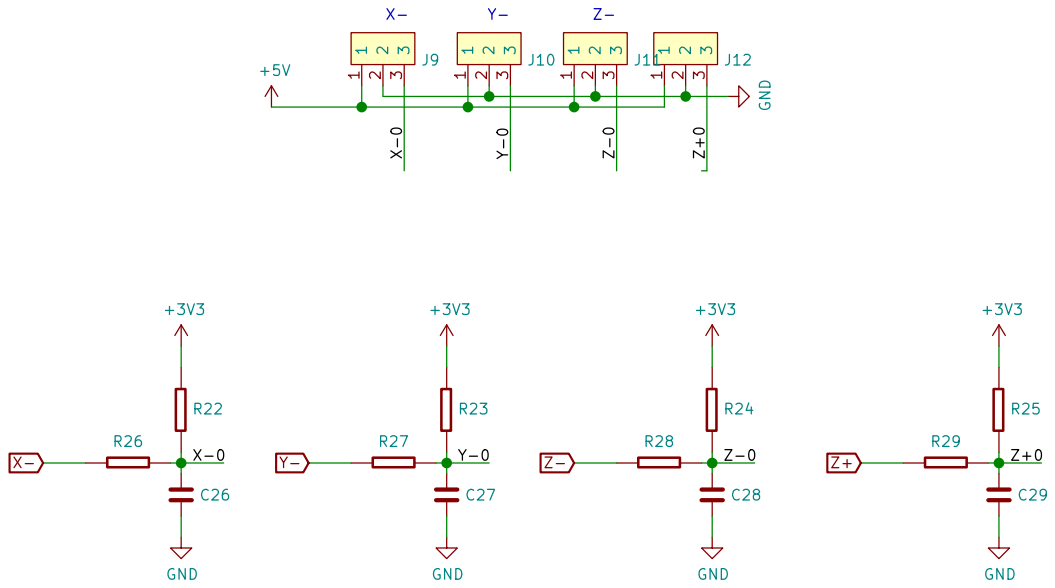
[picture p10: page 6]

Github : https://github.com/makerbase-mks
File: ENDSTOP.sch Sheet: /ENDSTOP/ Makerbase FaceBooK : https://www.facebook.com/Makerbase.mks/

Id: 6/11 Title: MKS Robin Nano-S

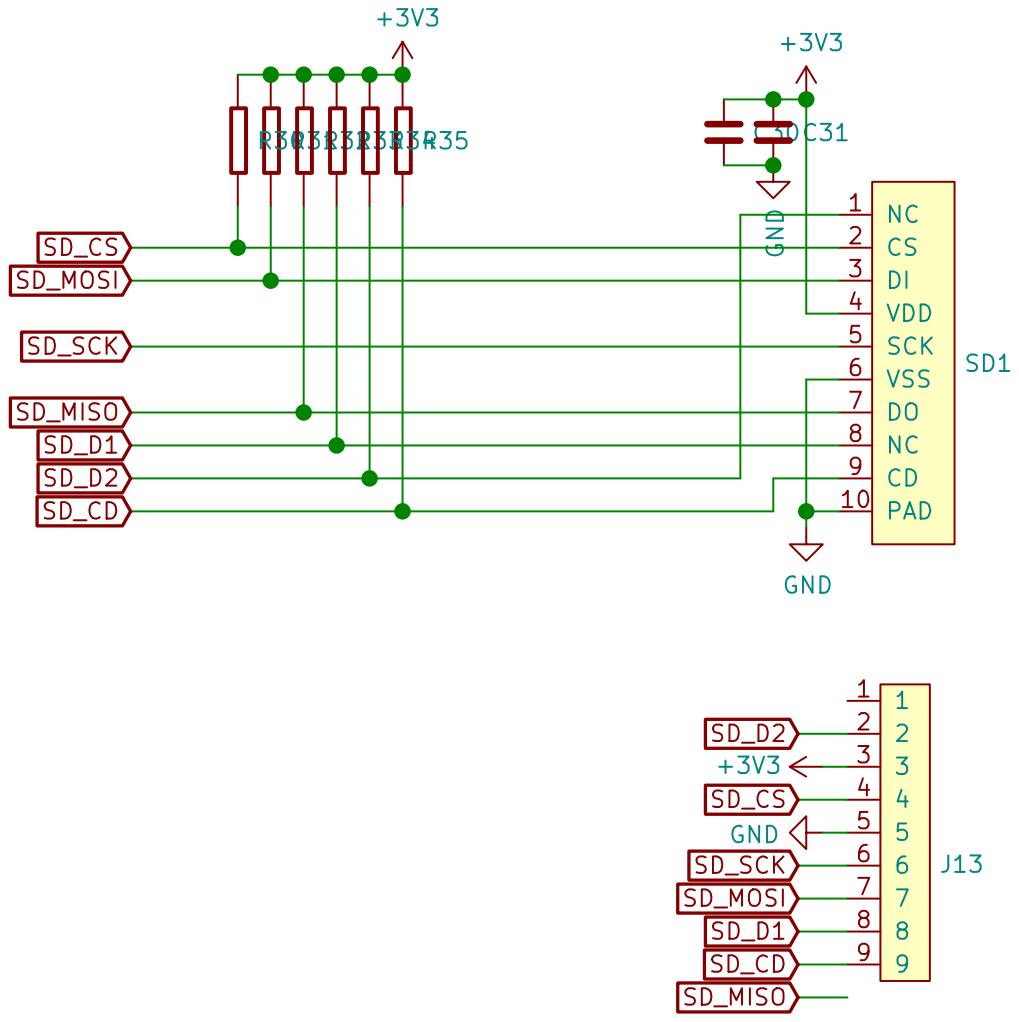
[picture p11: page 7]

Github : https://github.com/makerbase-mks GND

File: SD.sch Sheet: /SD/ Makerbase FaceBooK : https://www.facebook.com/Makerbase.mks/

Id: 7/11 Title: MKS Robin Nano-S

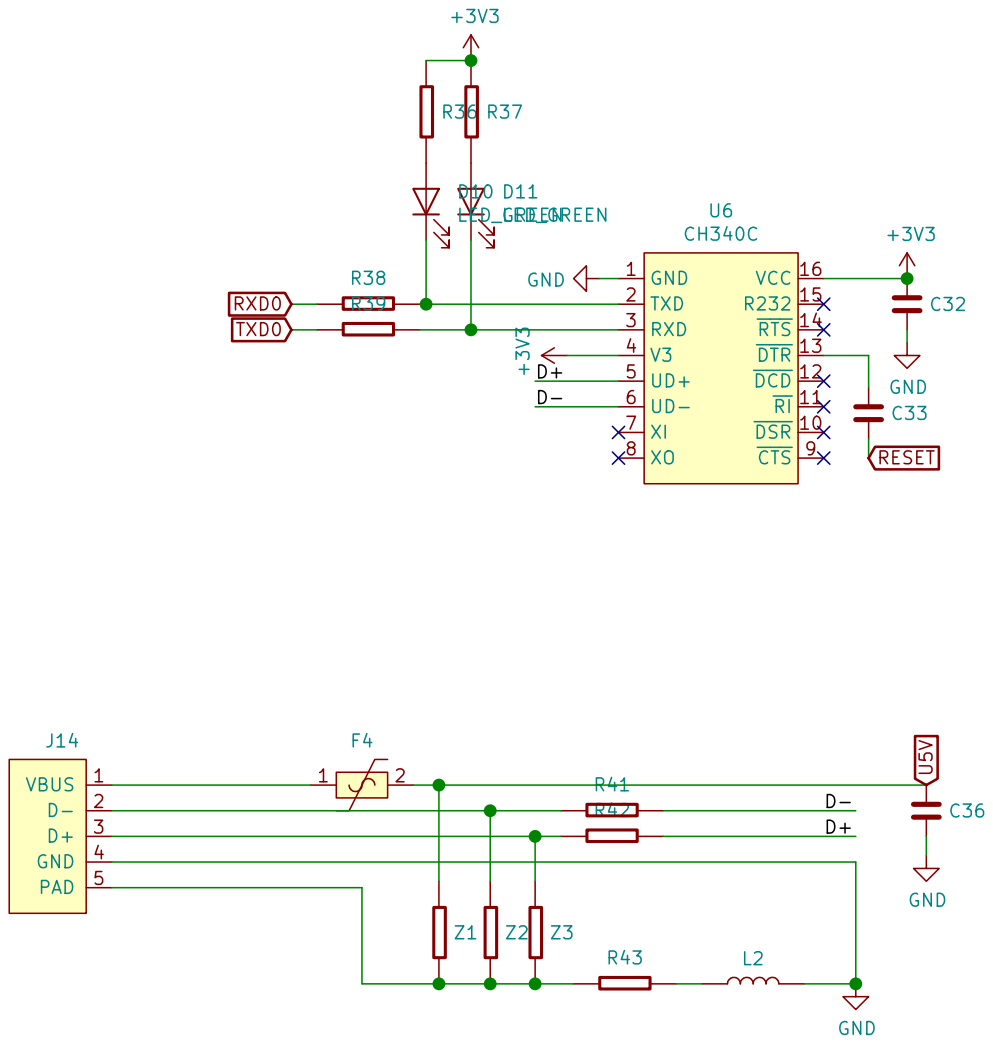
[picture p12: page 8]

Github : https://github.com/makerbase-mks
File: USB.sch Sheet: /USB/ Makerbase FaceBooK : https://www.facebook.com/Makerbase.mks/

Id: 8/11 Title: MKS Robin Nano-S

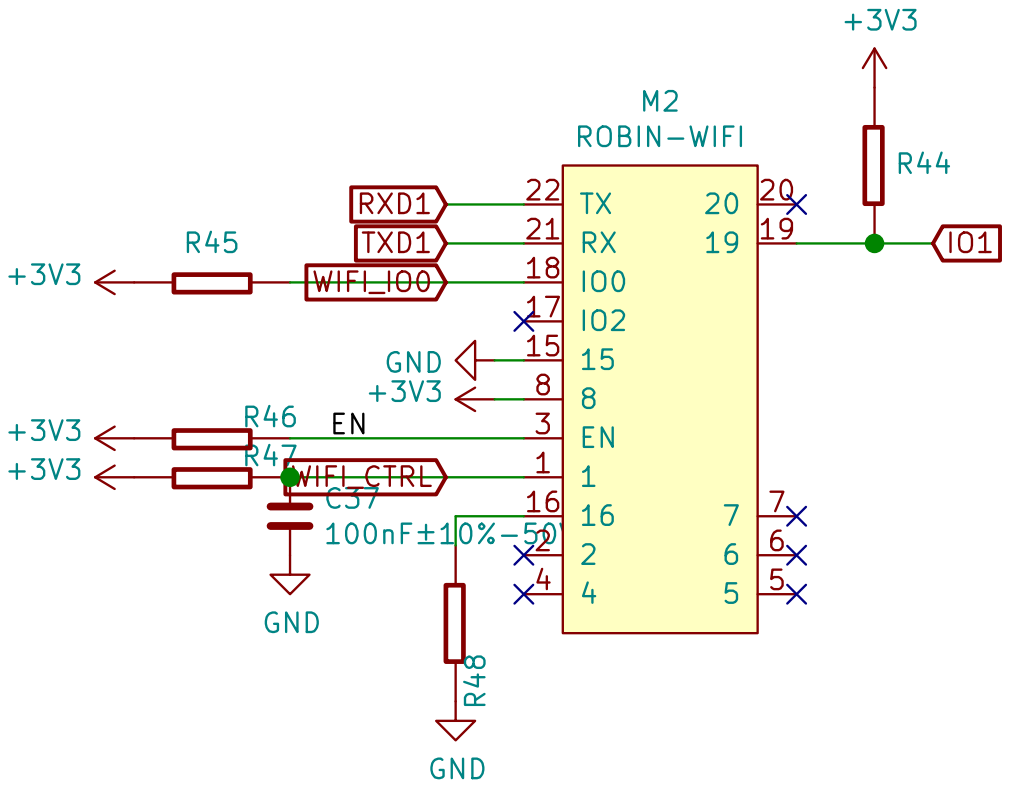
[picture p13: page 9]

Github : https://github.com/makerbase-mks
File: WIFI.sch Sheet: /WIFI/ Makerbase FaceBooK : https://www.facebook.com/Makerbase.mks/

Id: 9/11 Title: MKS Robin Nano-S

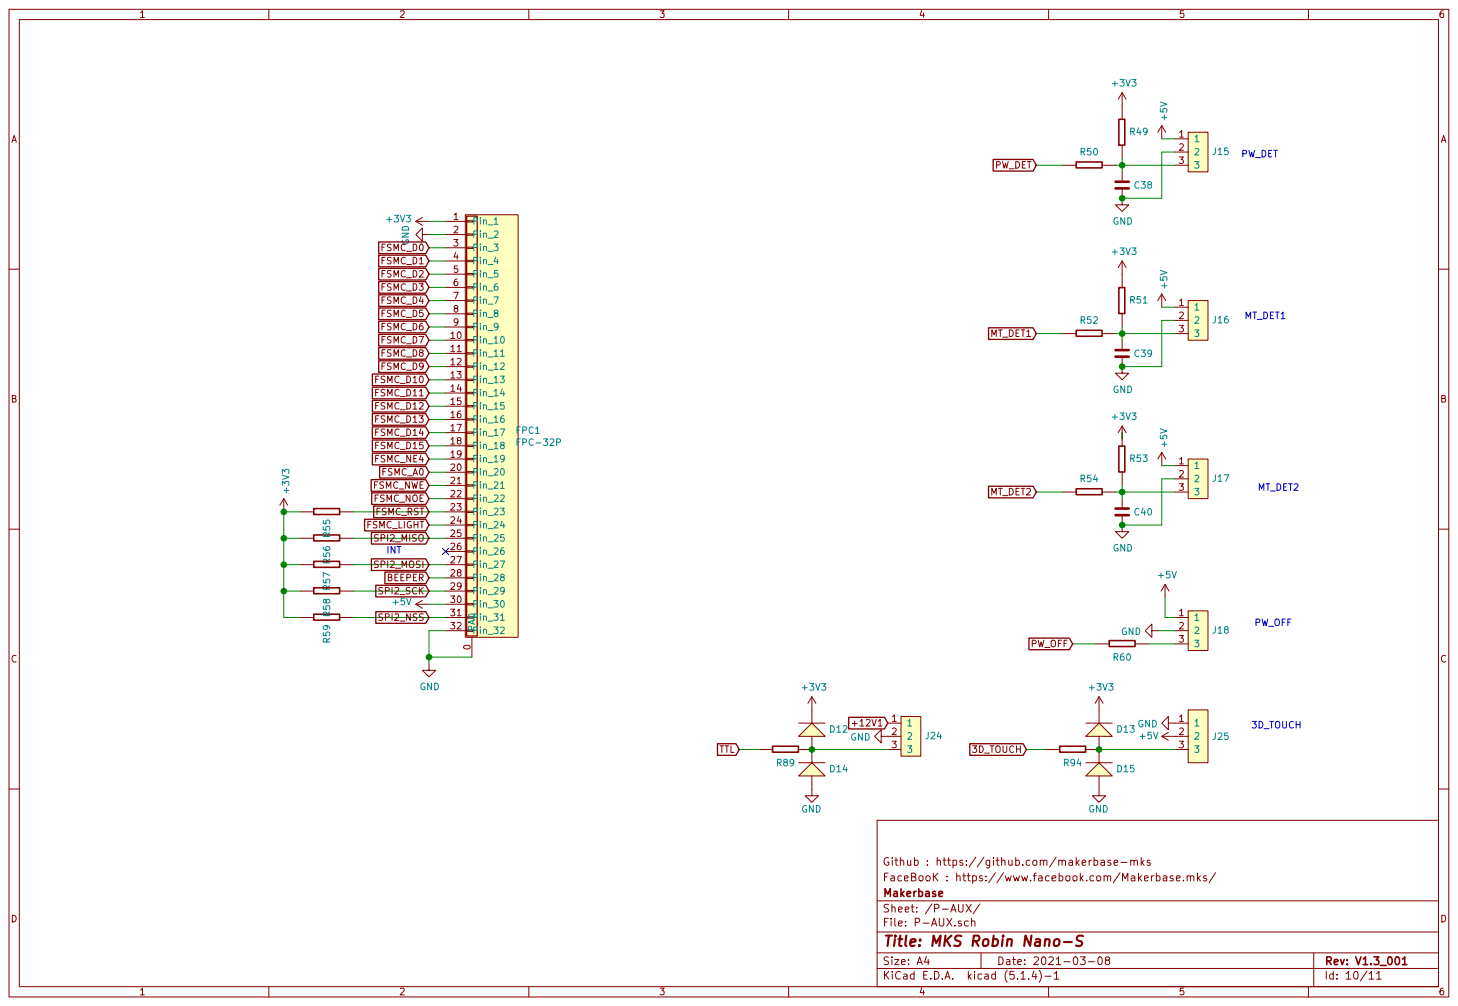
[picture p14: page 10]

File: P-AUX.sch Sheet: /P-AUX/ Makerbase FaceBooK : https://www.facebook.com/Makerbase.mks/

Id: 10/11 Title: MKS Robin Nano-S

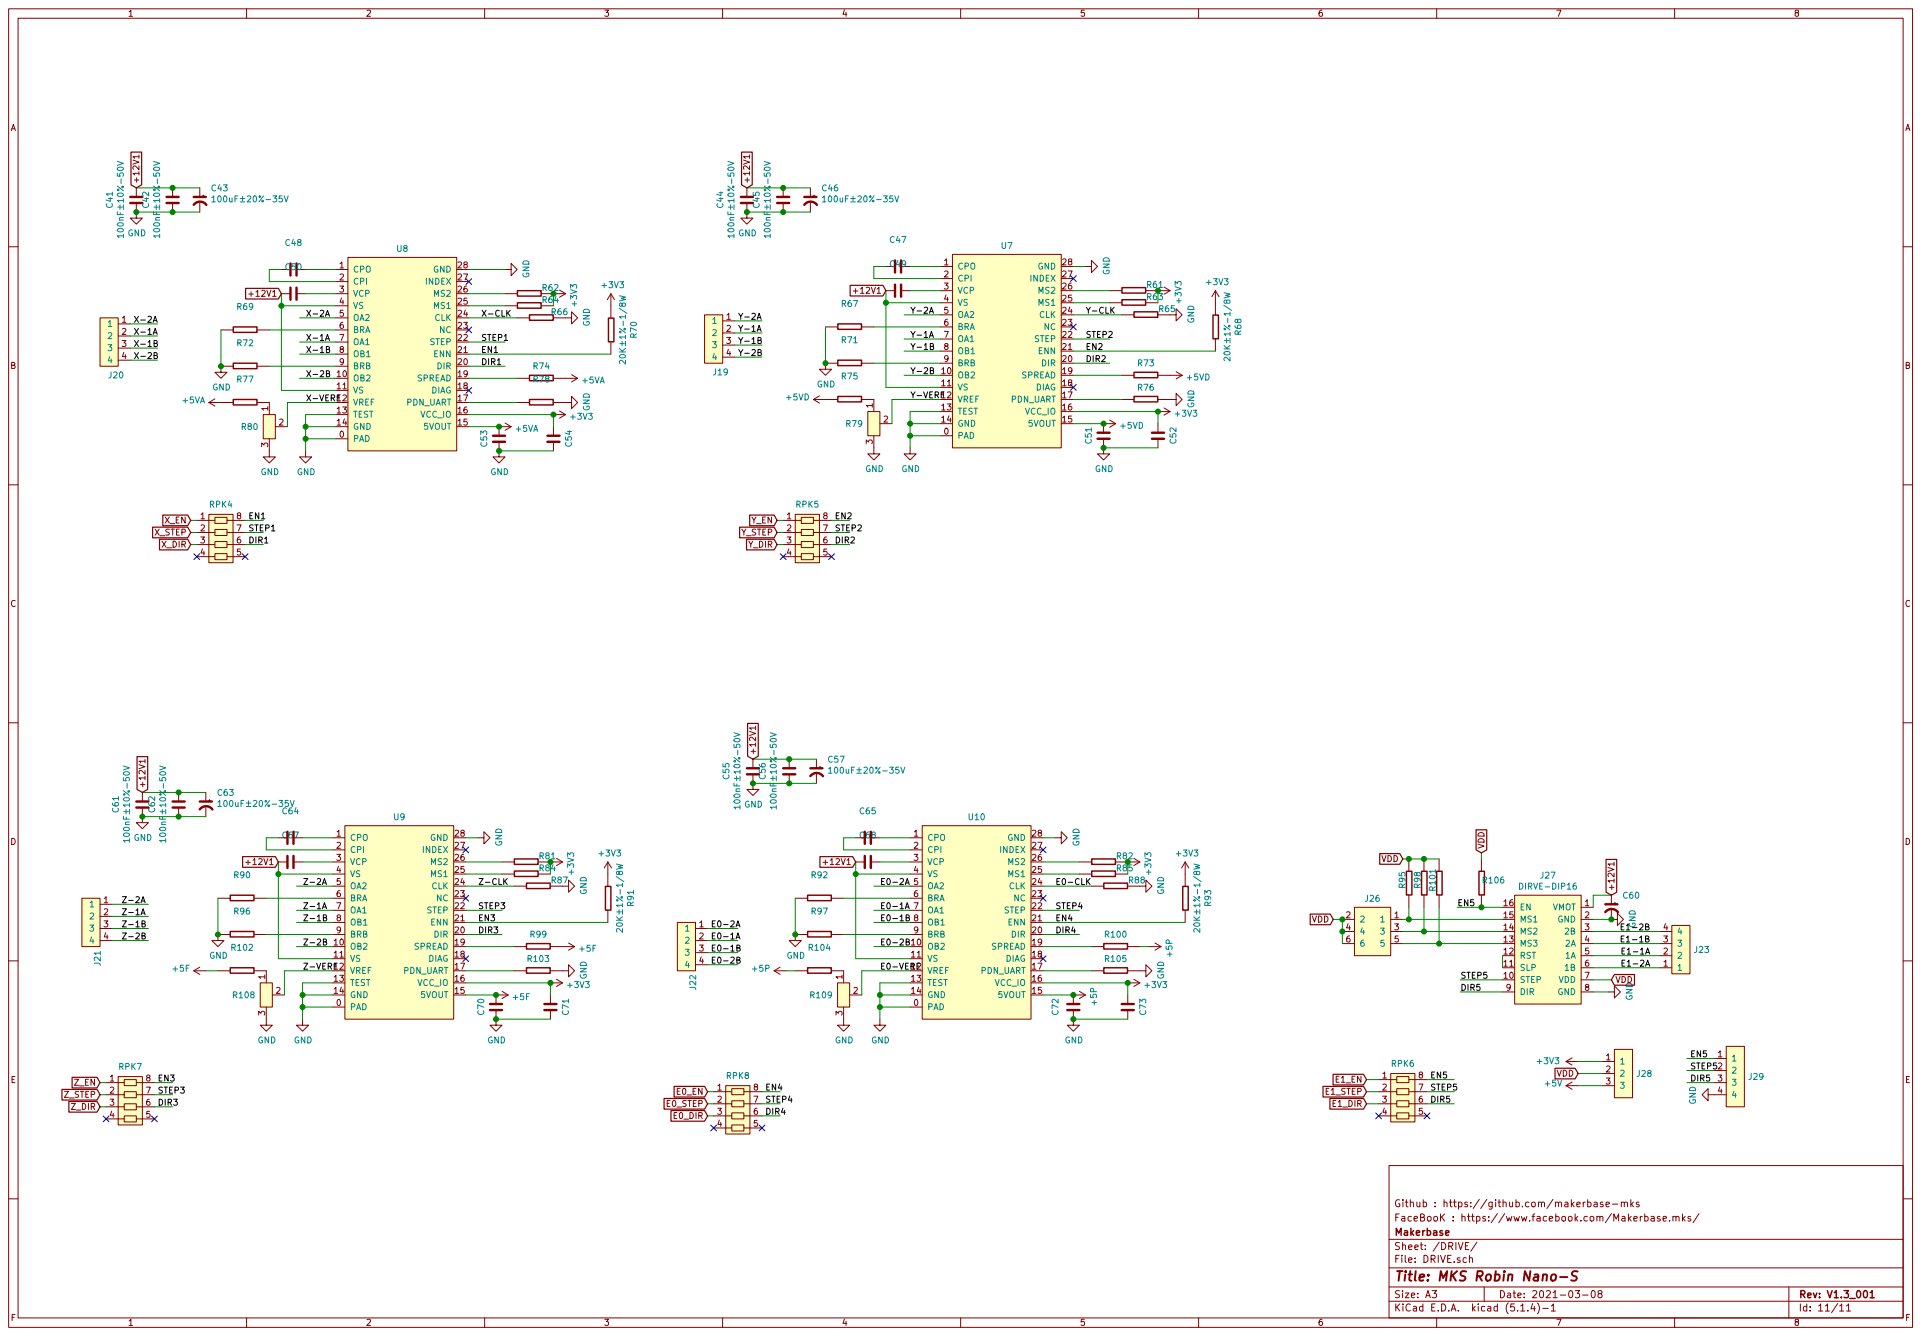
[picture p15: page 11]

Github : https://github.com/makerbase-mks R92 GND

File: DRIVE.sch Sheet: /DRIVE/ Makerbase FaceBooK : https://www.facebook.com/Makerbase.mks/

Id: 11/11 Title: MKS Robin Nano-S
