makerbase-mks/MKS-Robin-Nano-V1.X/hardware/MKS Robin Nano V1.3_002/MKS Robin Nano V1.3_002 BOTTOM.pdf

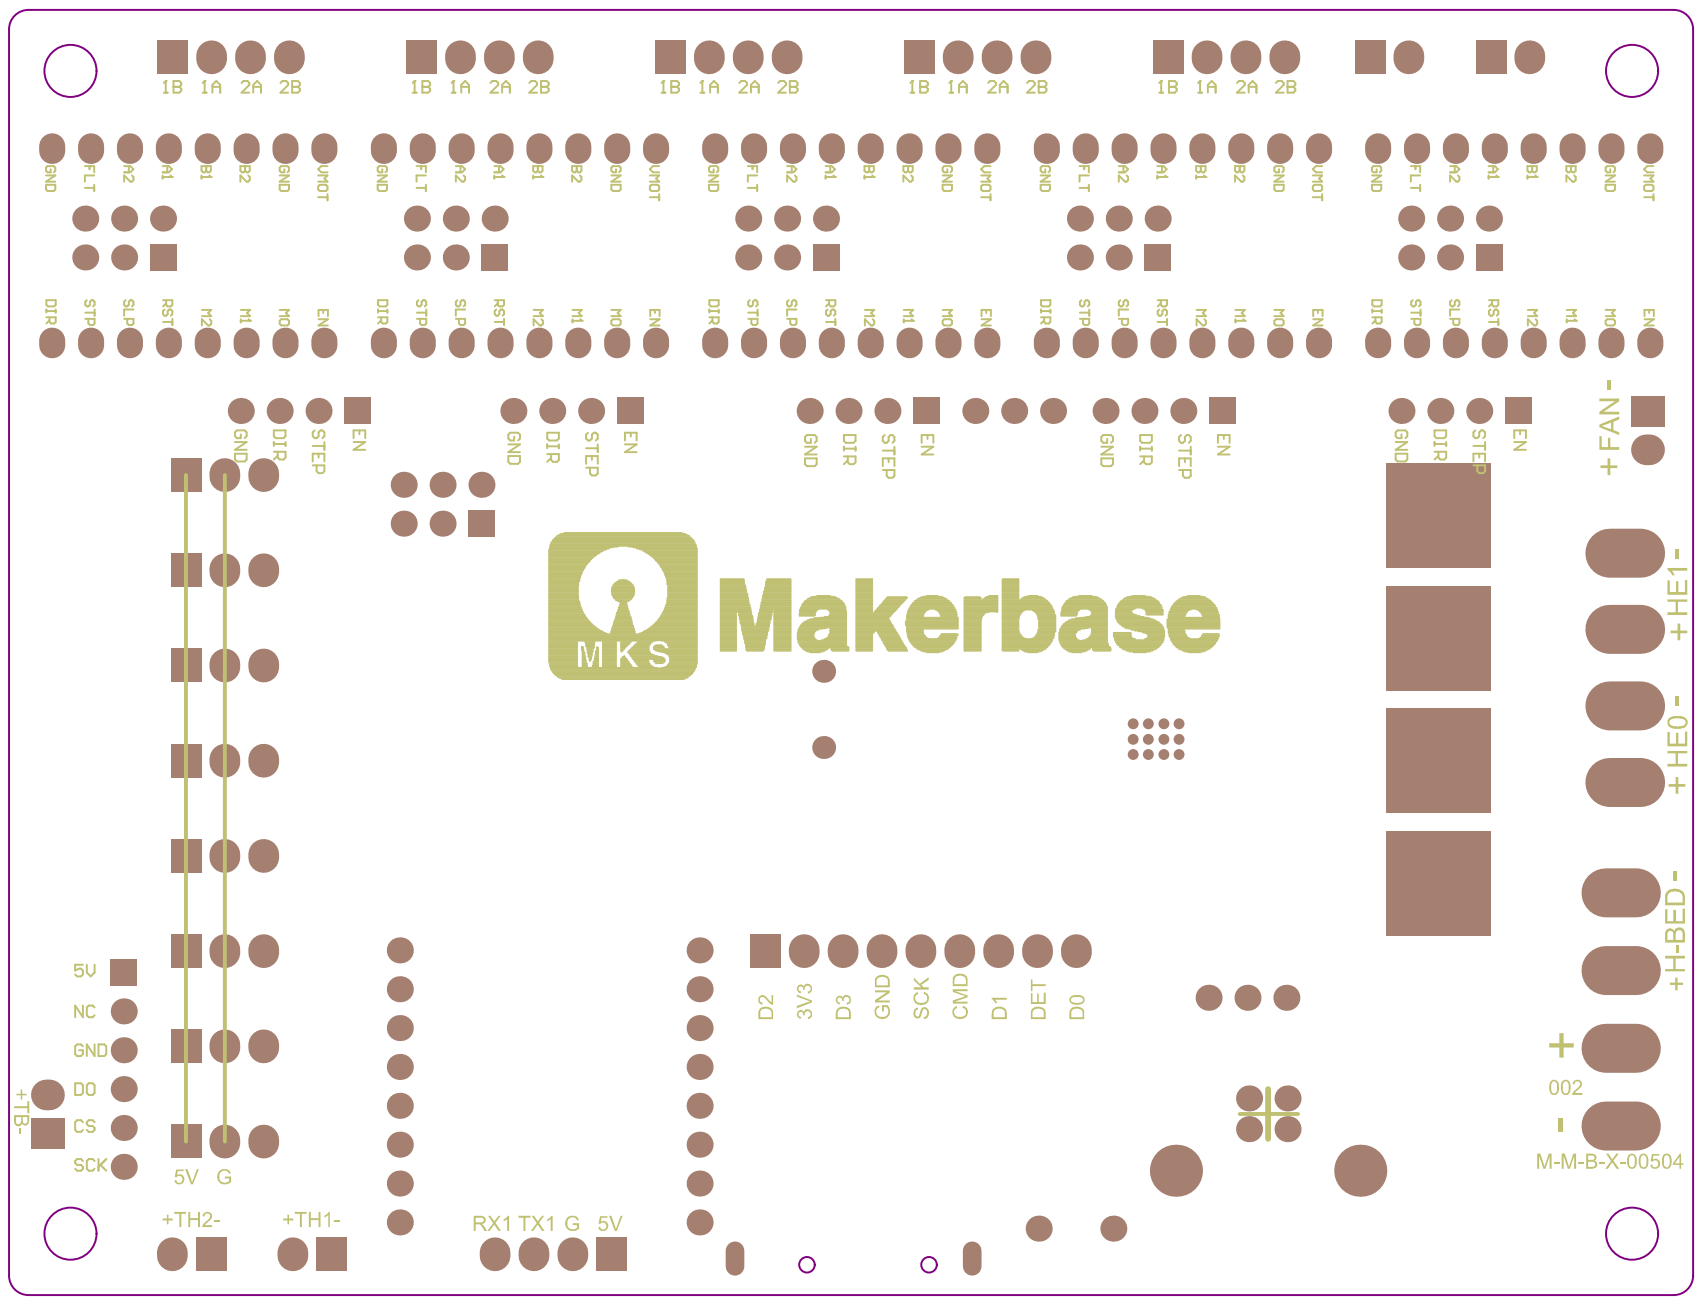
[picture p16: page 1]
