makerbase-mks/MKS-Robin-Nano-V1.X/hardware/MKS Robin Nano V1.3_002/MKS Robin Nano V1.3_002 PIN.pdf

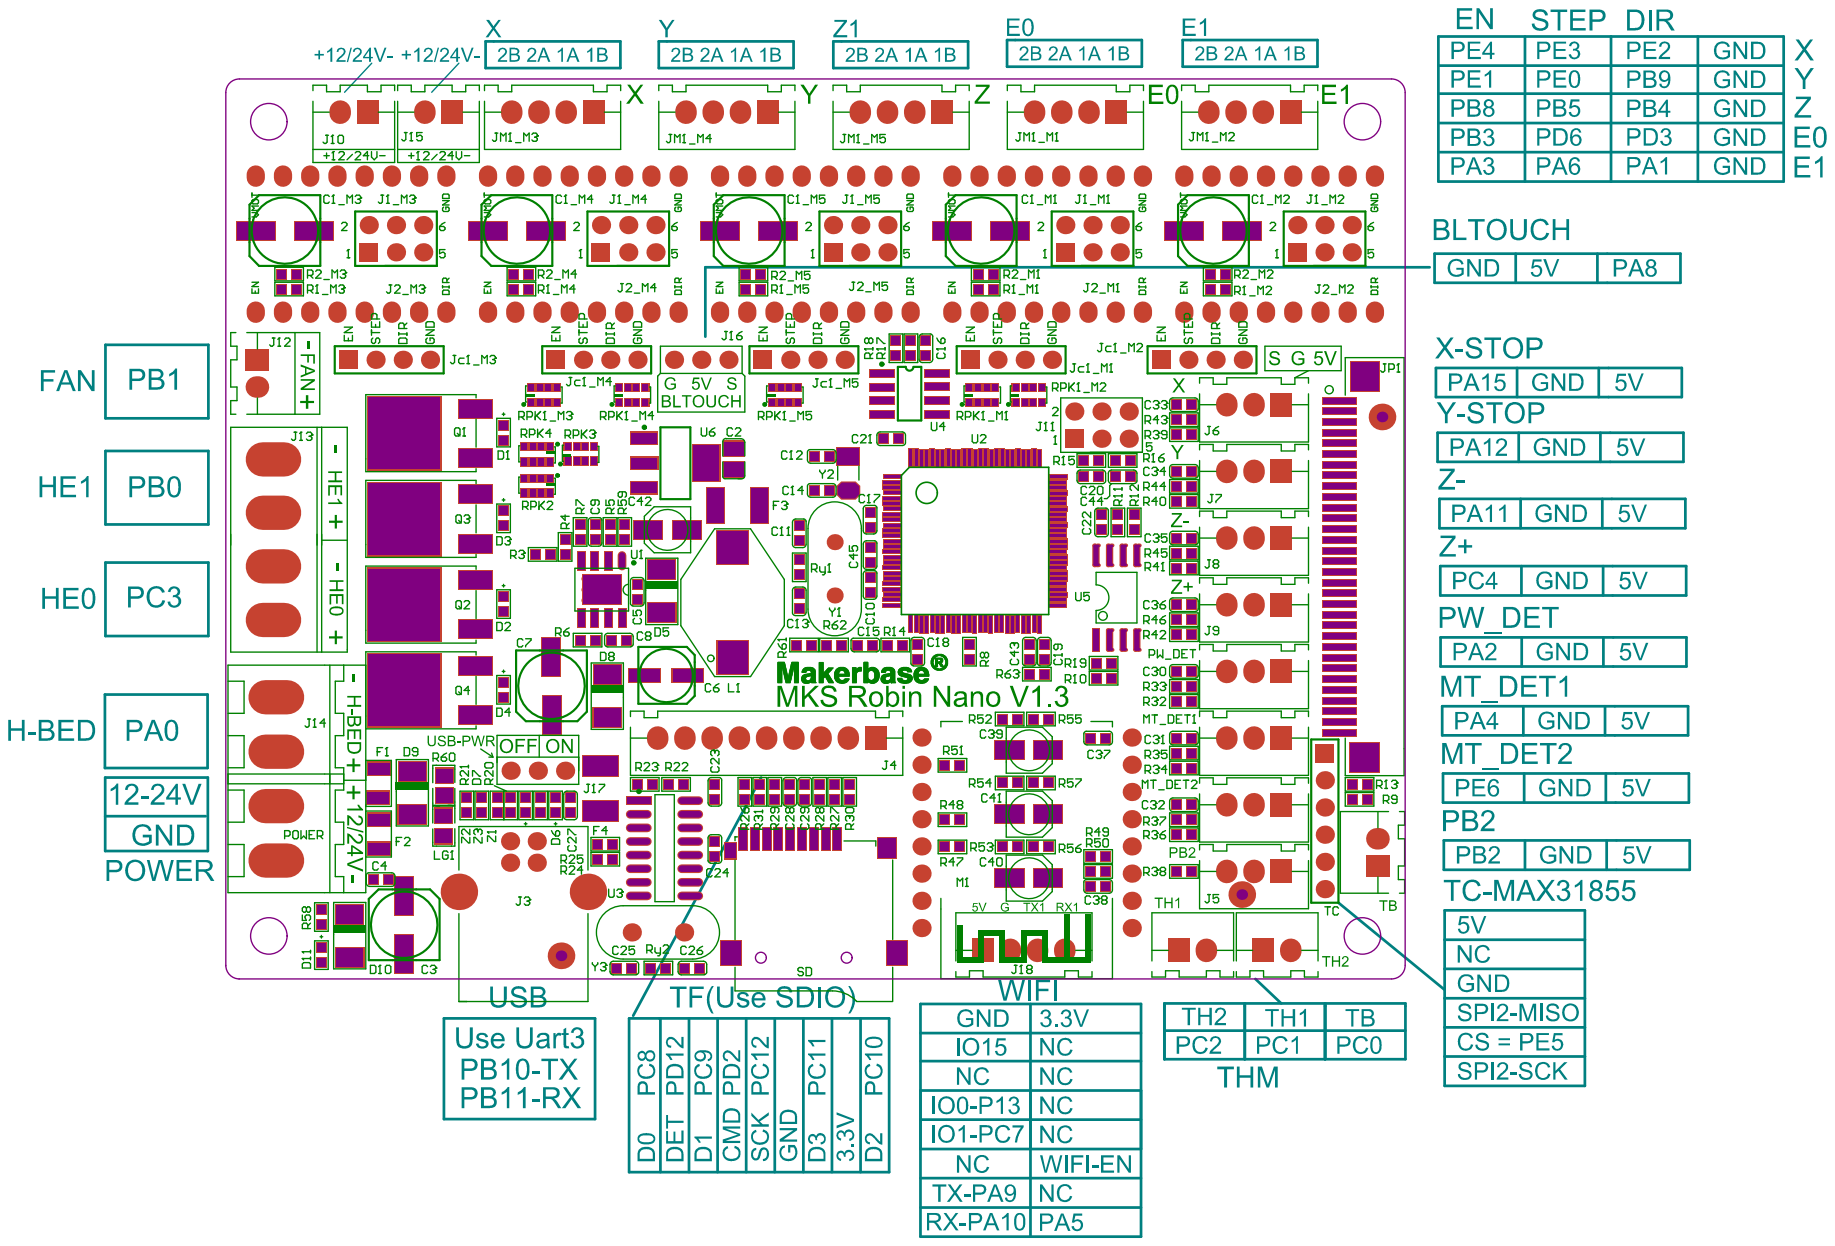
[picture p17: page 1]
