makerbase-mks/MKS-Robin-Nano-V1.X/hardware/MKS Robin Nano V1.3_002/MKS Robin Nano V1.3_002 SCH.pdf

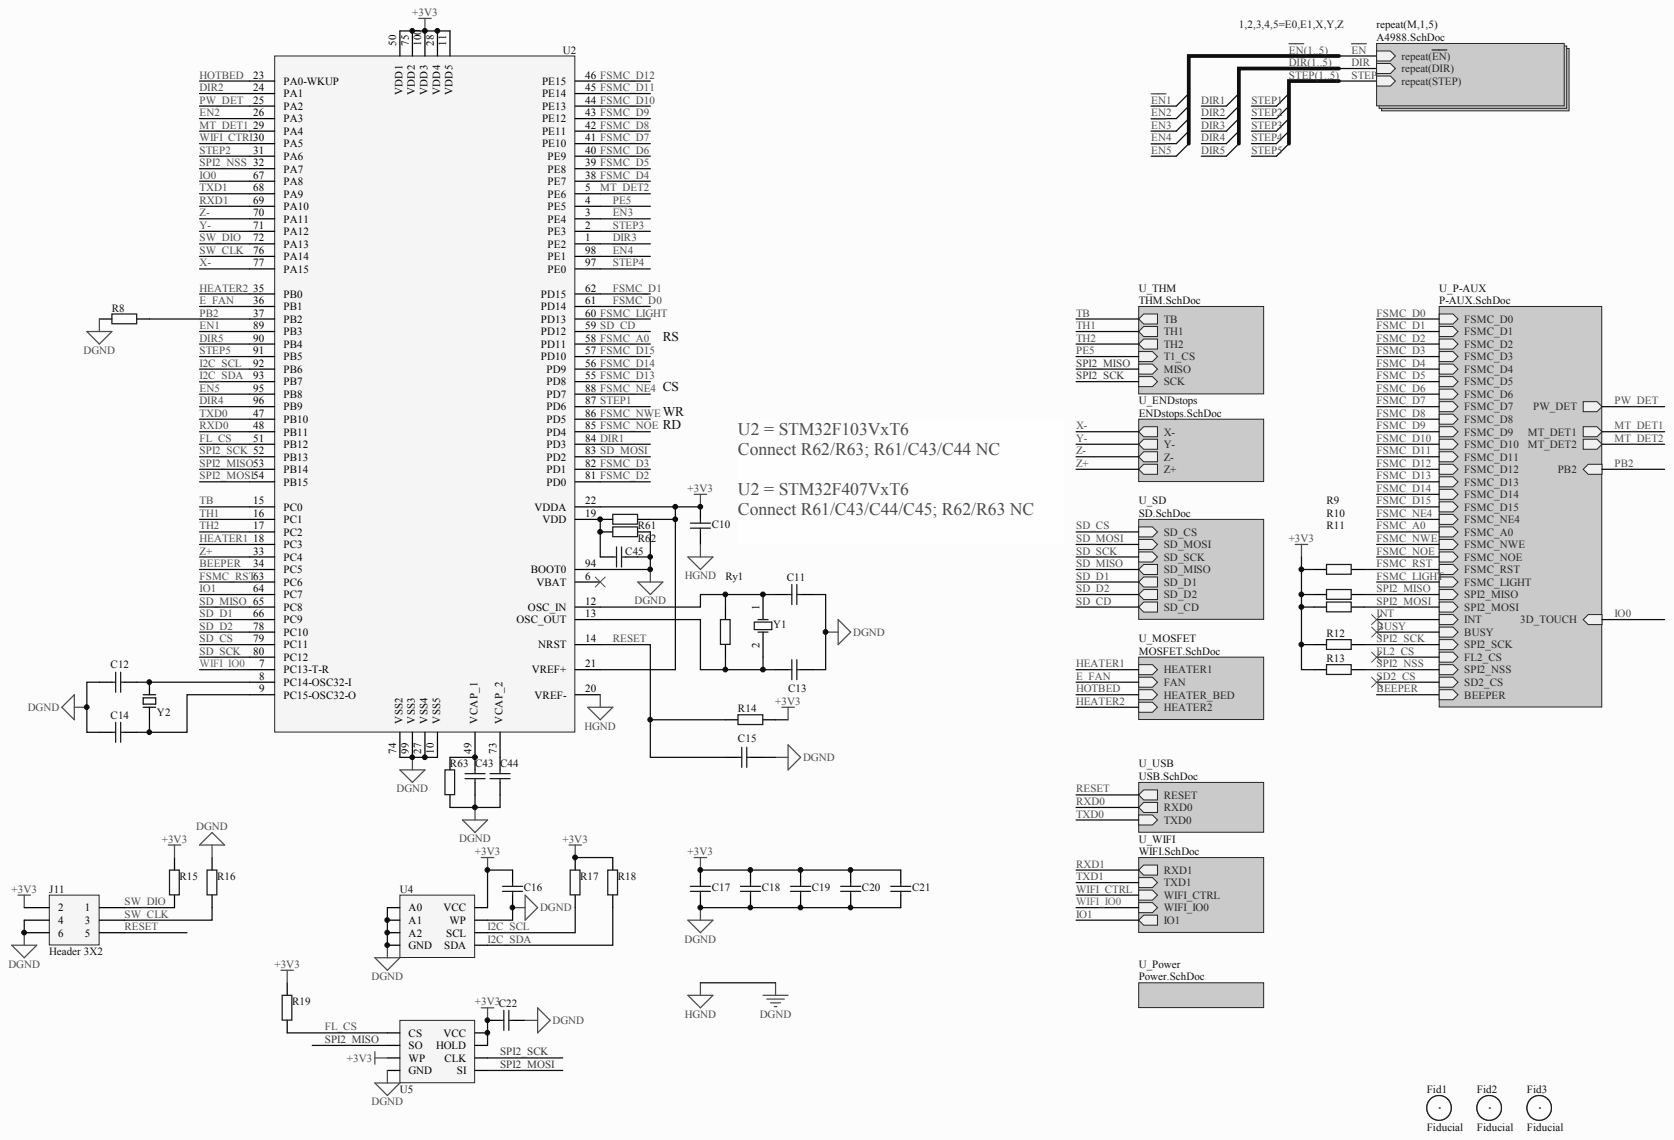
[picture p18: page 1]

DIR(1.. 5 ) | DI R
S T E P(1.. 5 | ) S T E | P

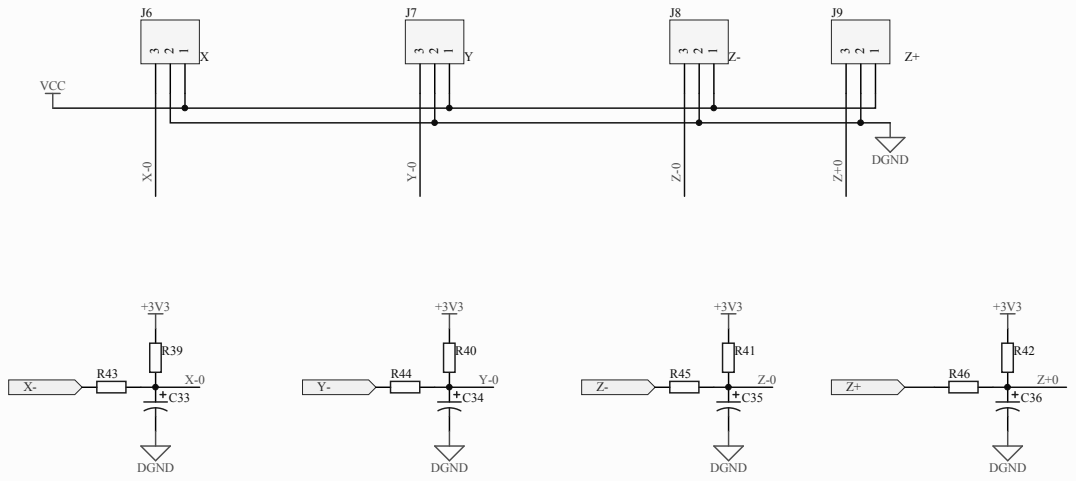
[picture p19: page 2]

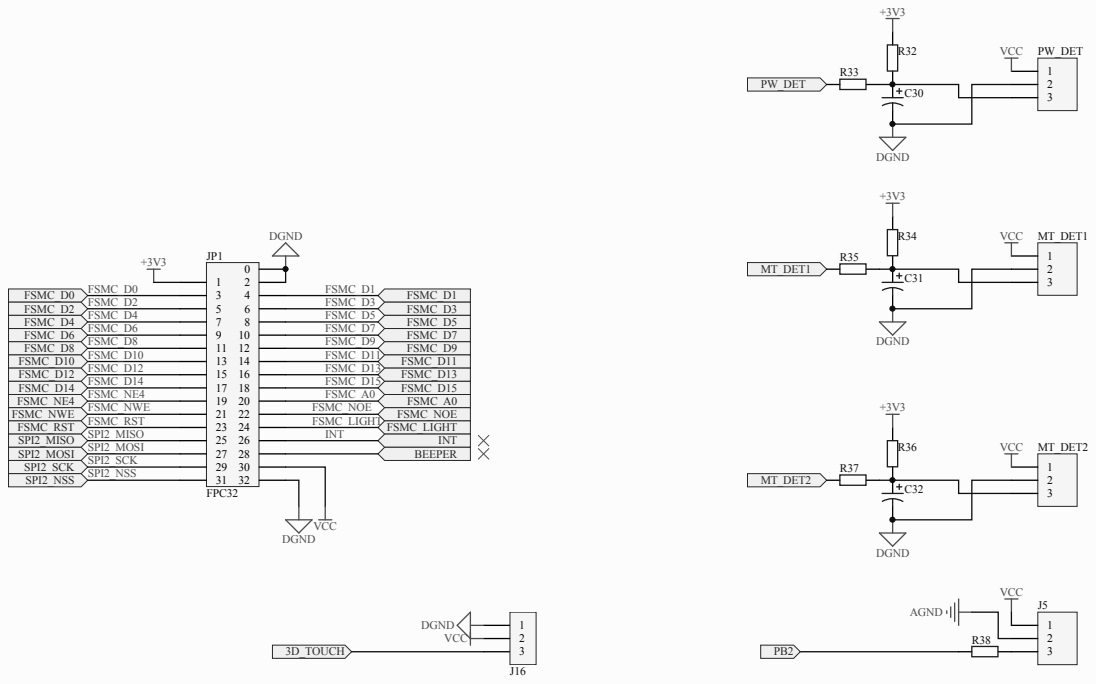
[picture p20: page 3]

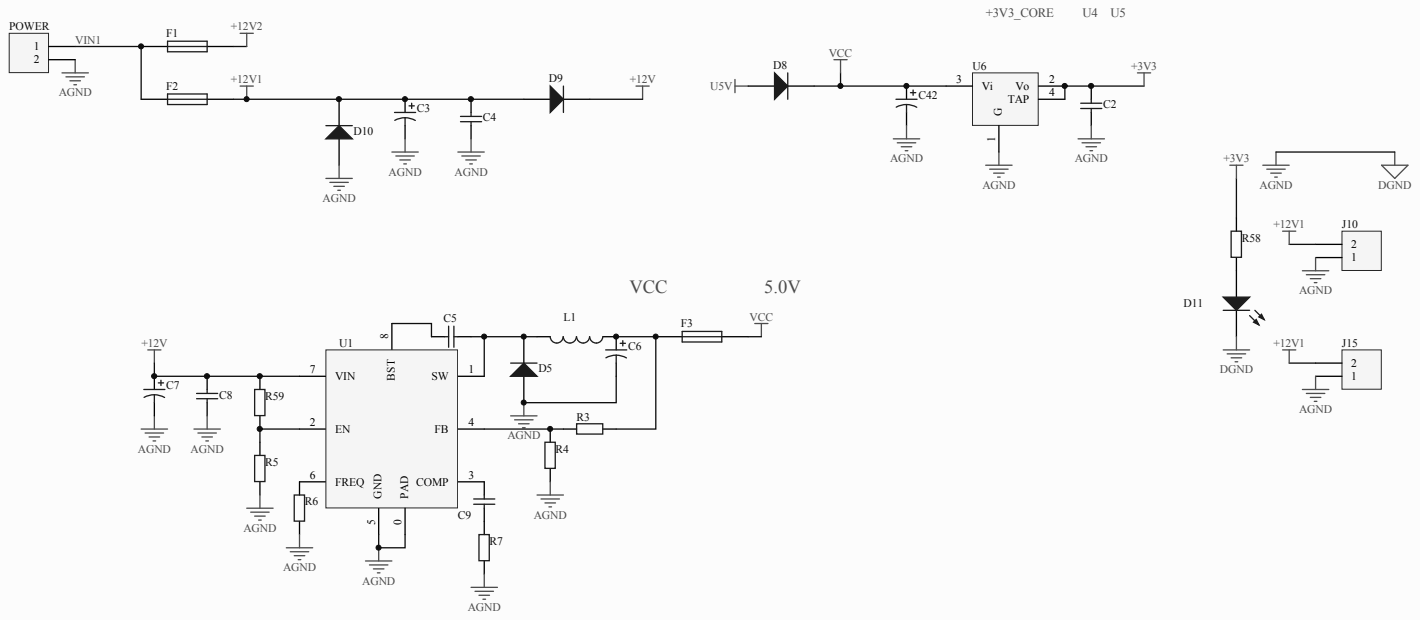
[picture p21: page 4]

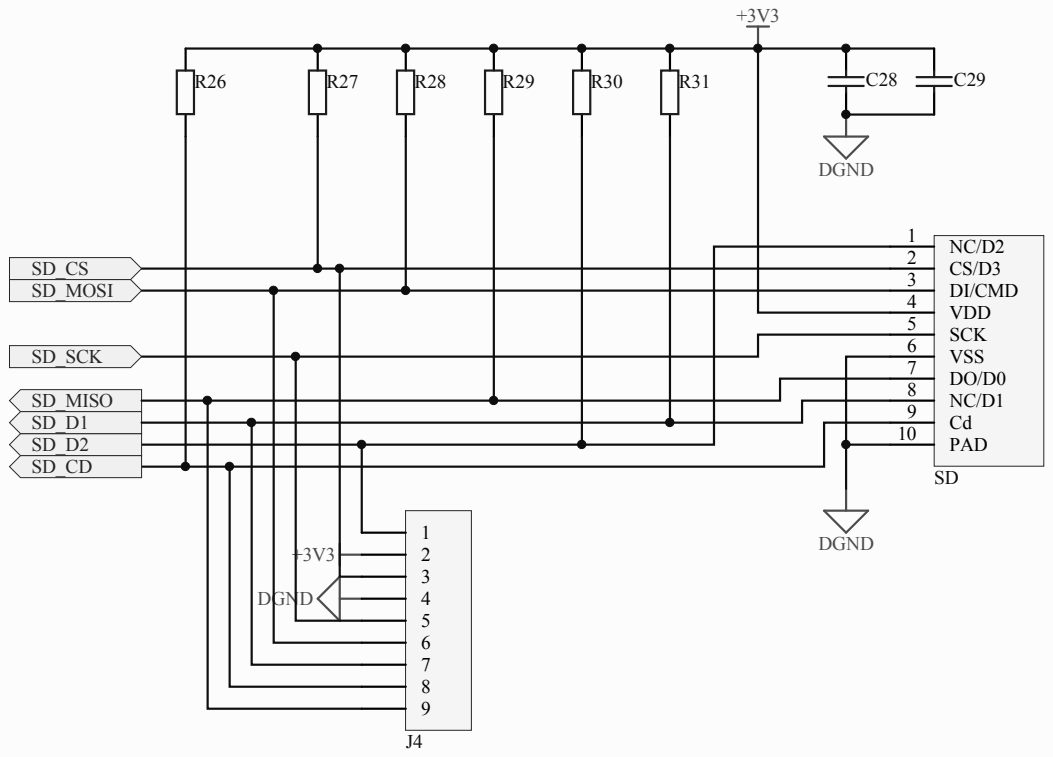
[picture p22: page 5]

CS/D3 2
DI/CMD 3
VDD 4

VSS 6
DO/D0 7
NC/D1 8
Cd 9
PAD 10

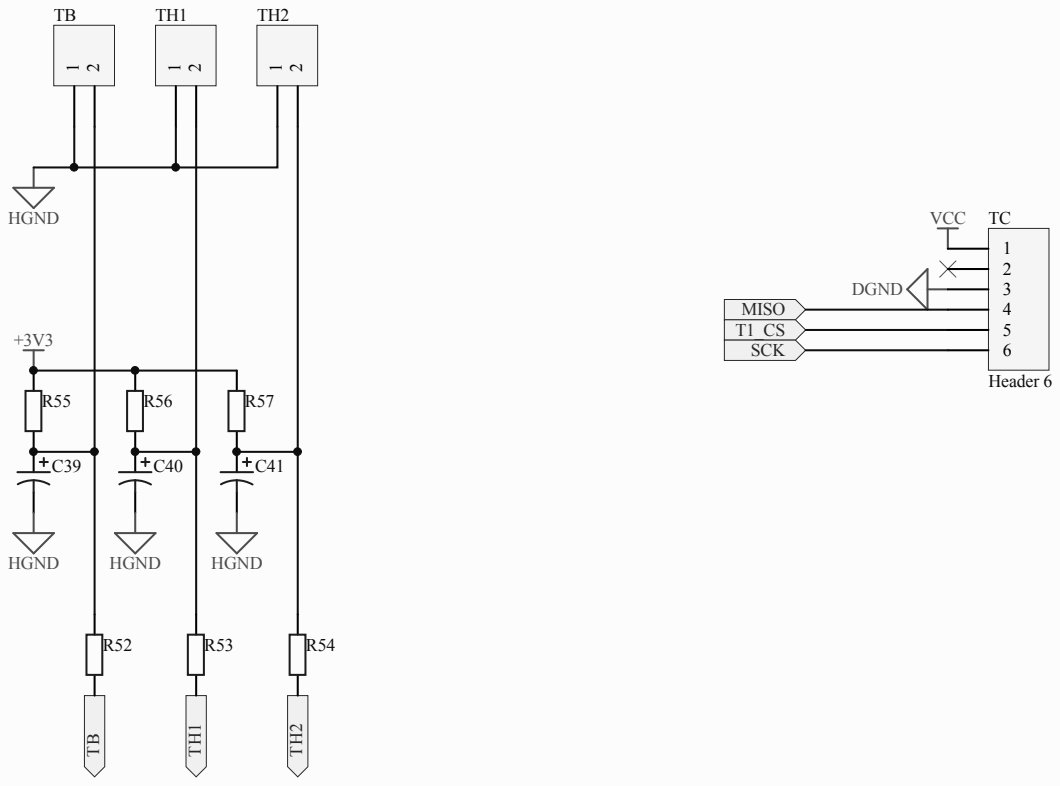
[picture p23: page 6]

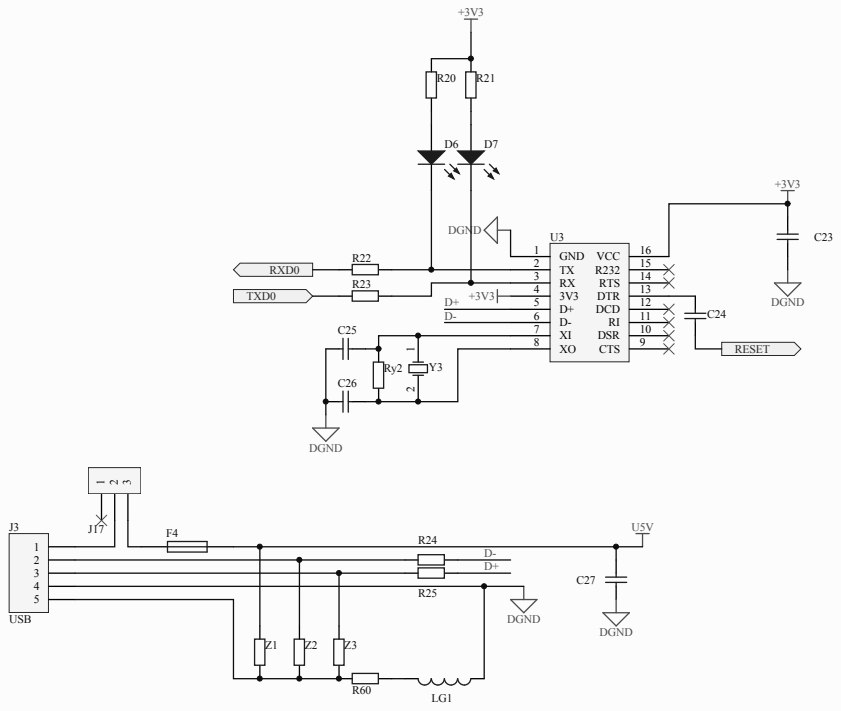
[picture p24: page 7]

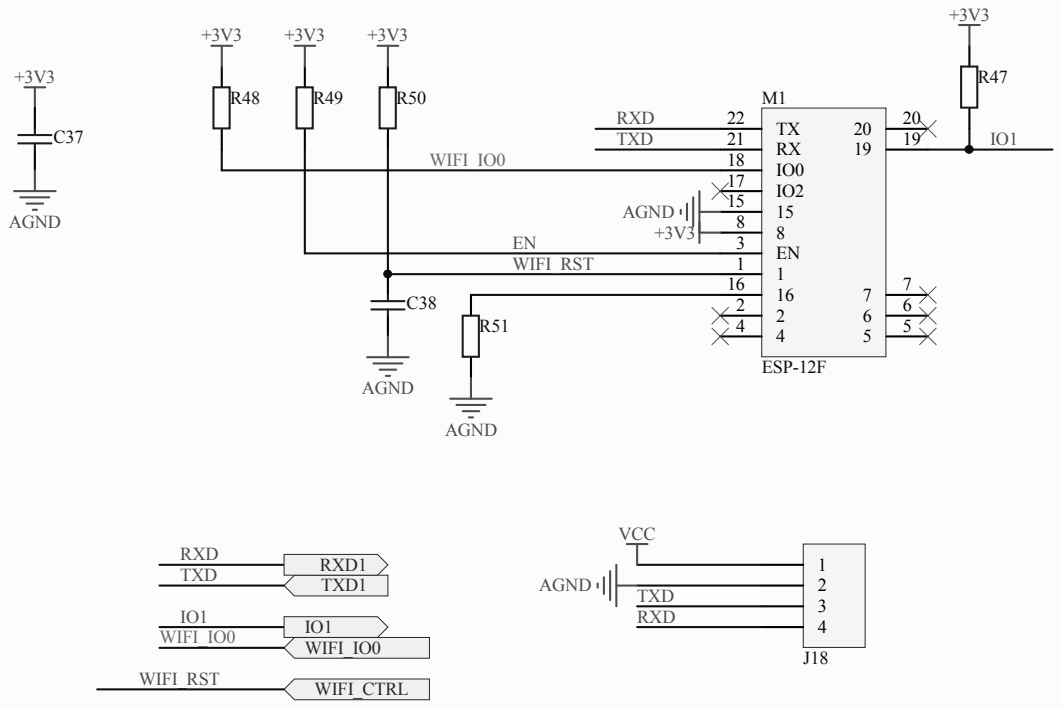
[picture p25: page 8]

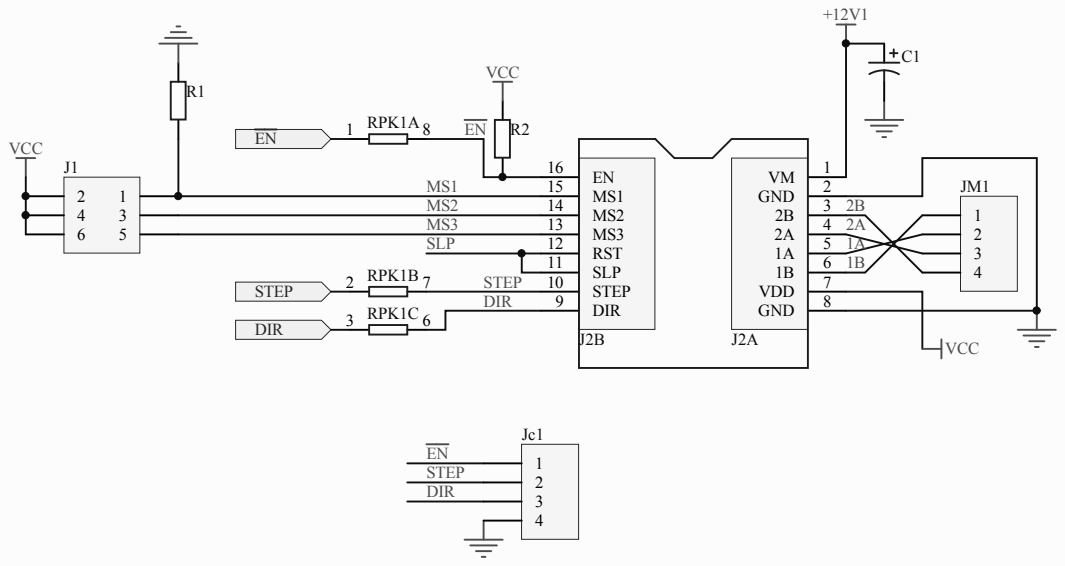
[picture p26: page 9]

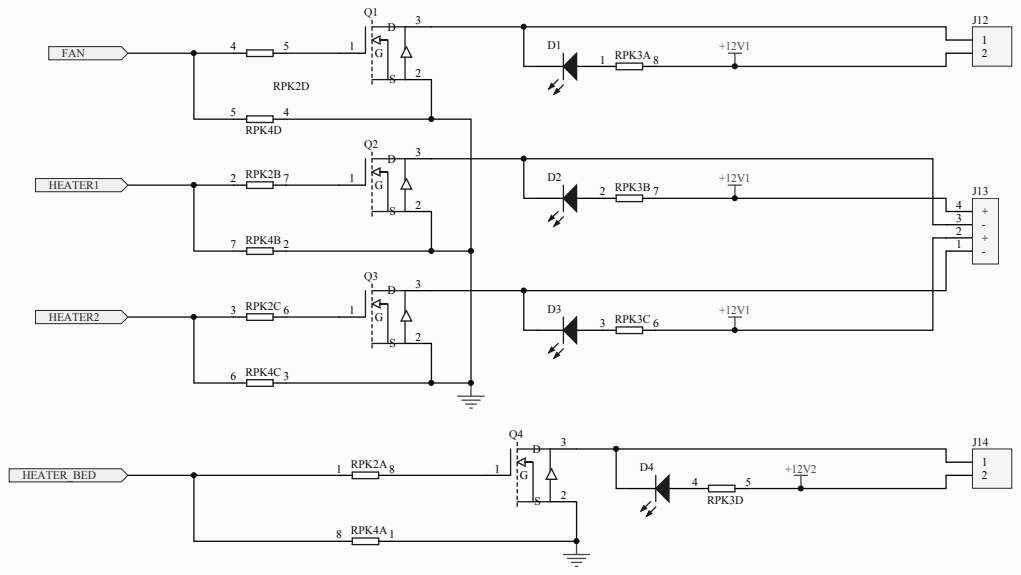
[picture p27: page 10]
