makerbase-mks/MKS-Robin-Nano-V1.X/hardware/MKS Robin Nano V1.3_002/MKS Robin Nano V1.3_002 SIZE.pdf

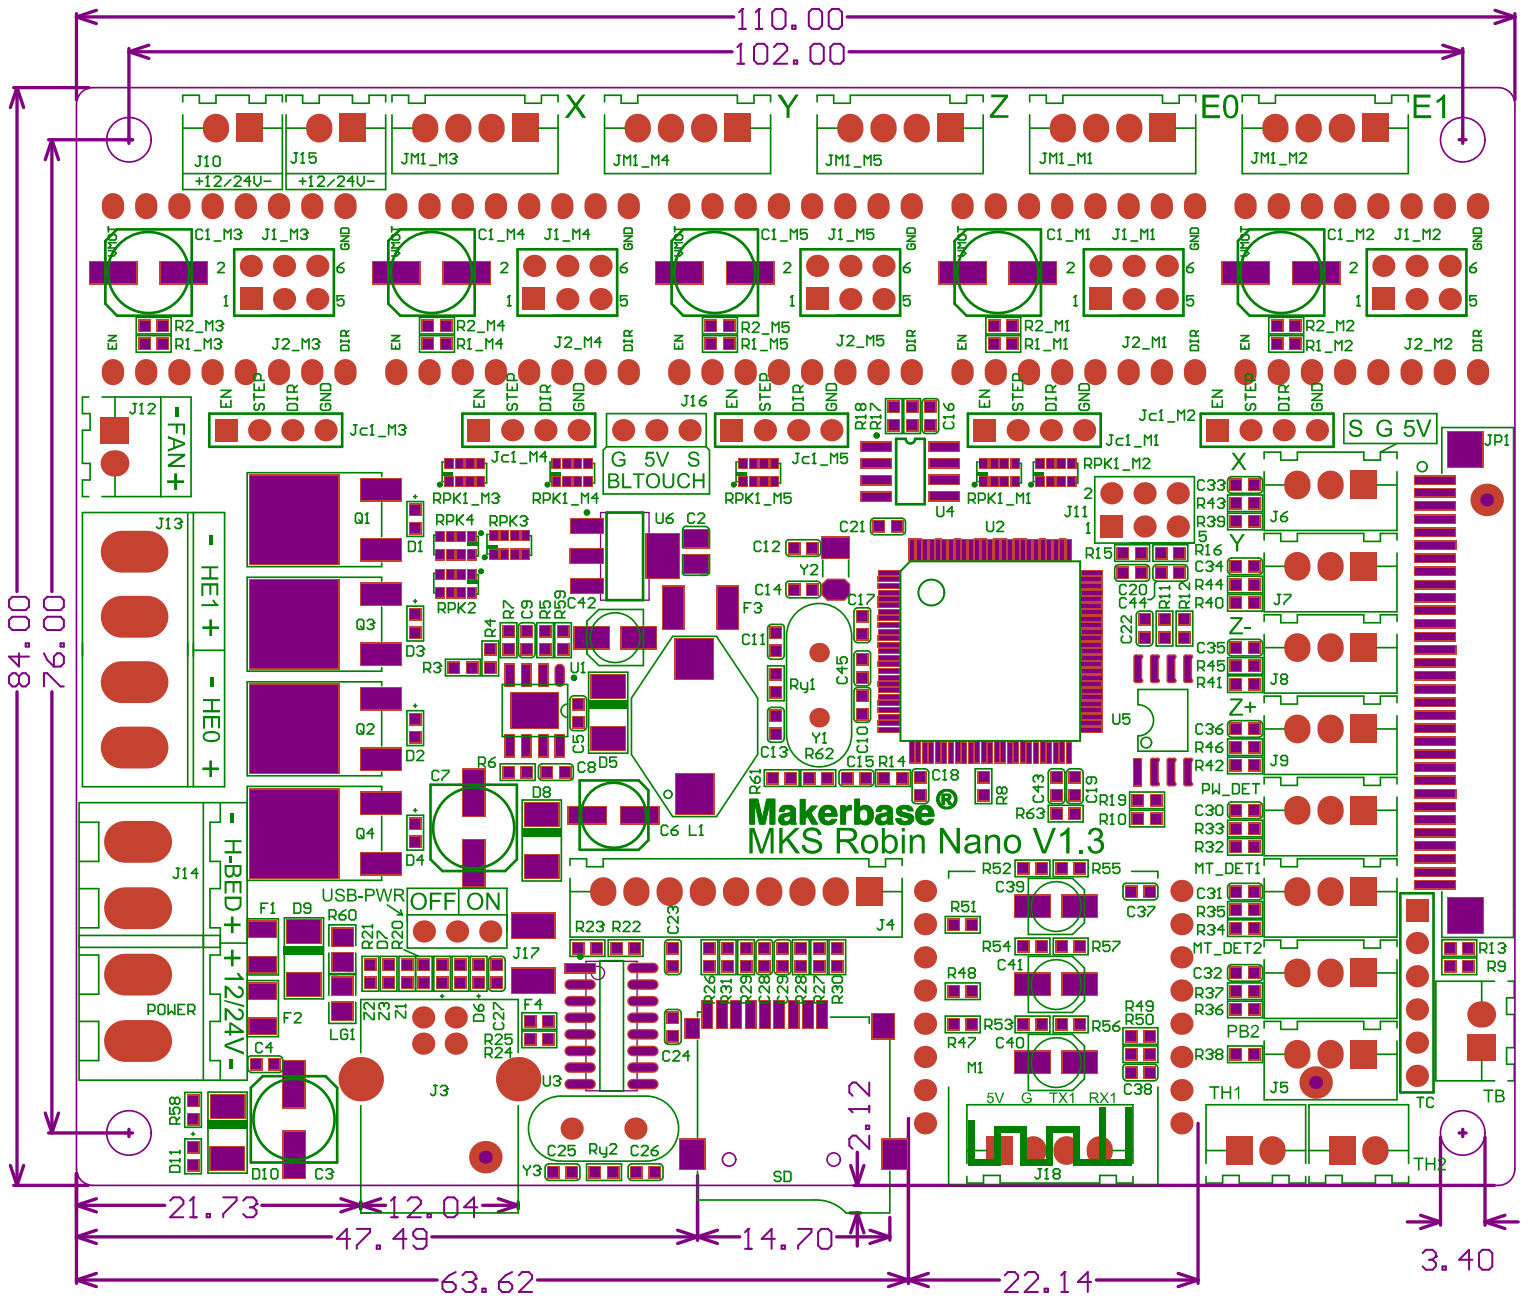
[picture p28: page 1]
