makerbase-mks/MKS-Robin-Nano-V1.X/hardware/MKS Robin Nano-S V1.3_001/MKS Robin Nano-S V1.3_001 BOTTOM.pdf

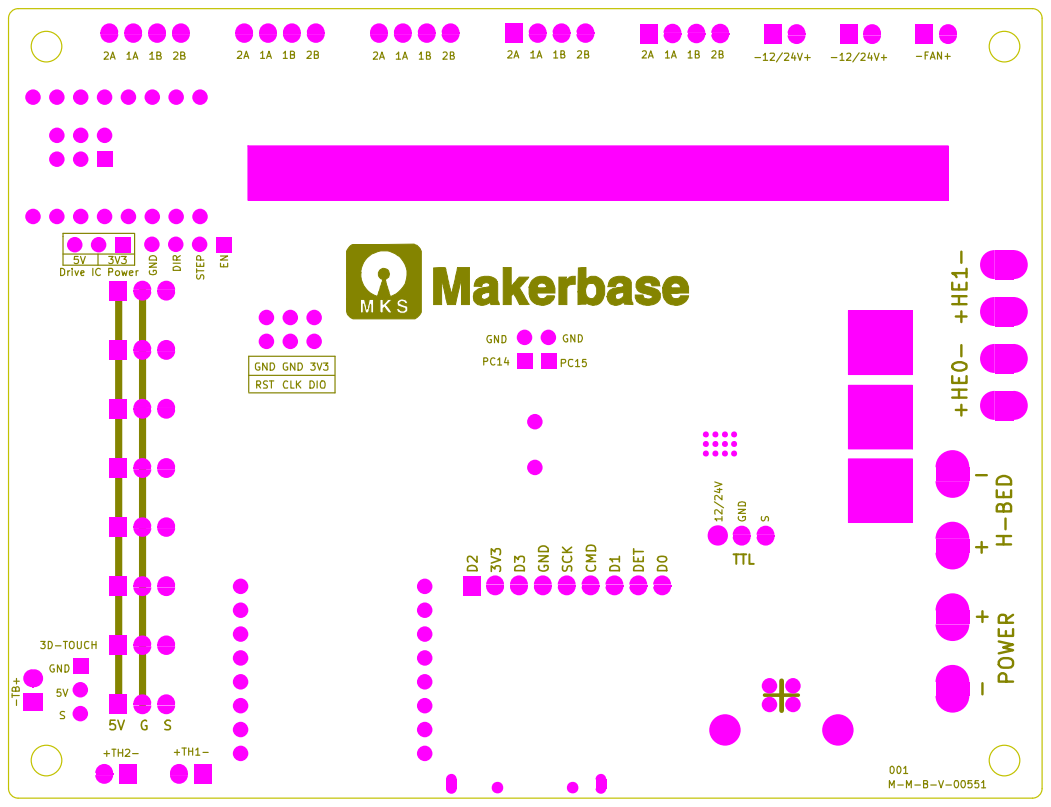
[picture p30: page 1]
