makerbase-mks/MKS-Robin-Nano-V1.X/hardware/MKS Robin Nano-S V1.3_001/MKS Robin Nano-S V1.3_001 PIN.pdf

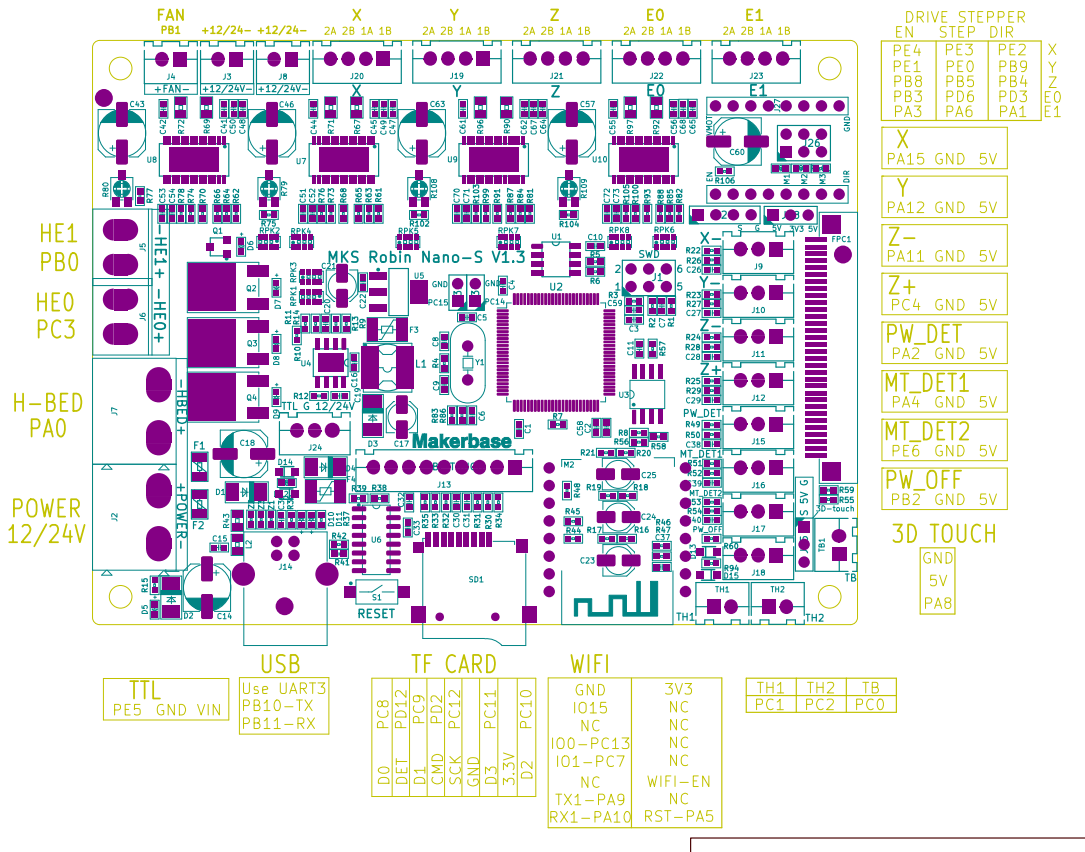
[picture p31: page 1]
