makerbase-mks/MKS-Robin-Nano-V1.X/hardware/MKS Robin Nano-S V1.3_001/MKS Robin Nano-S V1.3_001 SIZE.pdf

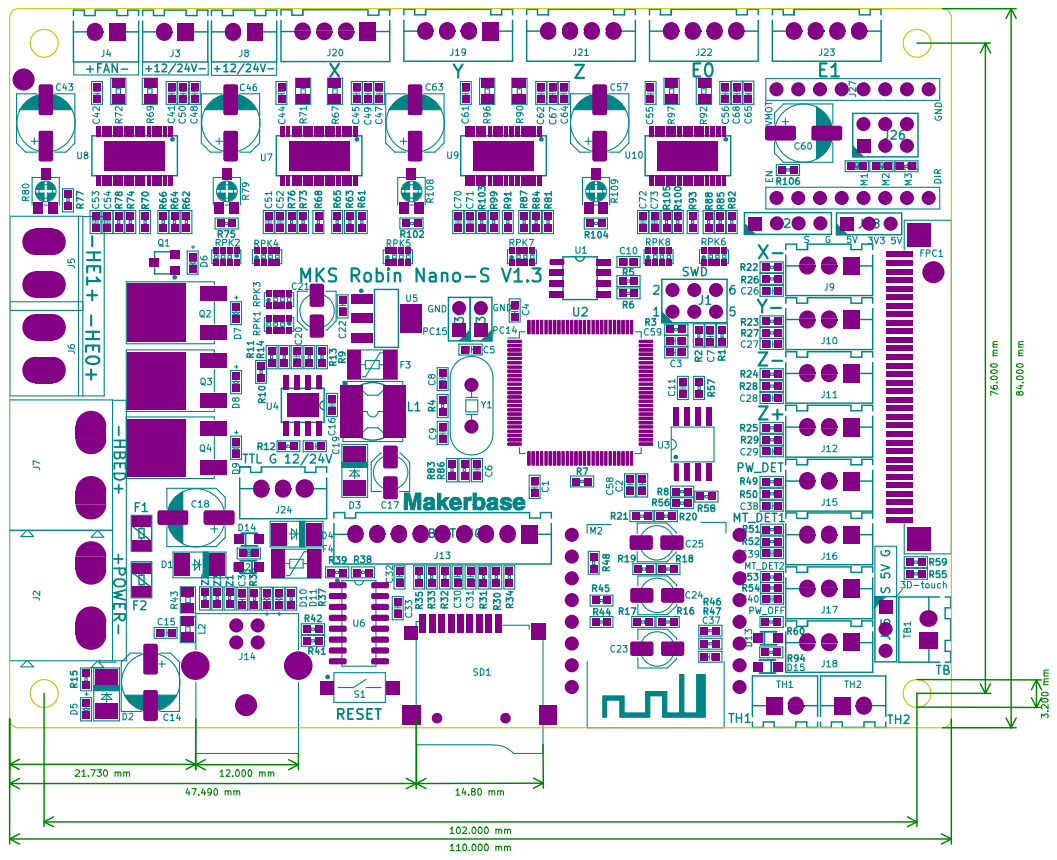
[picture p32: page 1]
