makerbase-mks/MKS-Robin-Nano-V1.X/hardware/MKS Robin Nano-S V1.3_001/MKS Robin Nano-S V1.3_001 TOP.pdf

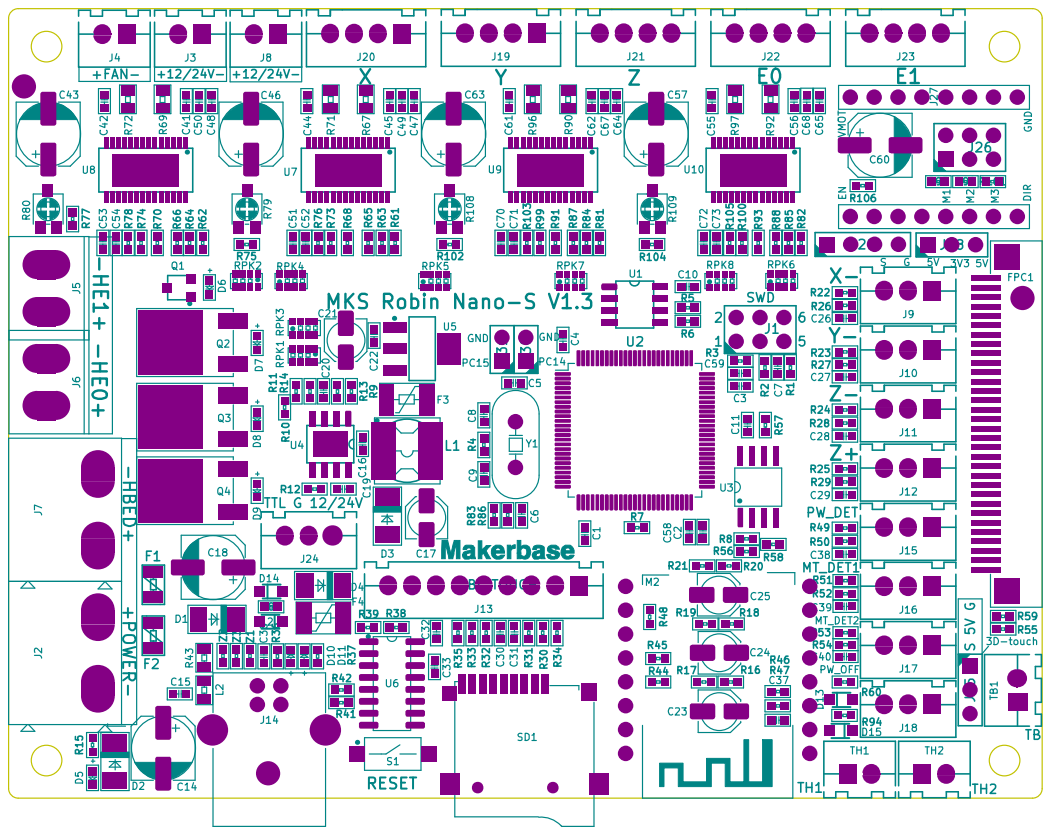
[picture p33: page 1]
