makerbase-mks/MKS-Robin-Nano-V1.X/hardware/MKS Robin Nano V1.1_001/MKS Robin Nano V1.1_001 SCH.pdf

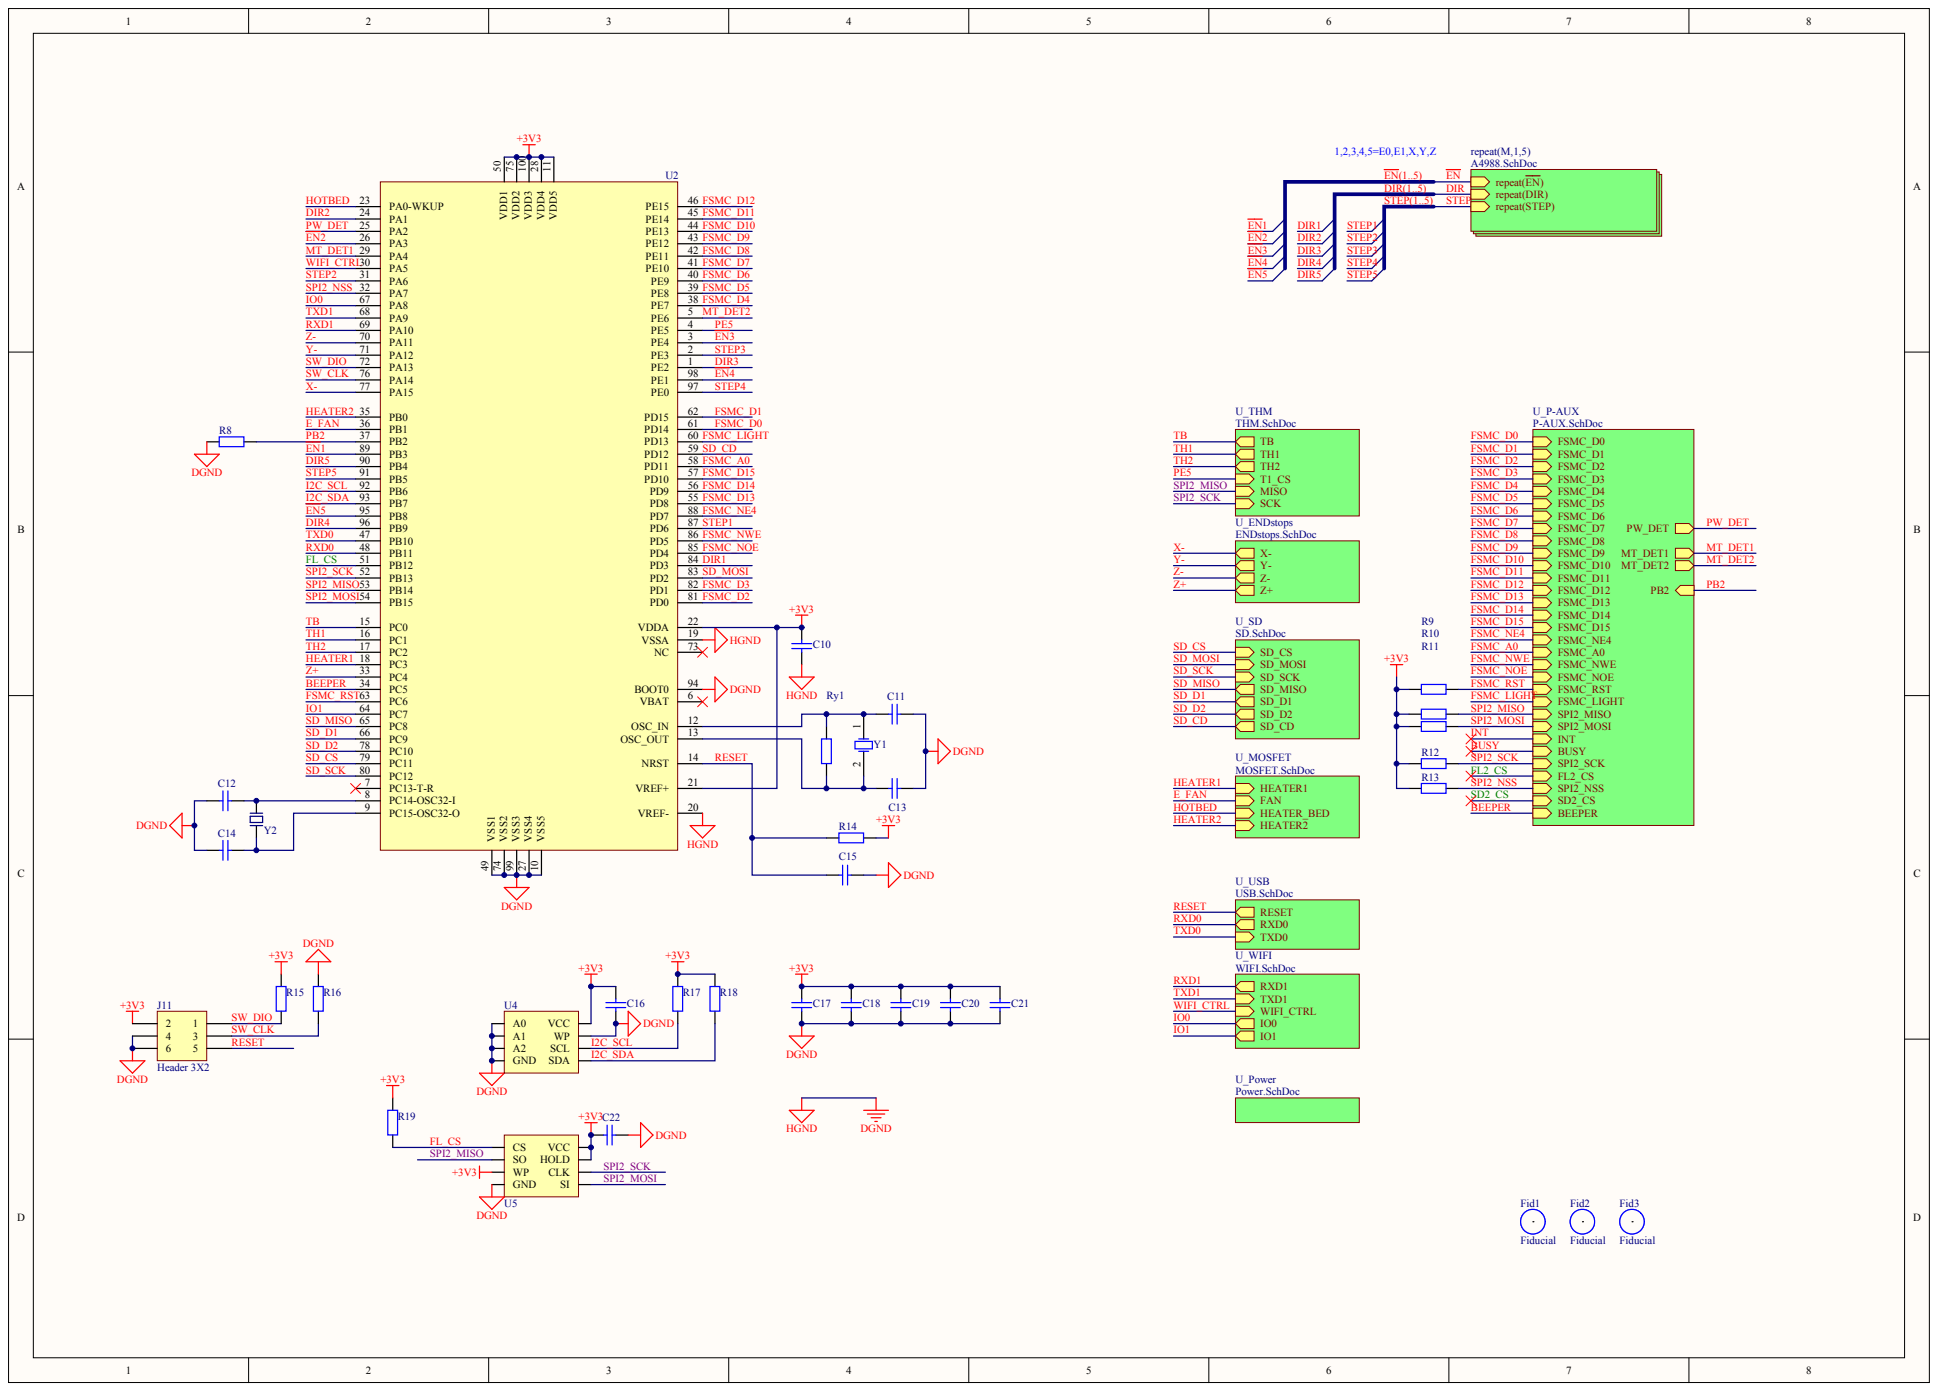
[picture p34: page 1]

DIR(1.. 5 ) | DIR STEP
STEP(1..5)

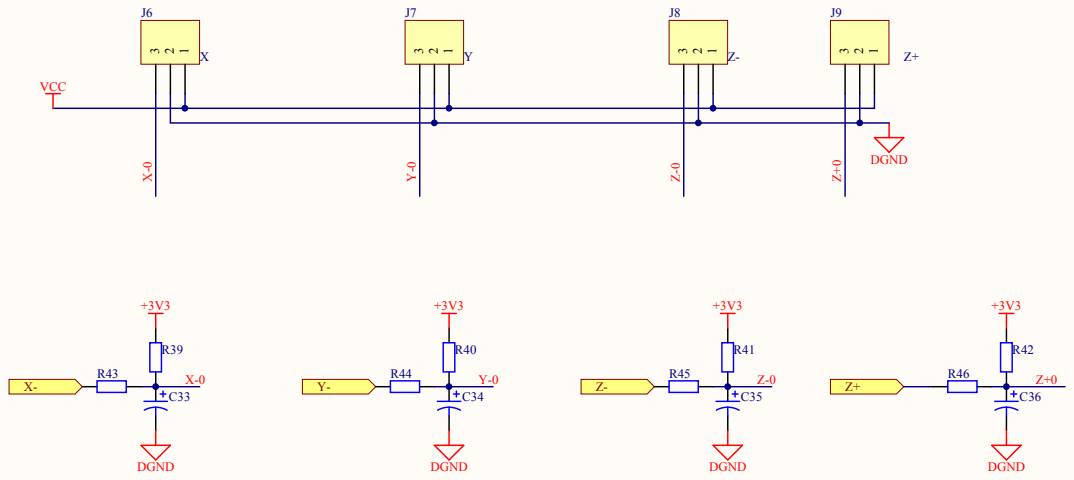
[picture p35: page 2]

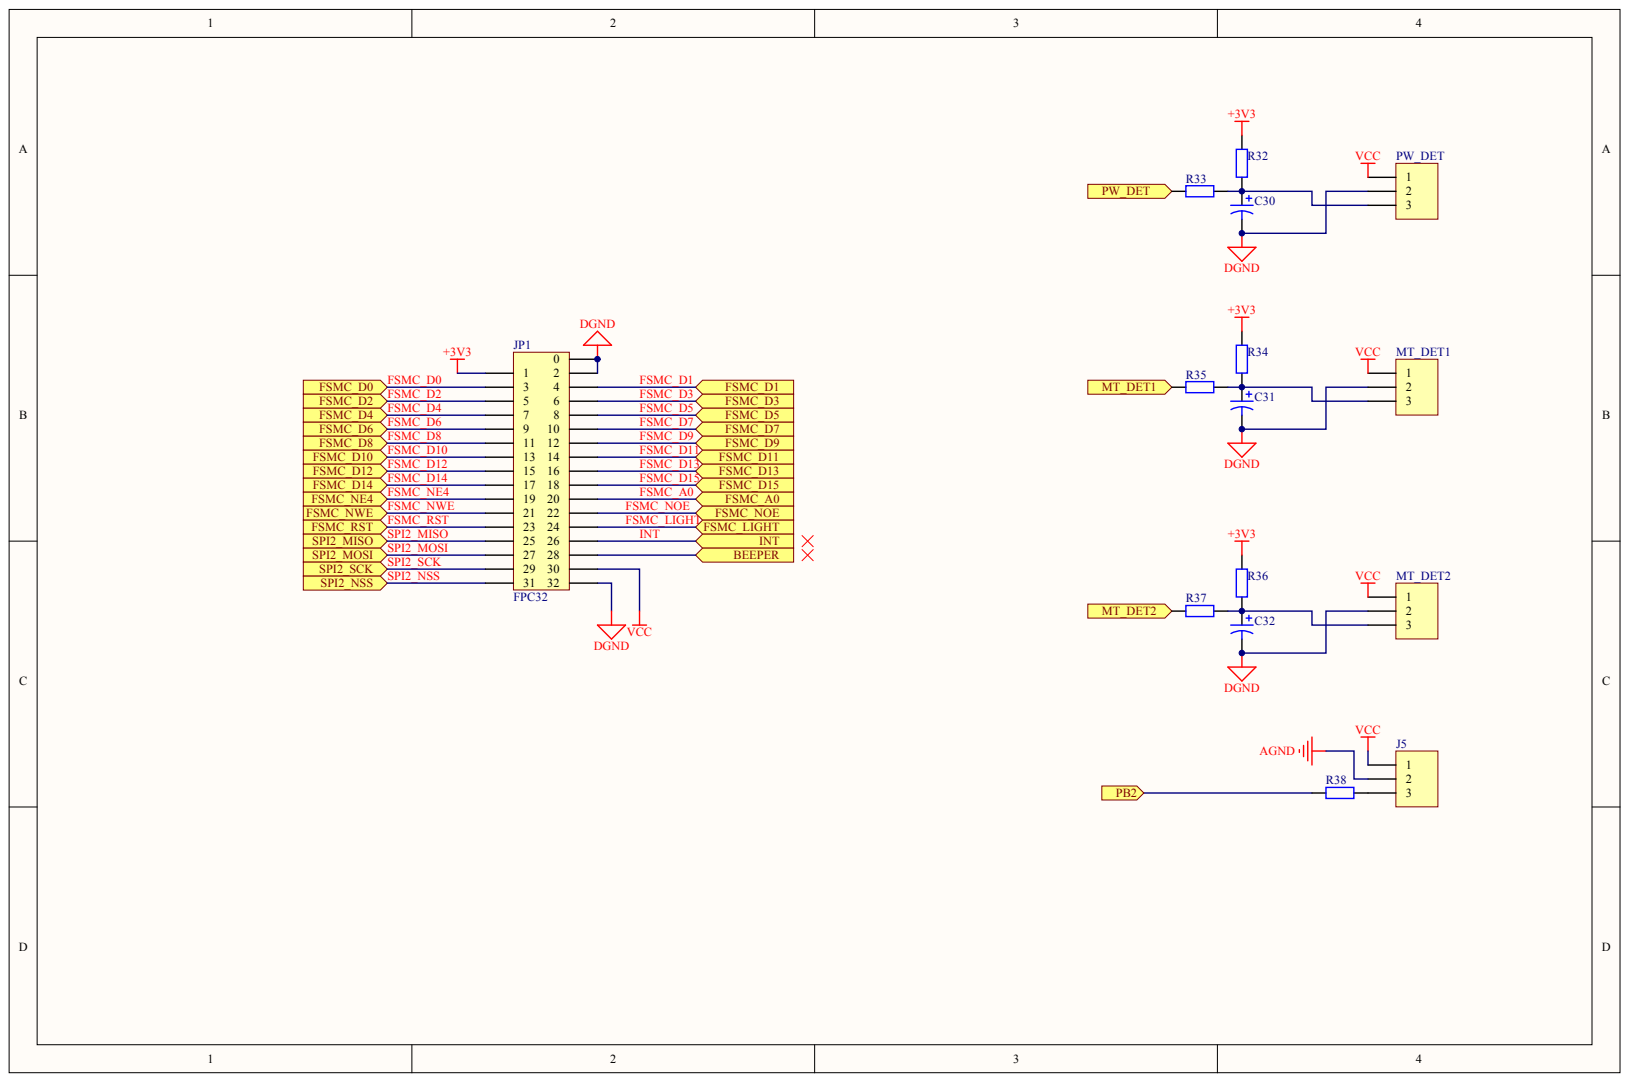
[picture p36: page 3]

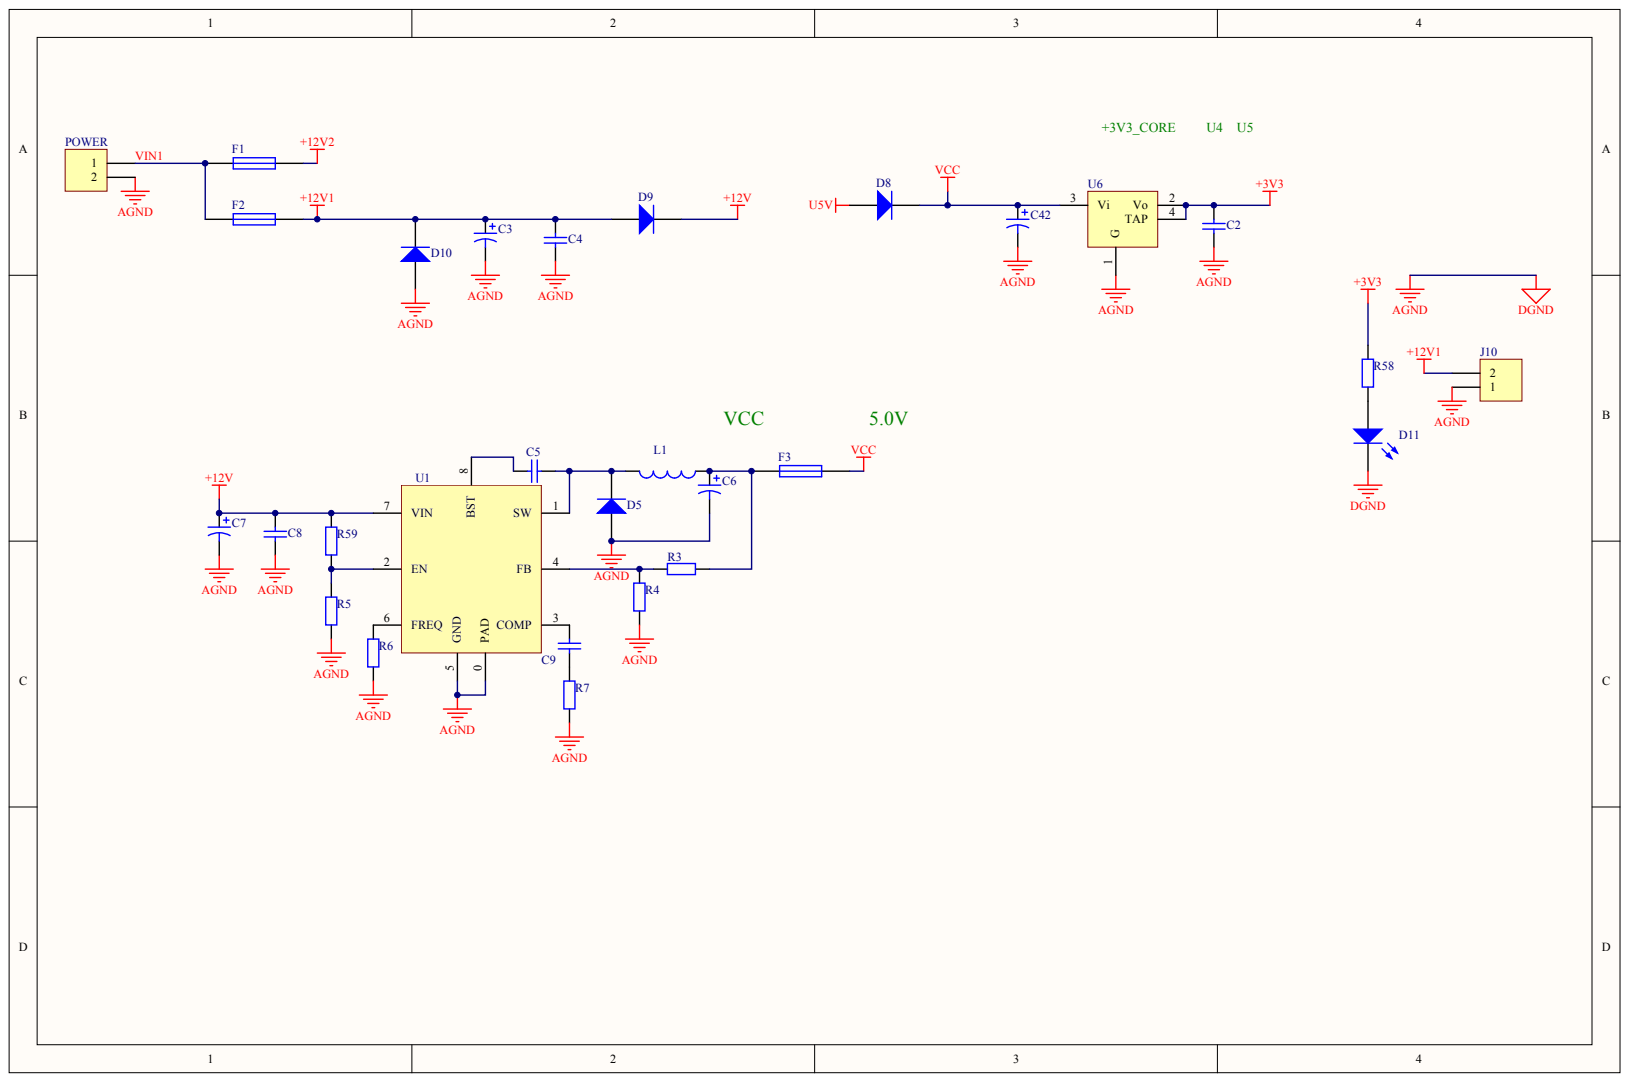
[picture p37: page 4]

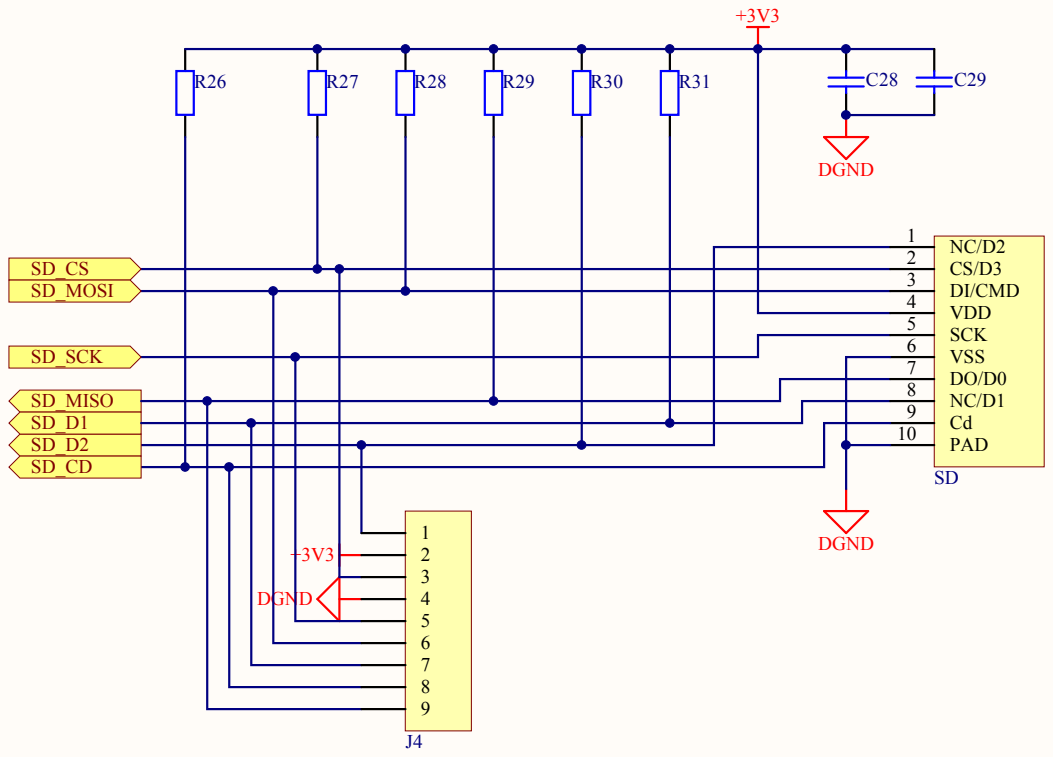
[picture p38: page 5]

CS/D3 2
DI/CMD 3
VDD 4

VSS 6
DO/D0 7
NC/D1 8
Cd 9
PAD 10

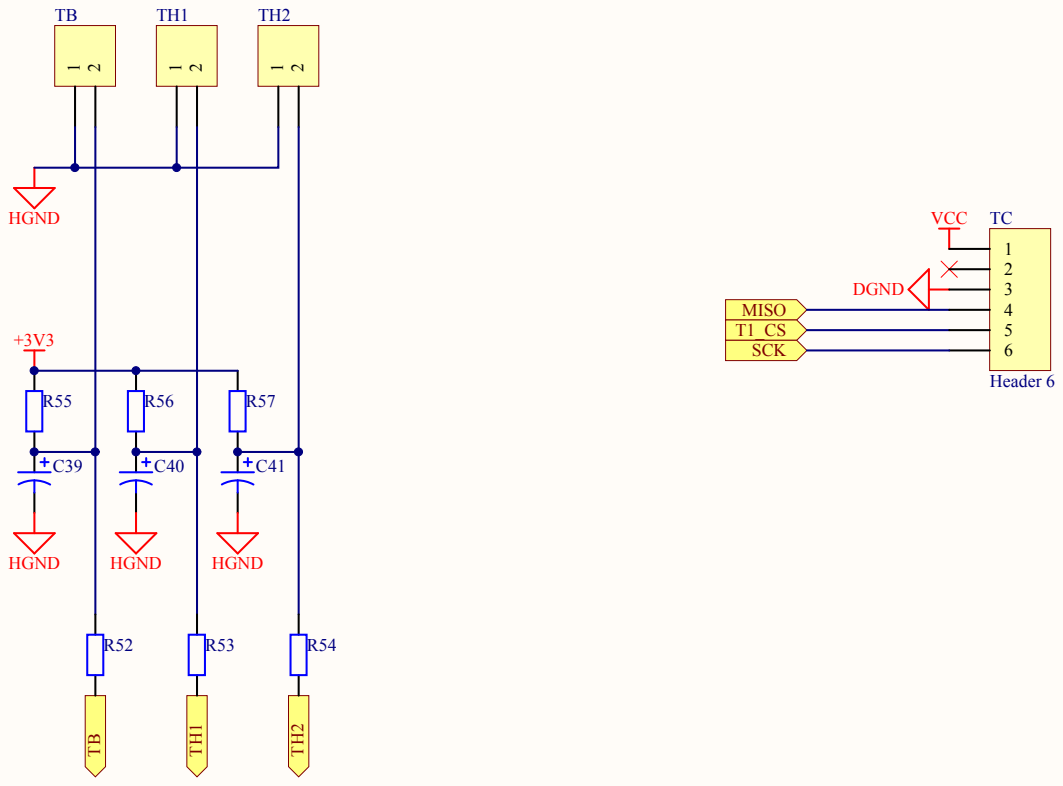
[picture p39: page 6]

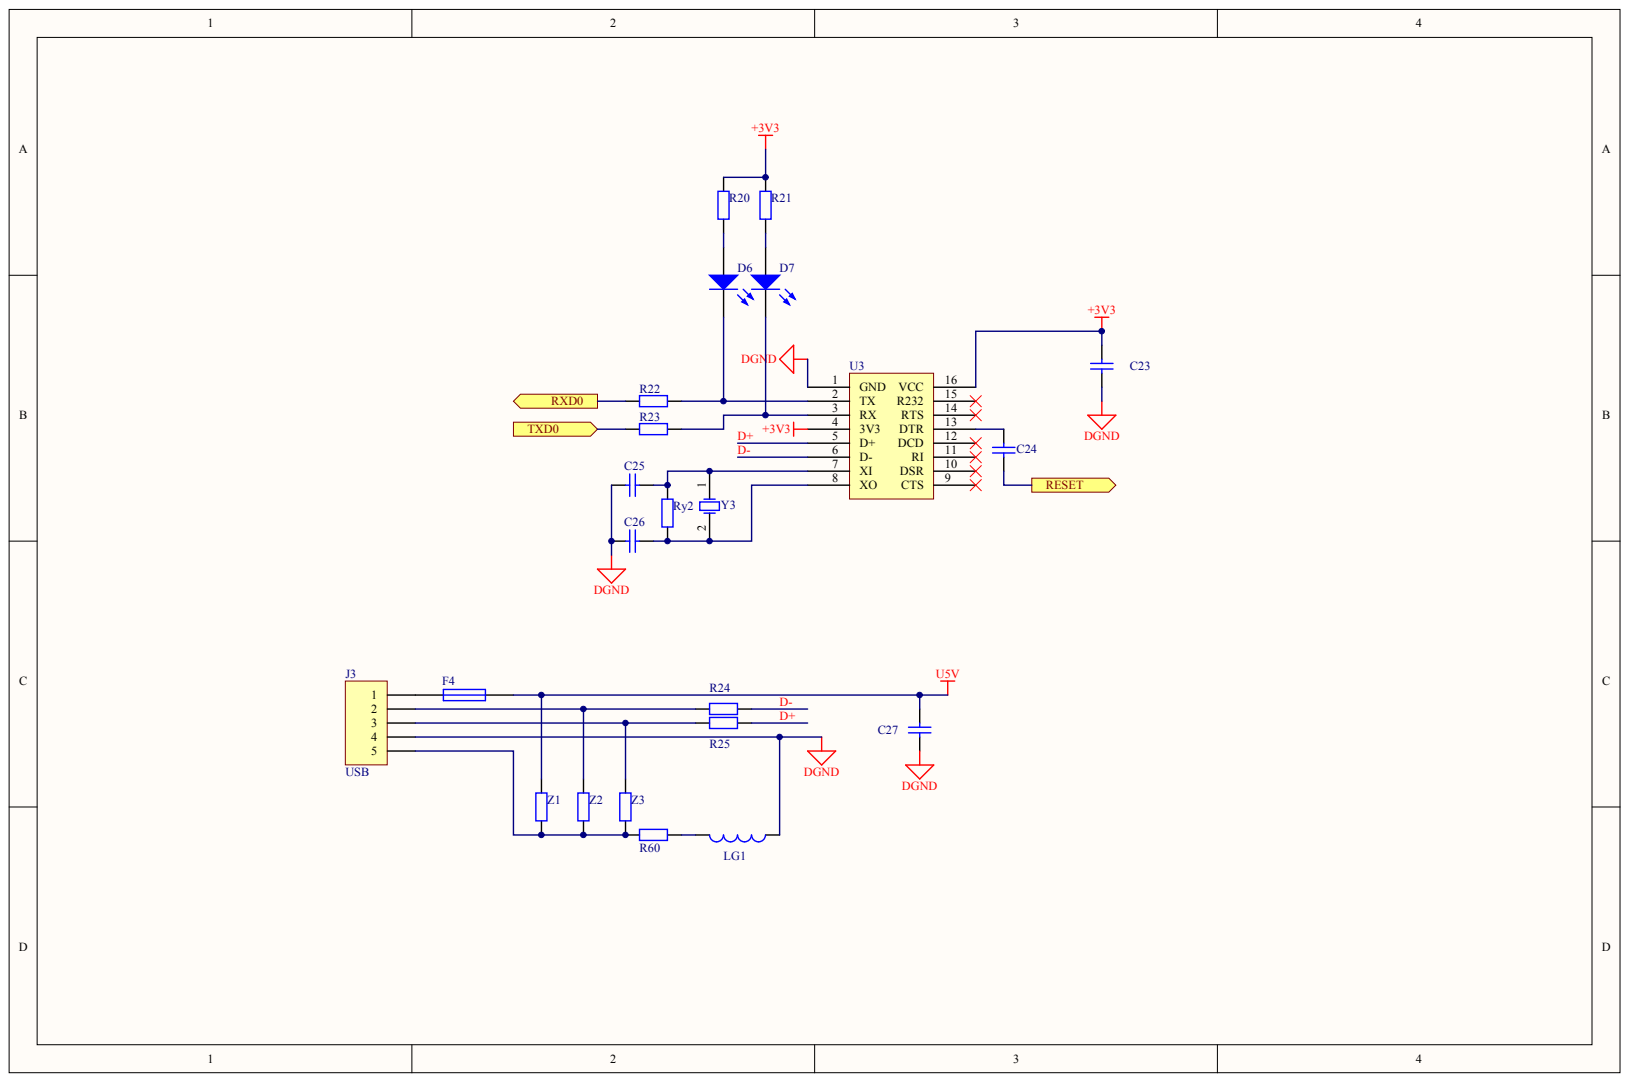
[picture p40: page 7]

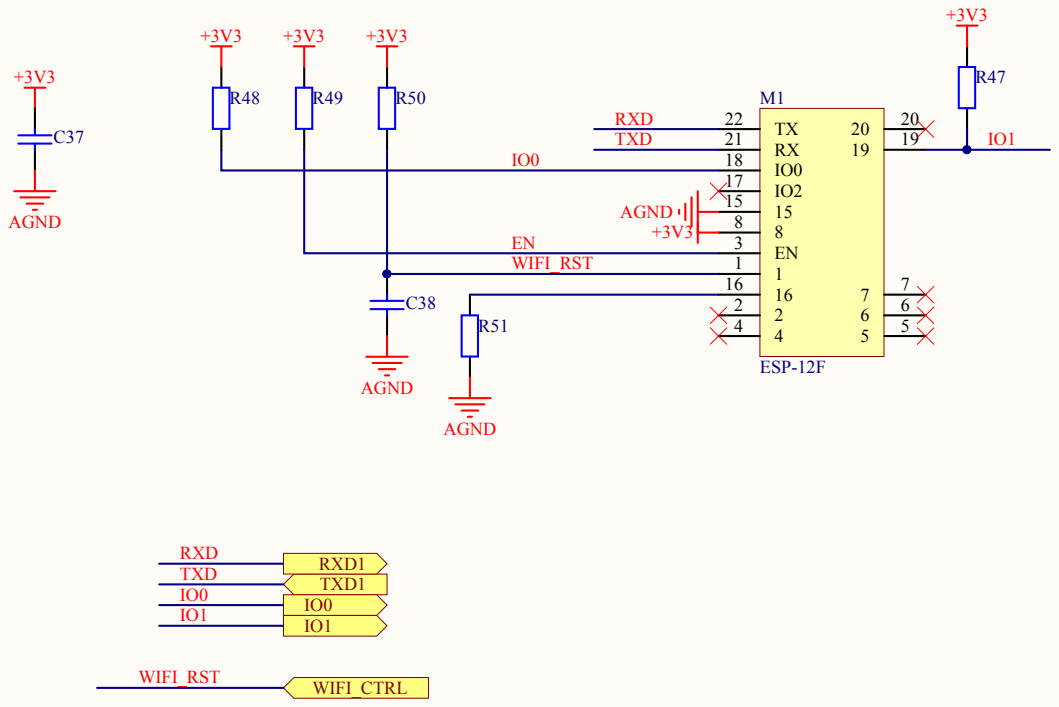
[picture p41: page 8]

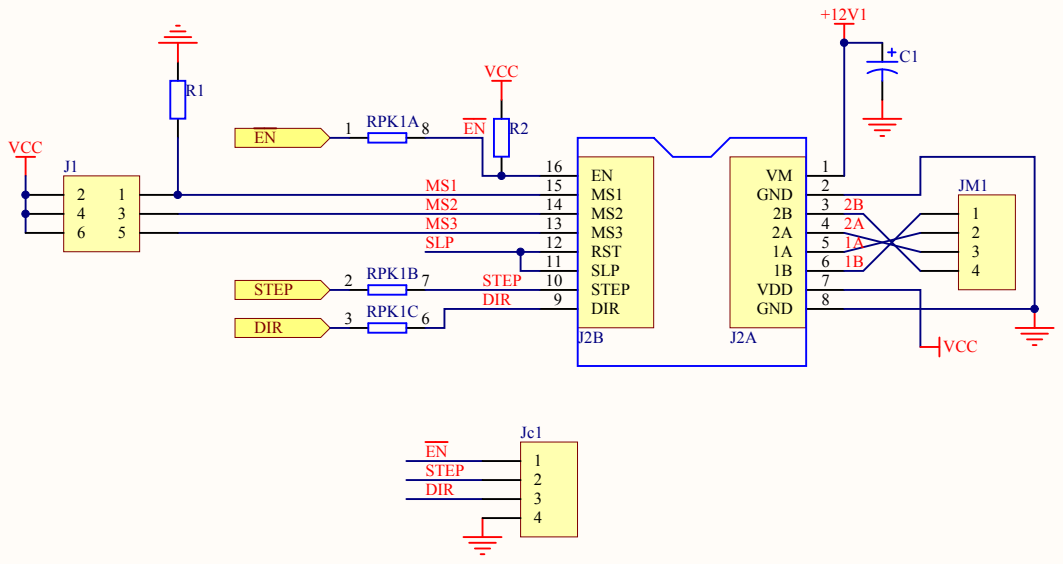
[picture p42: page 9]

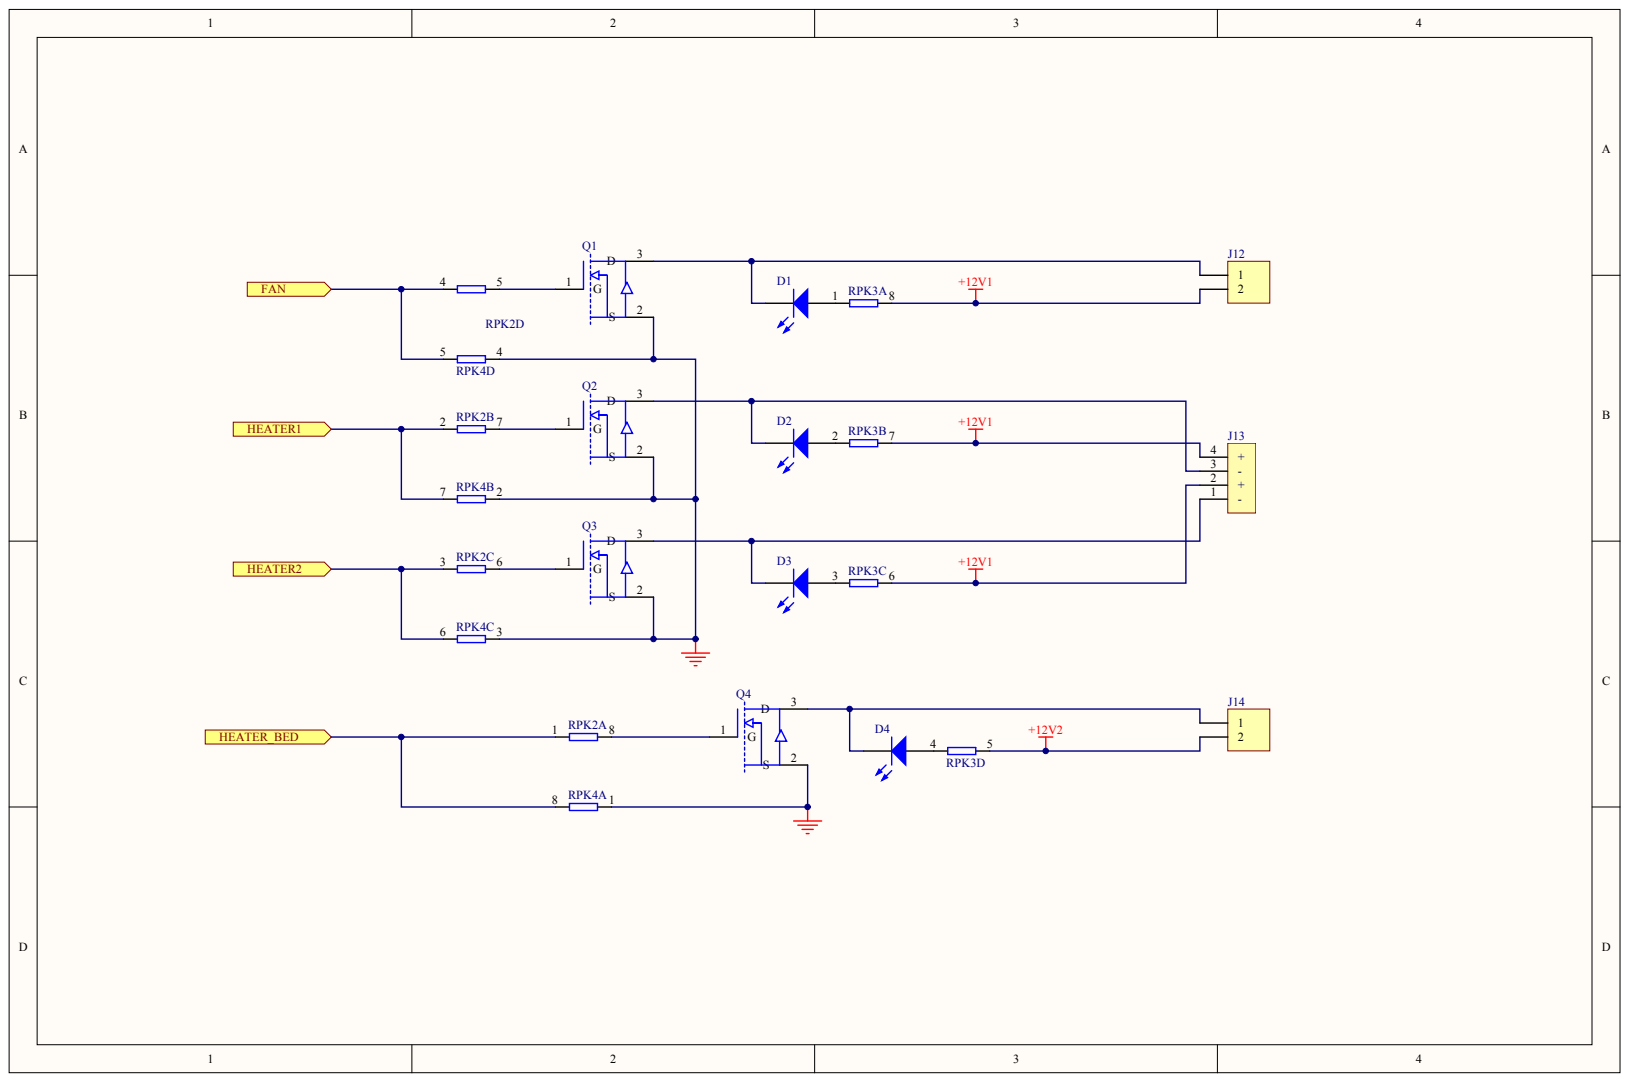
[picture p43: page 10]
