makerbase-mks/MKS-Robin-Nano-V1.X/hardware/MKS Robin Nano V1.2_003/MKS Robin Nano V1.2_003 SCH.pdf

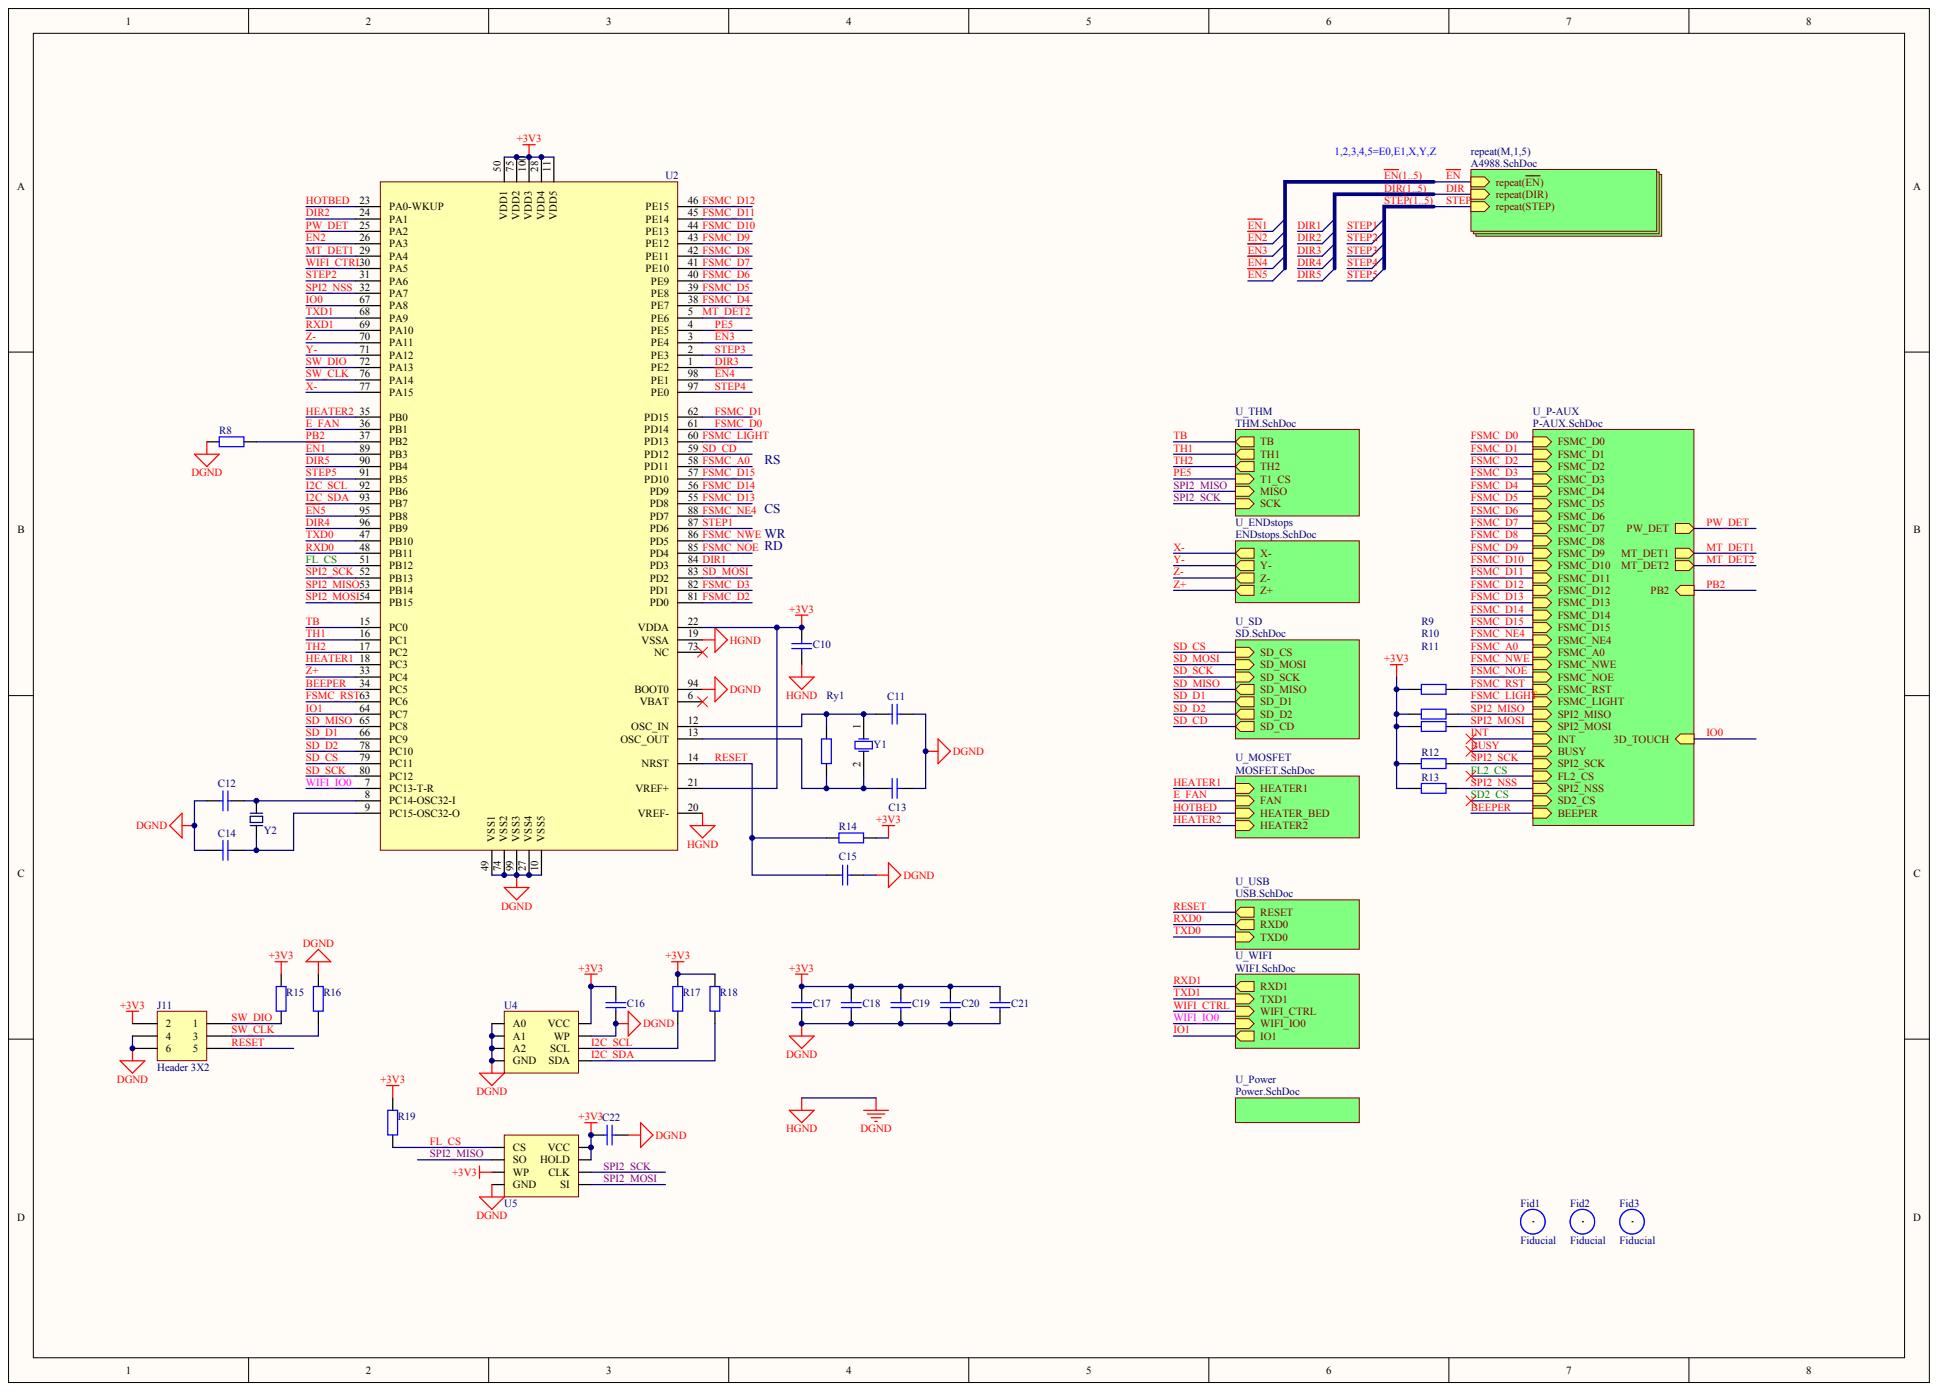
[picture p44: page 1]

DIR(1.. 5 ) | DIR STEP
STEP(1..5)


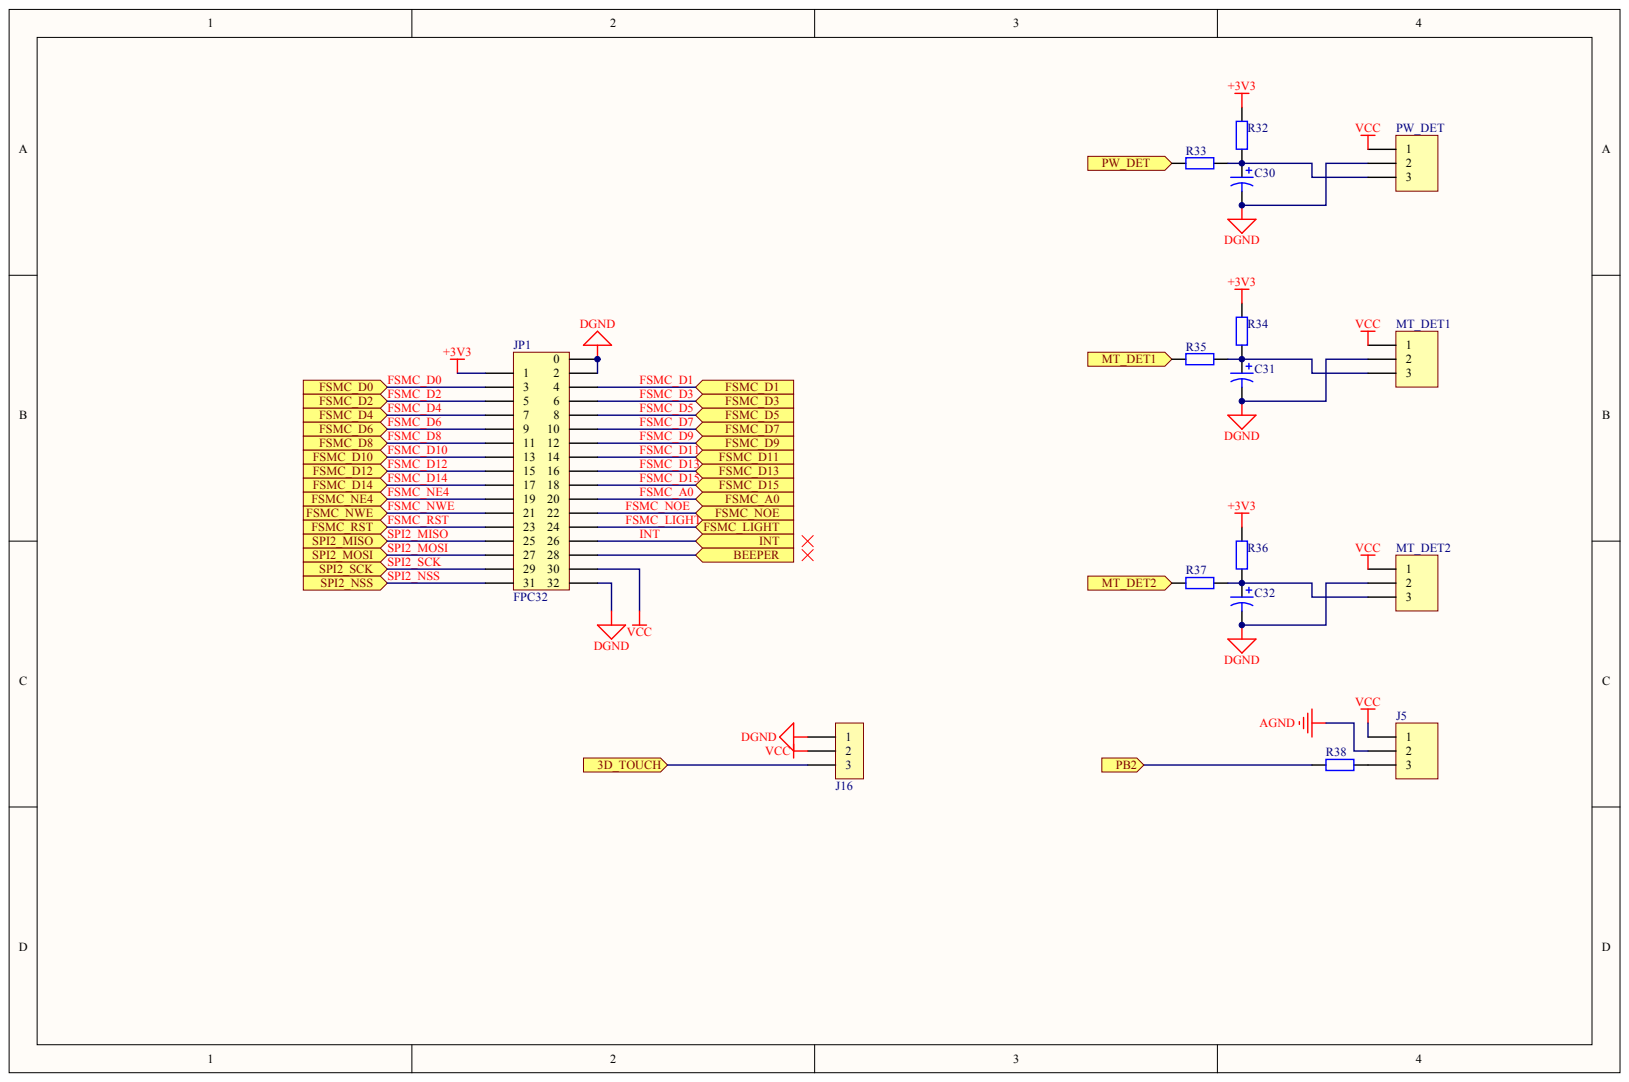
[picture p45: page 3]

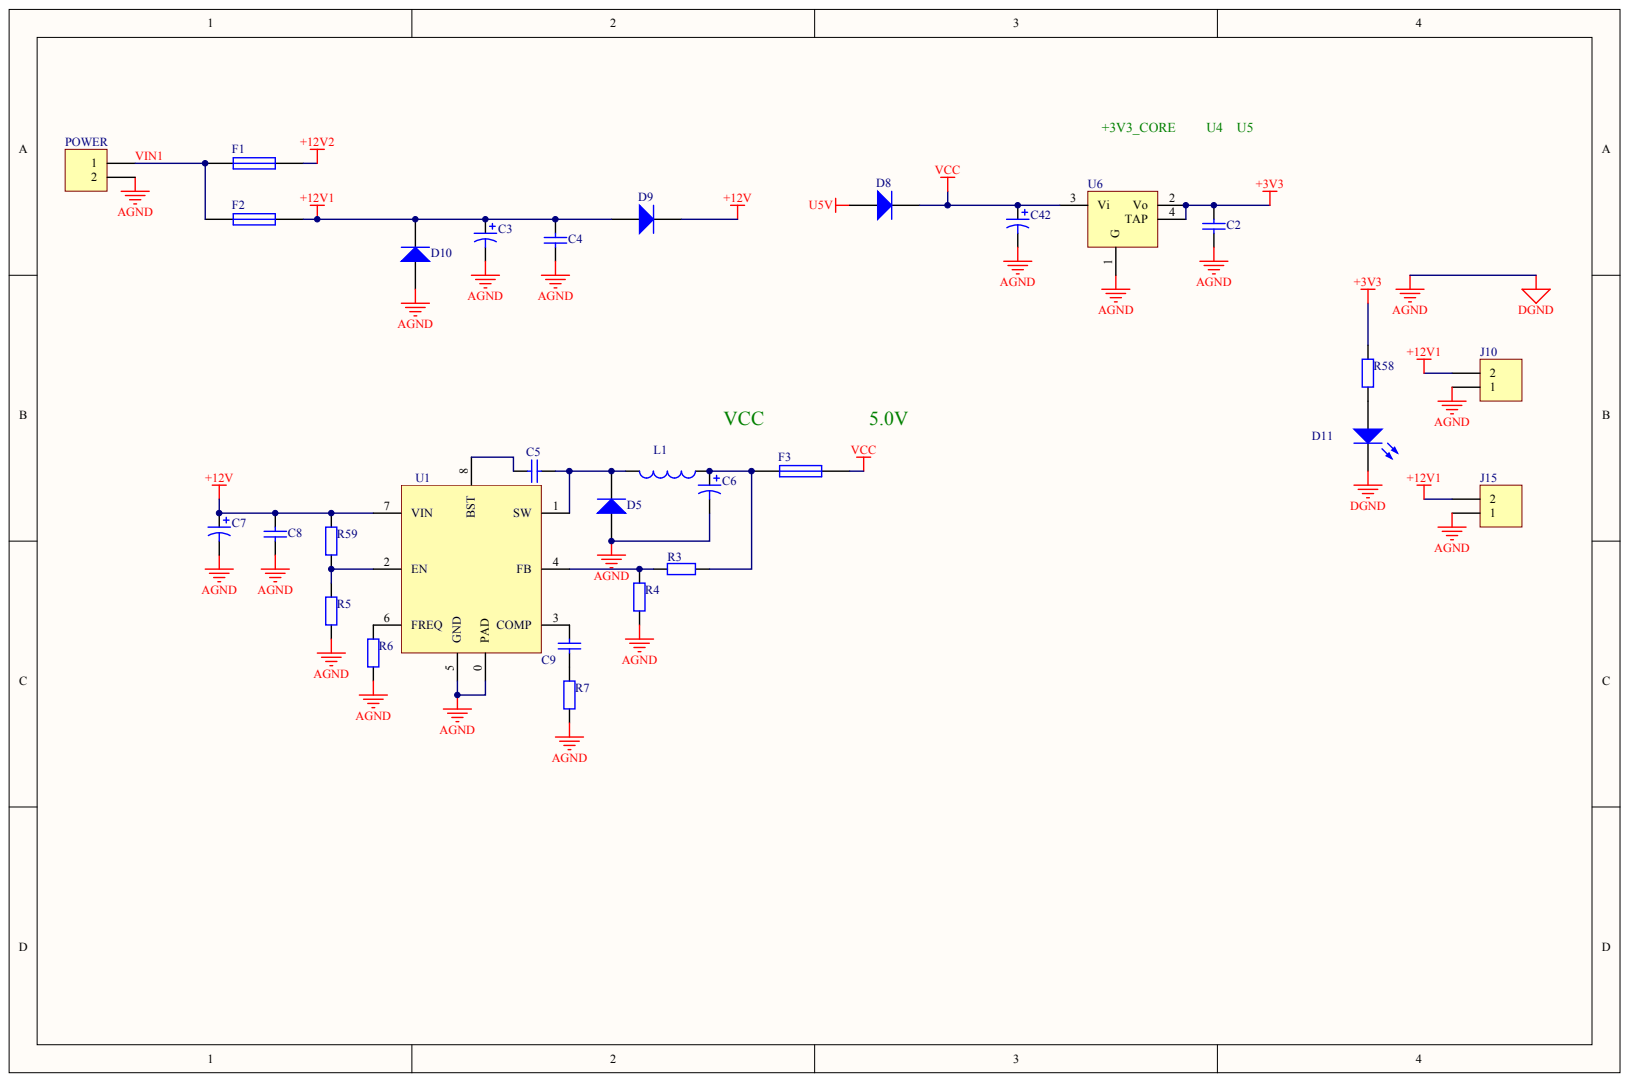
[picture p46: page 4]


CS/D3 2
DI/CMD 3
VDD 4

VSS 6
DO/D0 7
NC/D1 8
Cd 9
PAD 10


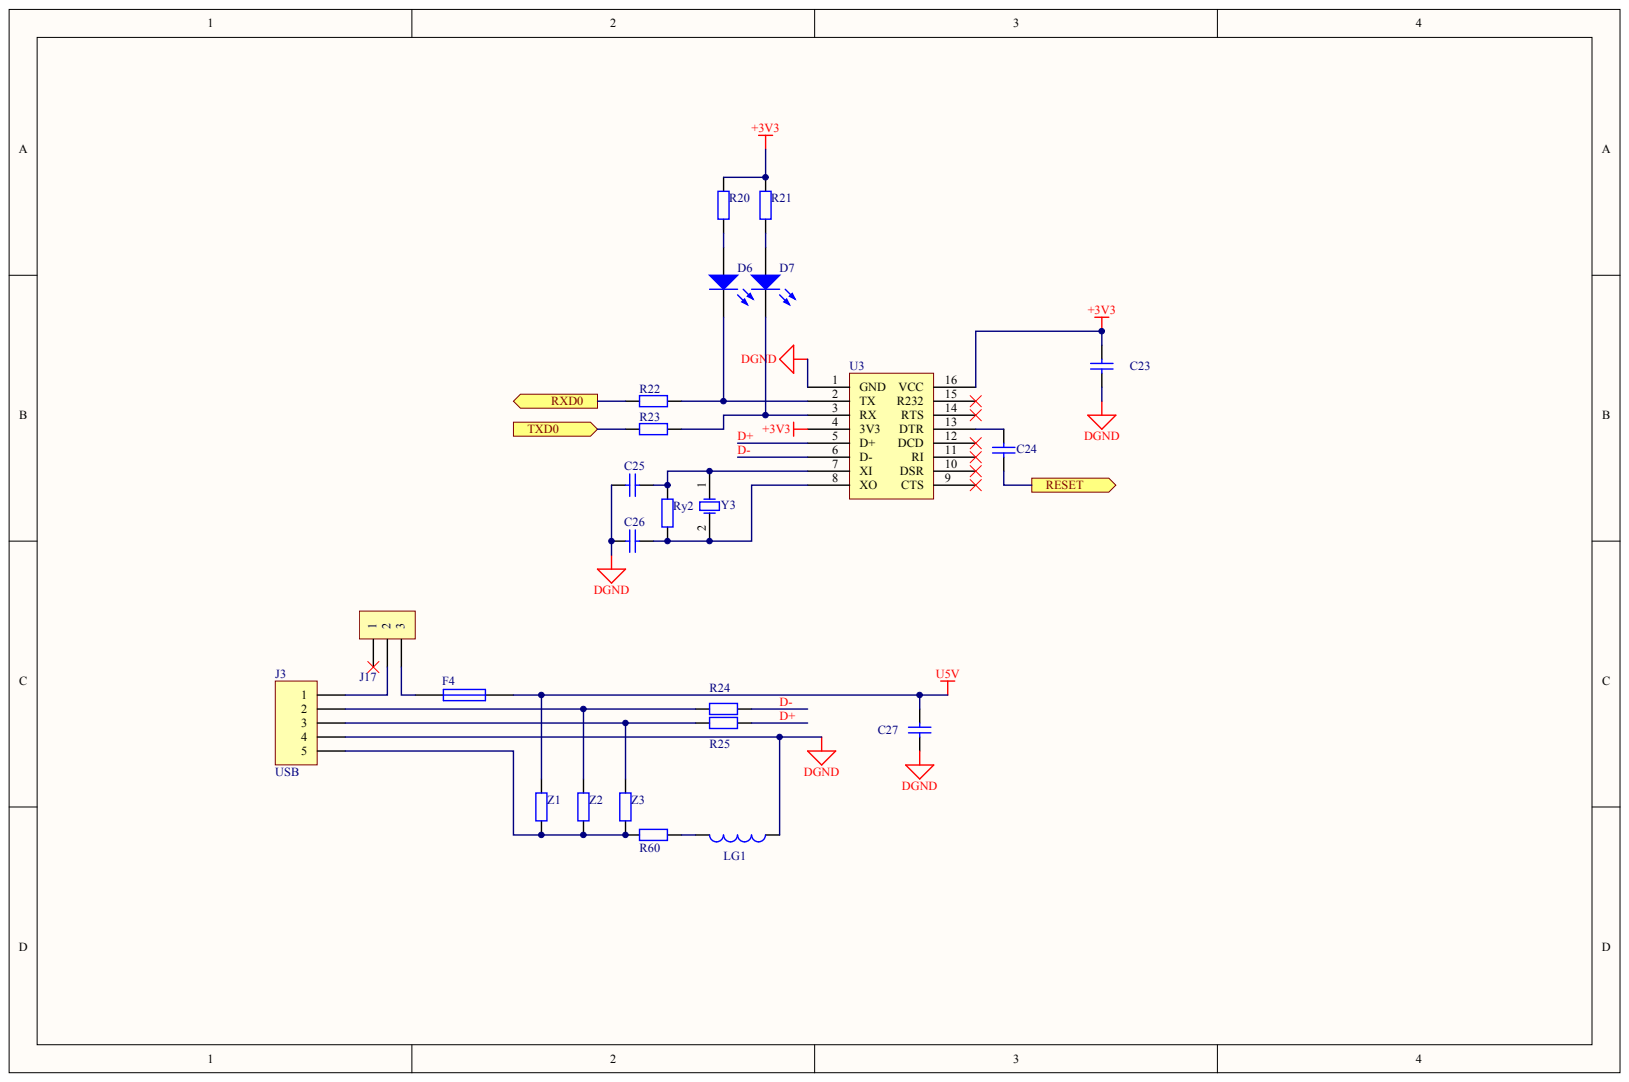
[picture p47: page 7]

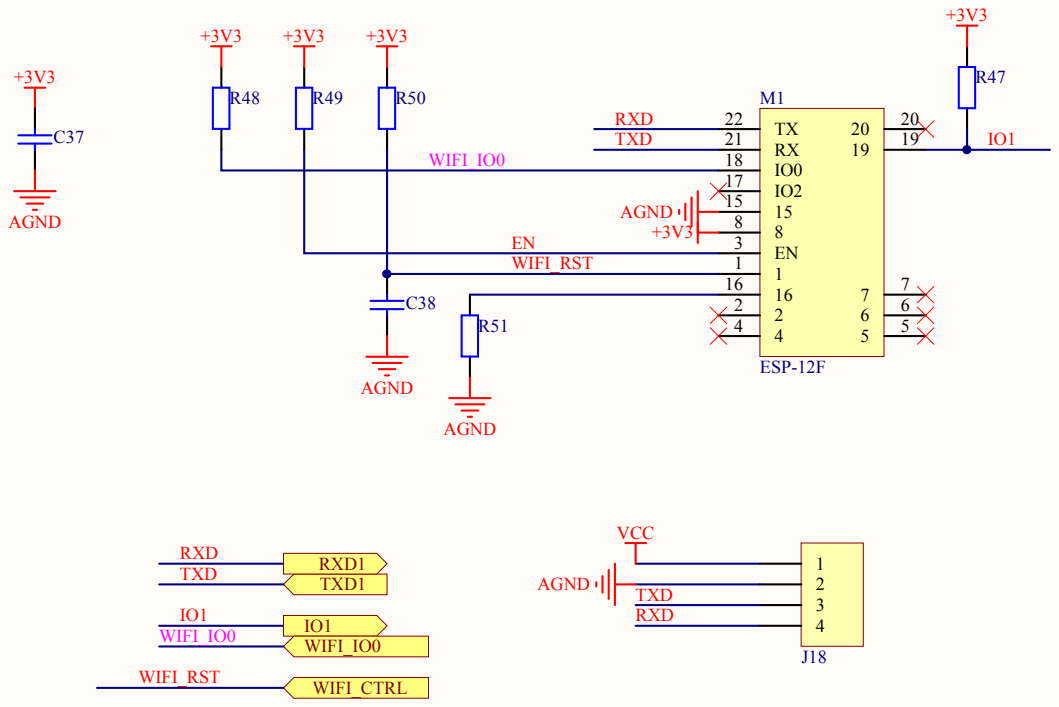
[picture p48: page 8]
