makerbase-mks/MKS-Robin-Nano-V1.X/hardware/MKS Robin Nano V1.2_004/MKS Robin Nano V1.2_004 BOTTOM.pdf

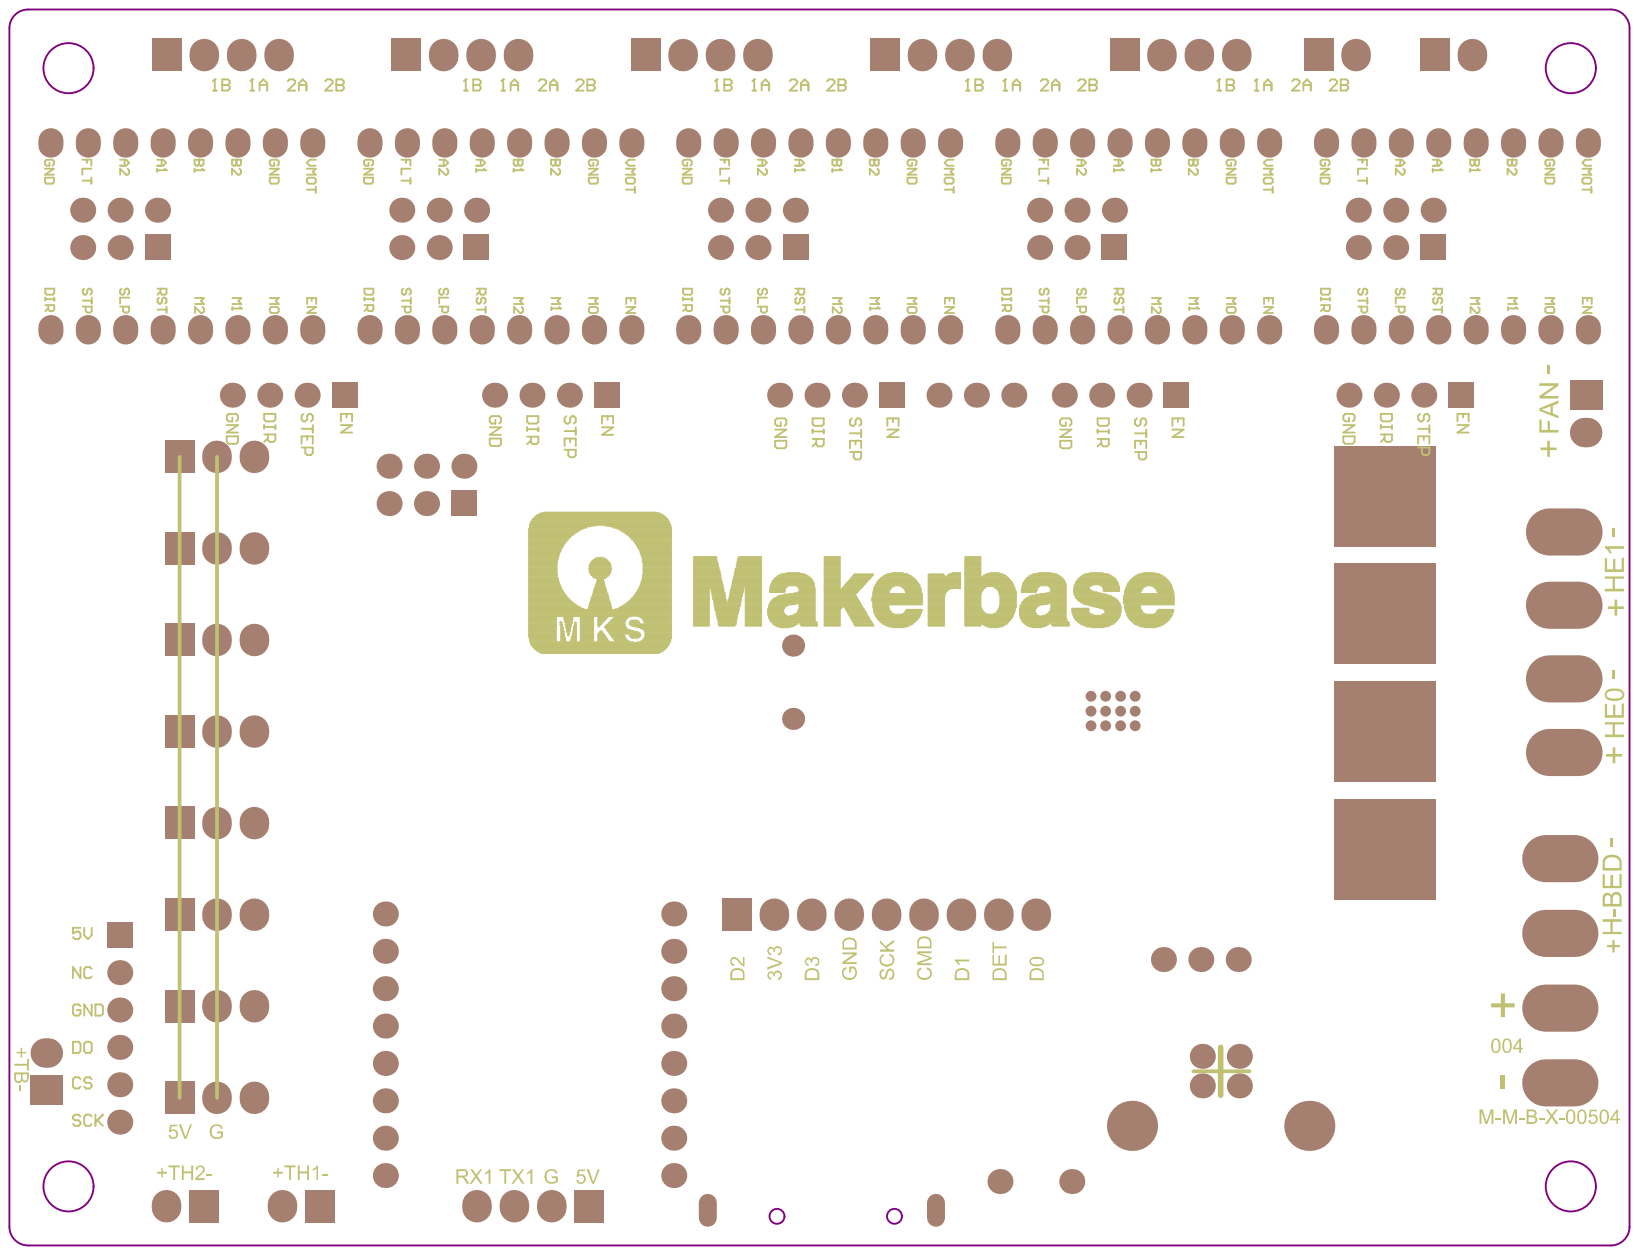
[picture p49: page 1]
