makerbase-mks/MKS-Robin-Nano-V1.X/hardware/MKS Robin Nano V1.2_004/MKS Robin Nano V1.2_004 PIN.pdf

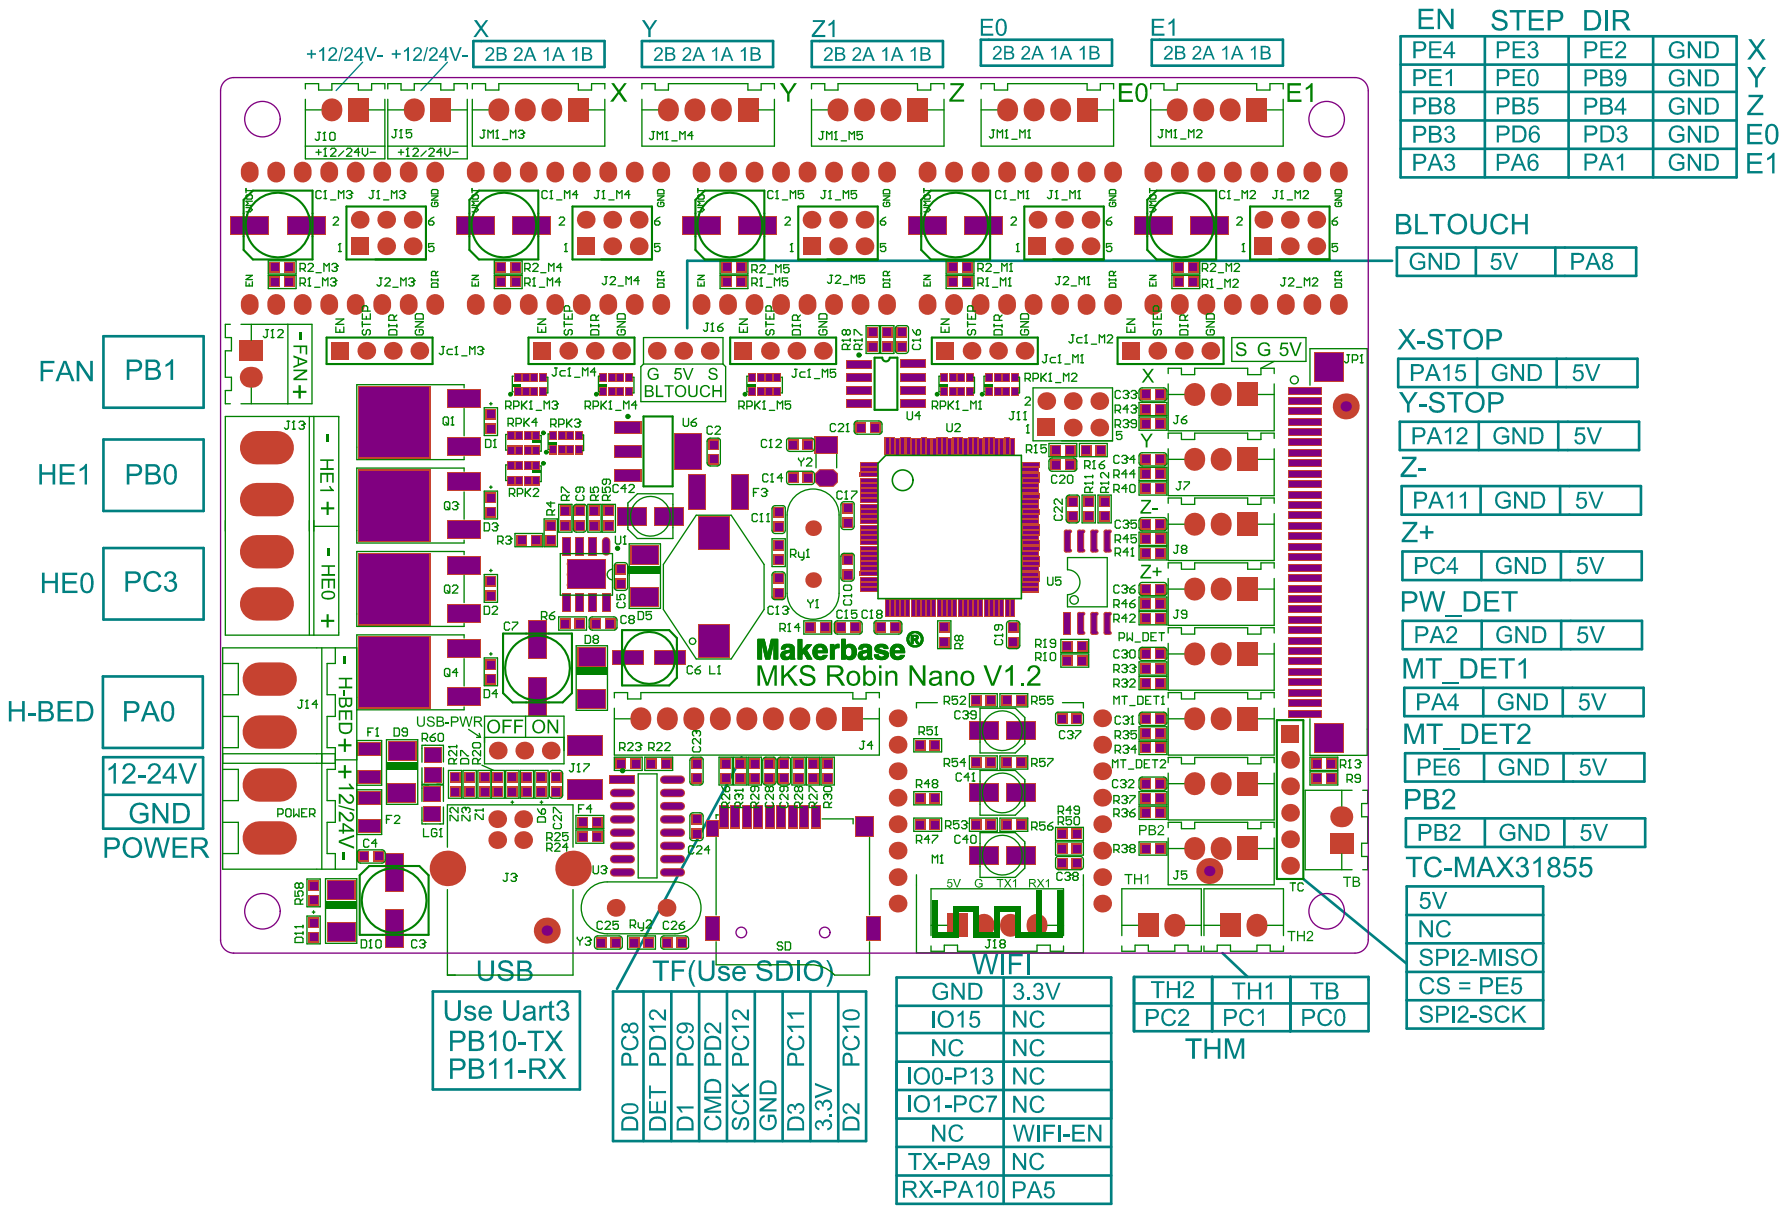
[picture p50: page 1]
