makerbase-mks/MKS-Robin-Nano-V1.X/hardware/MKS Robin Nano V1.2_004/MKS Robin Nano V1.2_004 SIZE.pdf

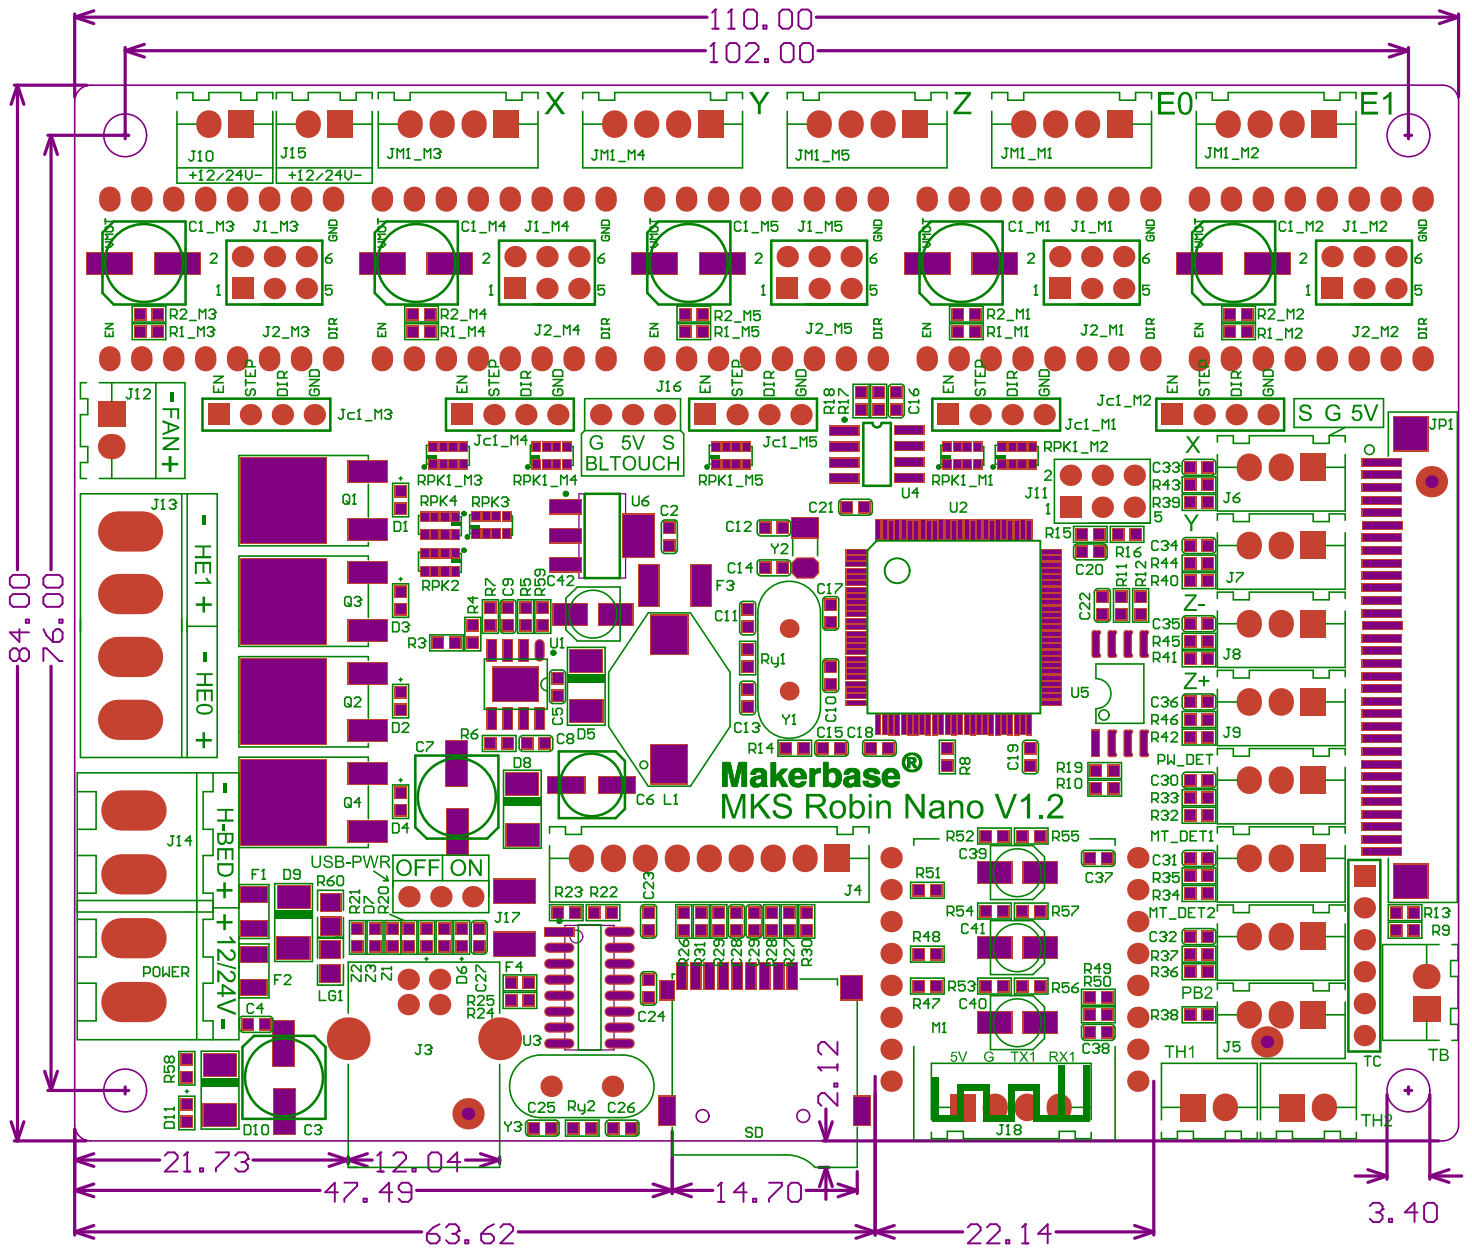
[picture p51: page 1]
