makerbase-mks/MKS-Robin-Nano-V1.X/hardware/MKS Robin Nano V1.1_001/MKS Robin Nano V1.1_001 PIN.pdf

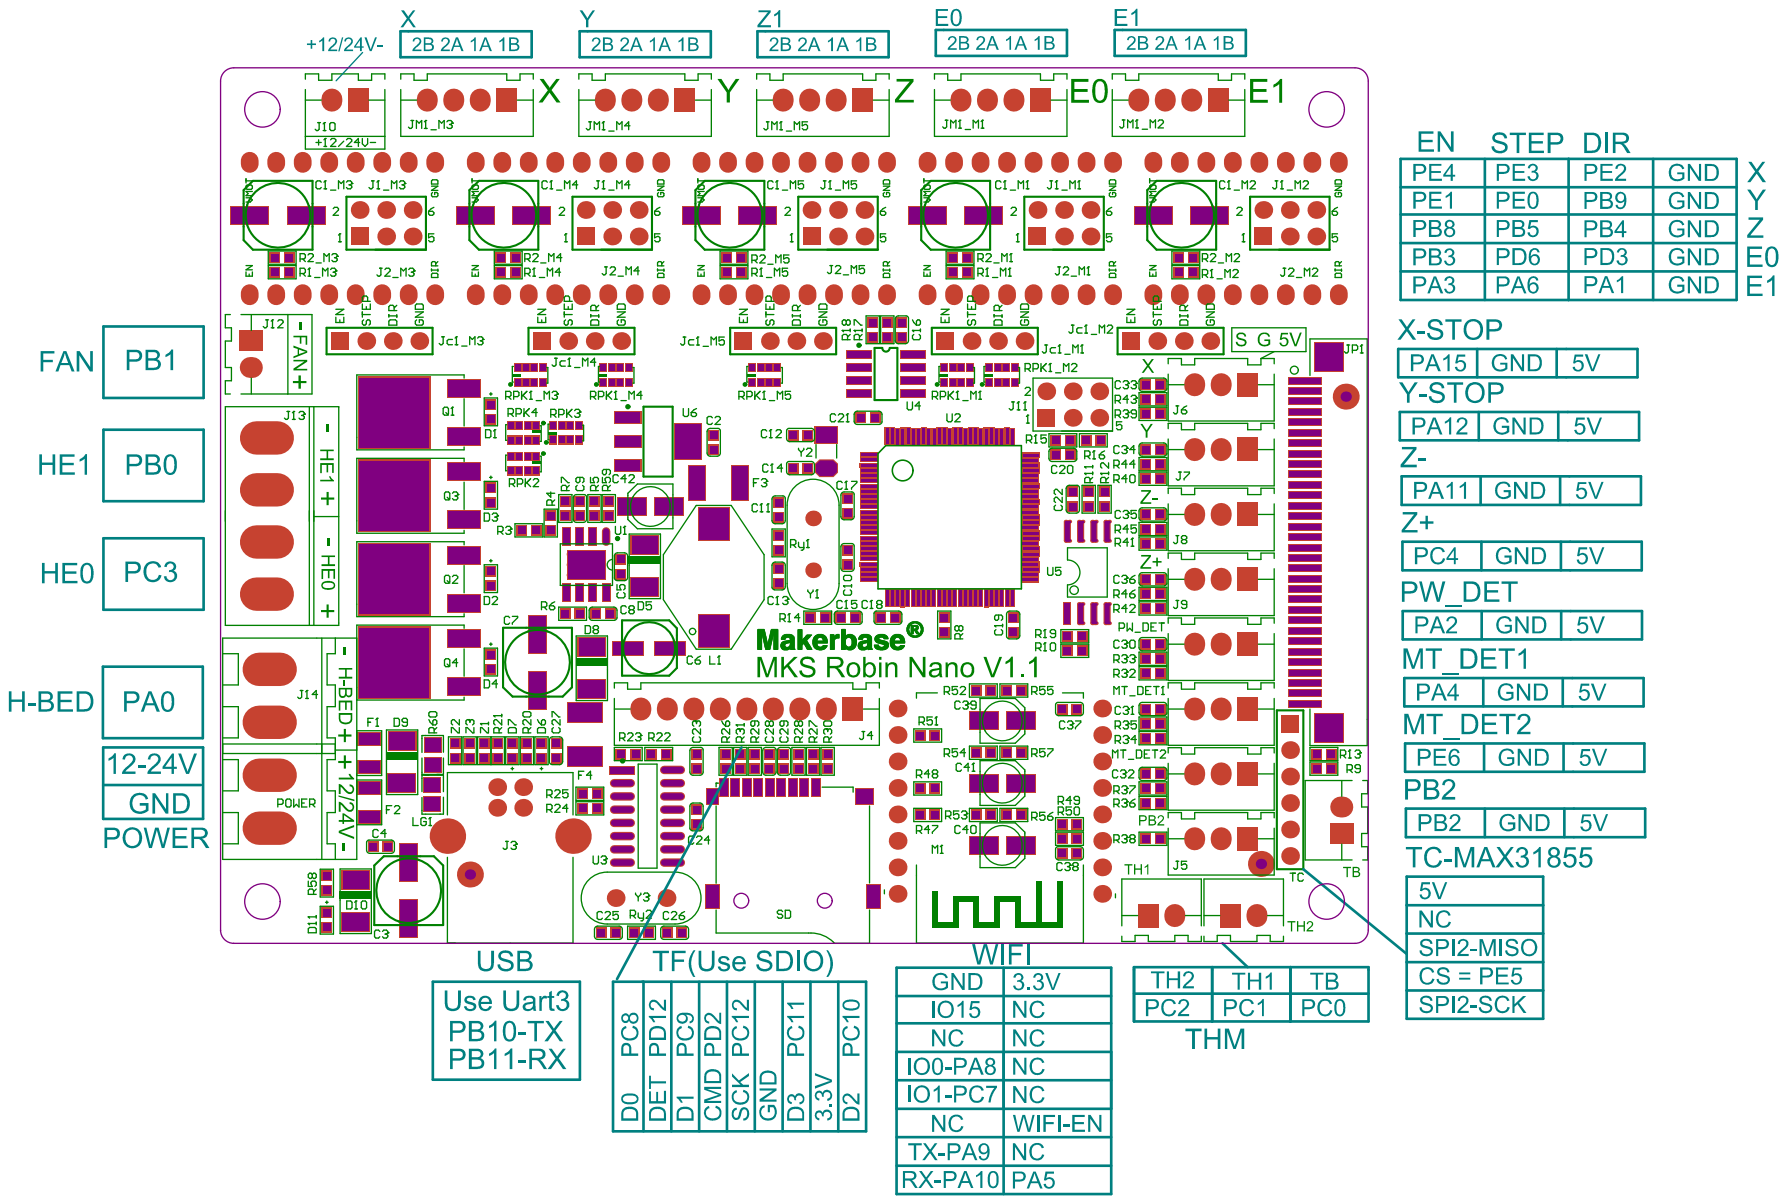
[picture p52: page 1]
