makerbase-mks/MKS-Robin-Nano-V1.X/hardware/MKS Robin Nano V1.2_003/MKS Robin Nano V1.2_003 PIN.pdf

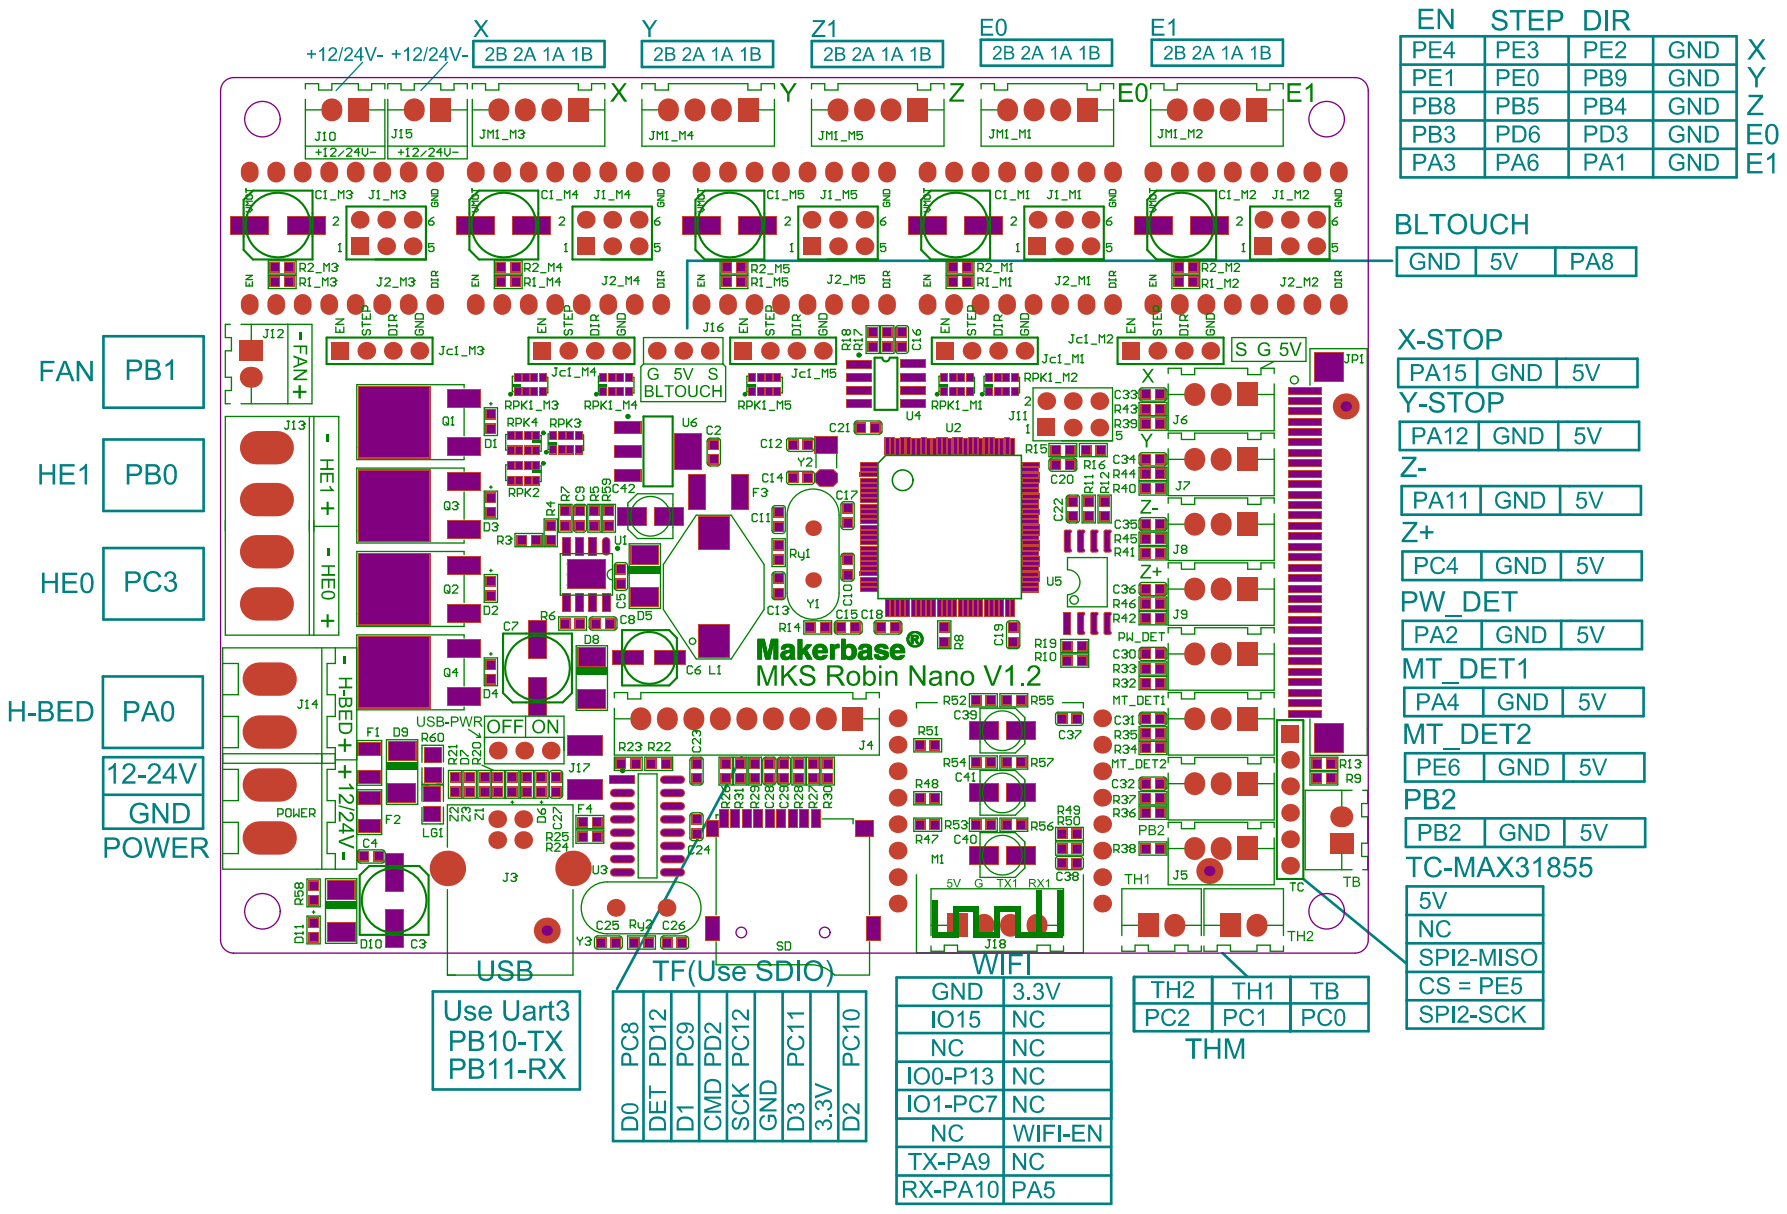
[picture p53: page 1]
