makerbase-mks/MKS-Robin-Nano-V1.X/hardware/MKS Robin Nano V1.1_001/MKS Robin Nano V1.1_001 BOTTOM.pdf

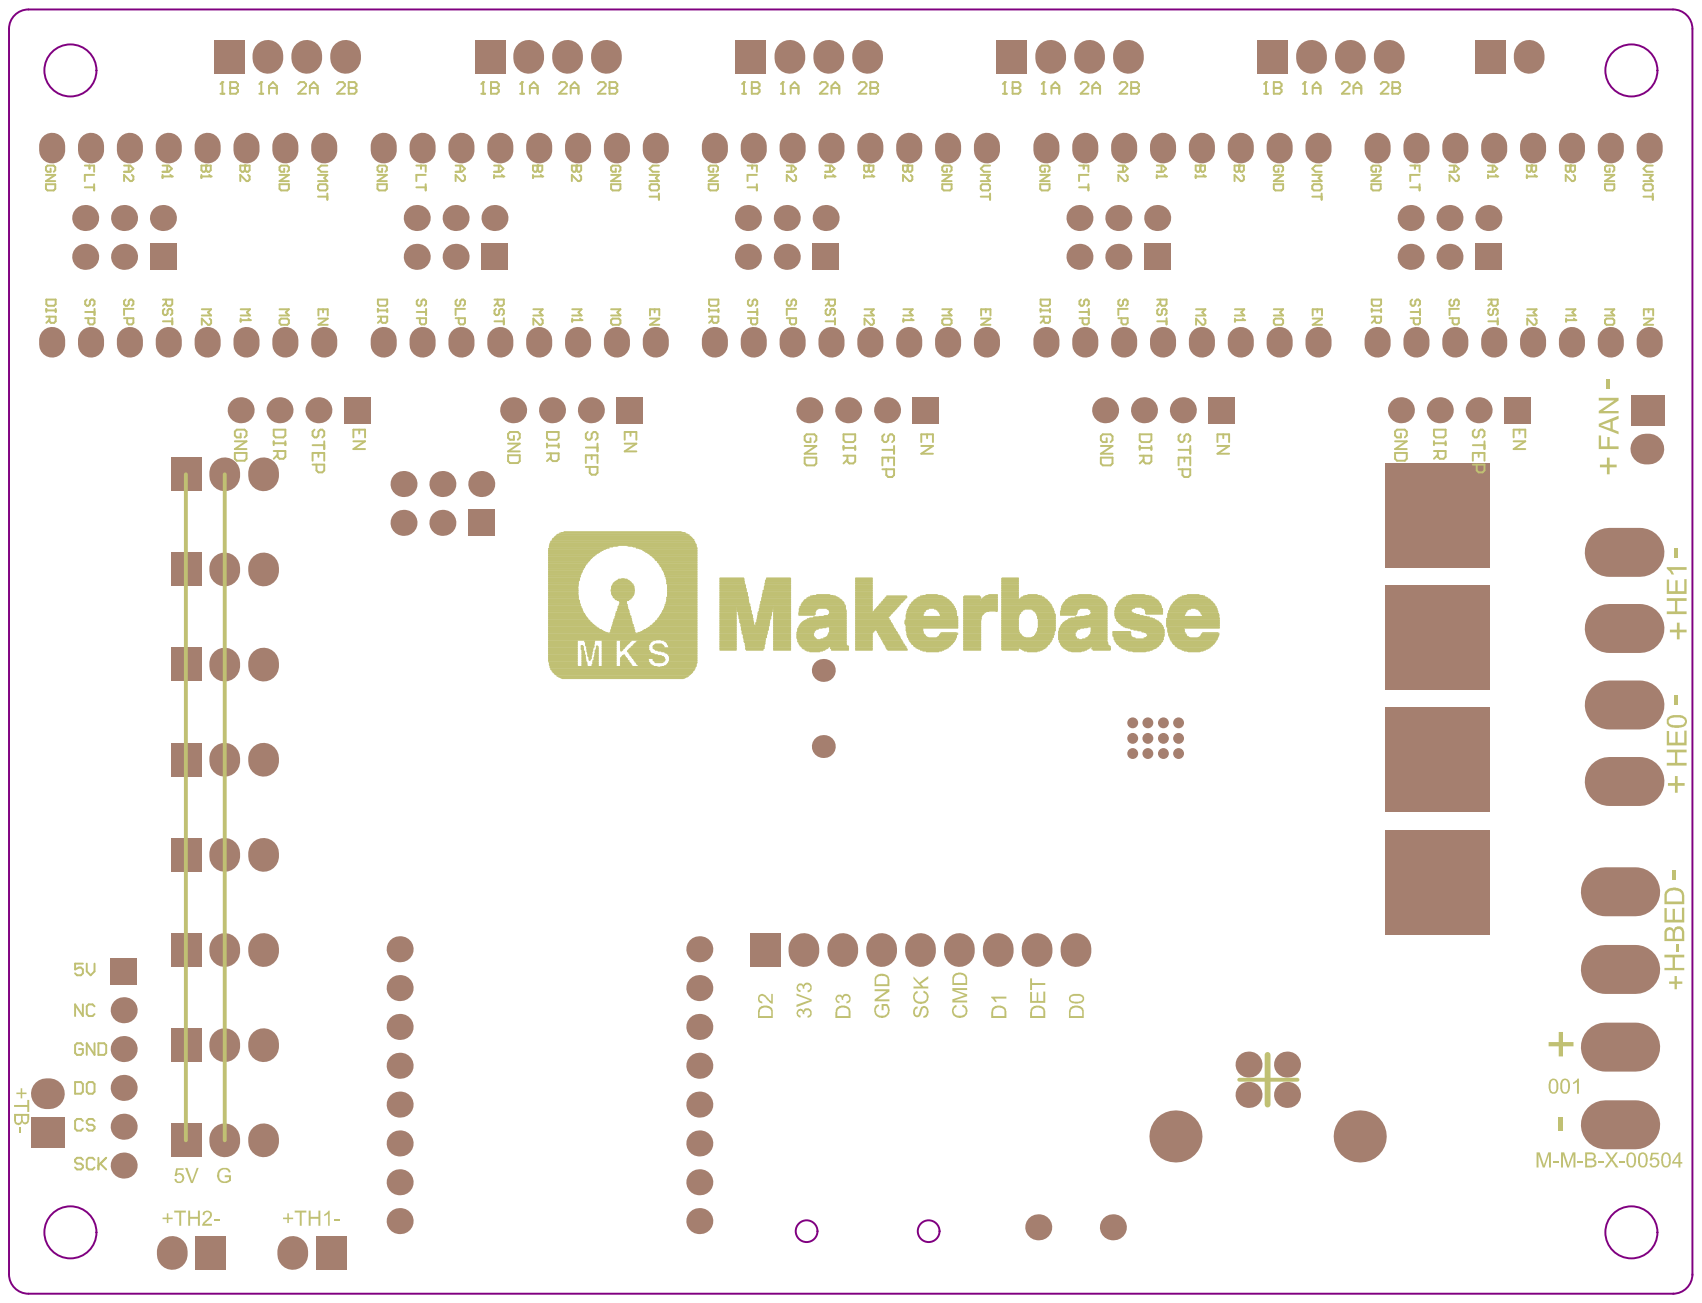
[picture p54: page 1]
