makerbase-mks/MKS-Robin-Nano-V1.X/hardware/MKS Robin Nano V1.1_001/MKS Robin Nano V1.1_001 SIZE.pdf

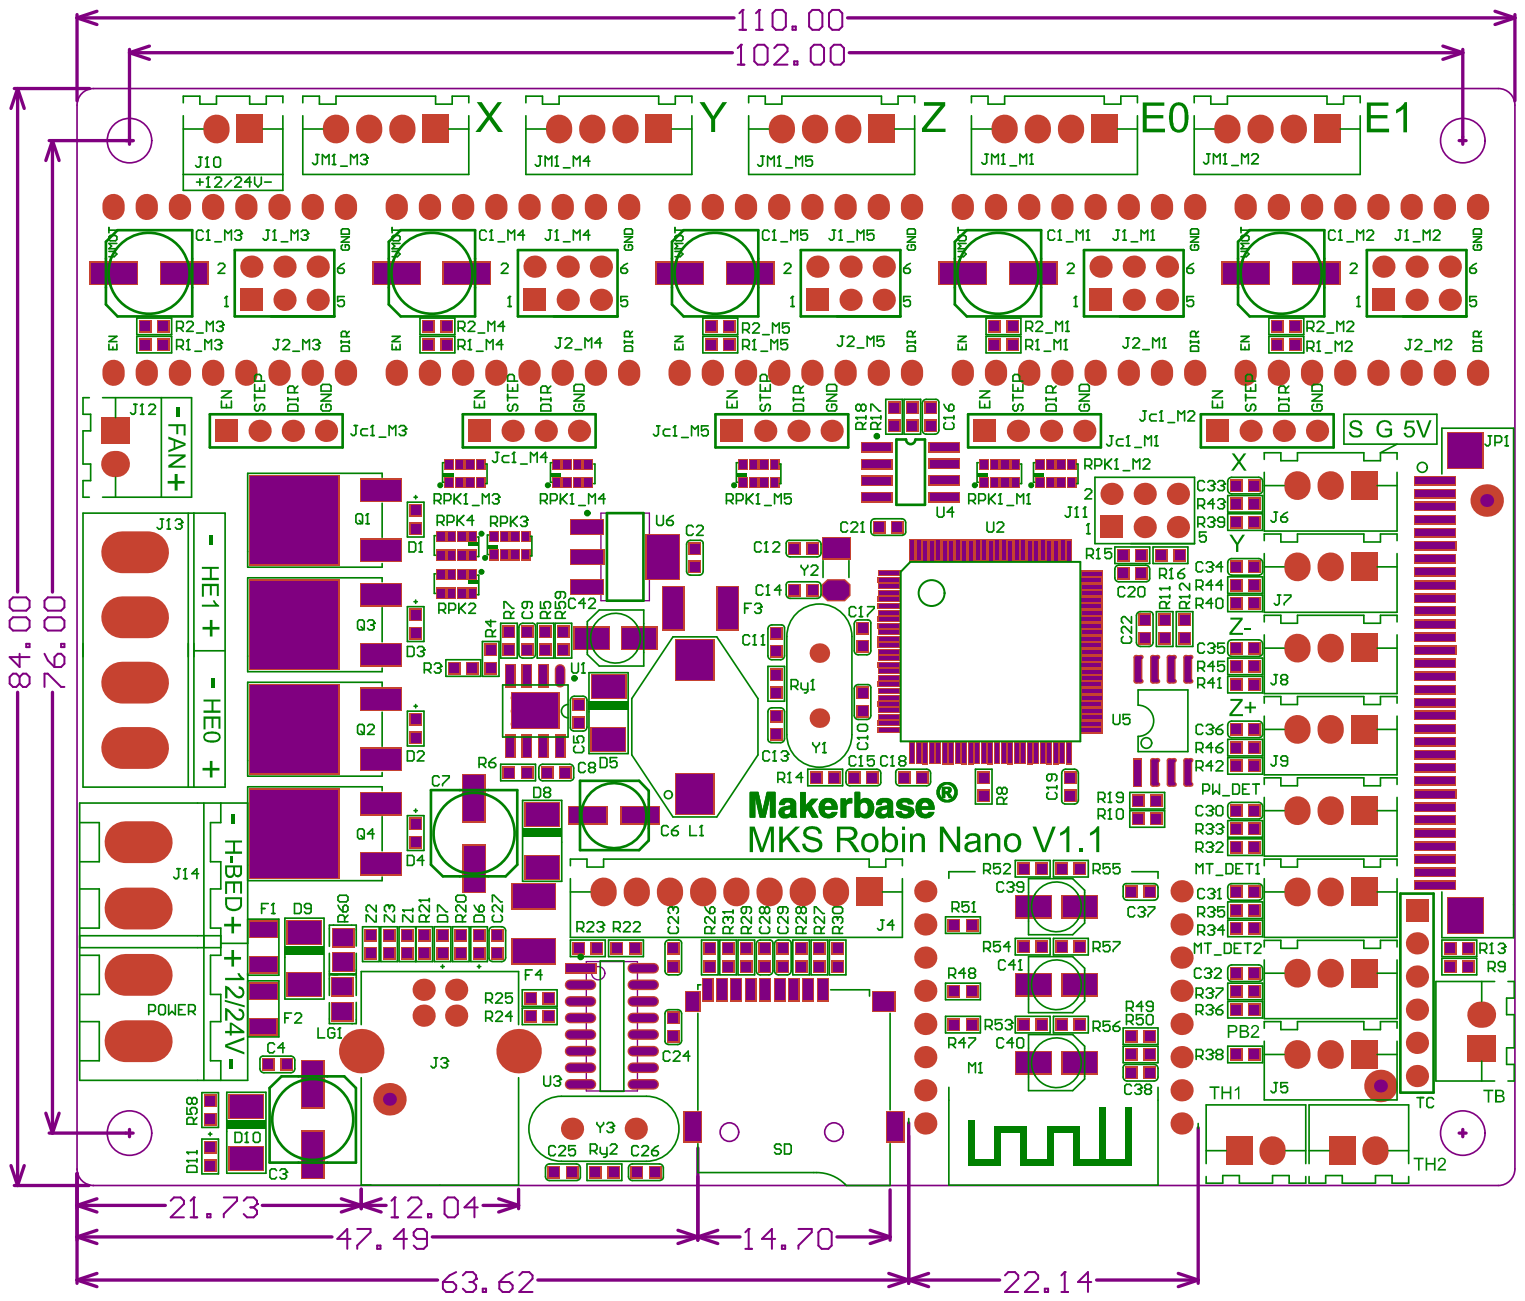
[picture p55: page 1]
