makerbase-mks/MKS-Robin-Nano-V1.X/hardware/MKS Robin Nano V1.1_001/MKS Robin Nano V1.1_001 TOP.pdf

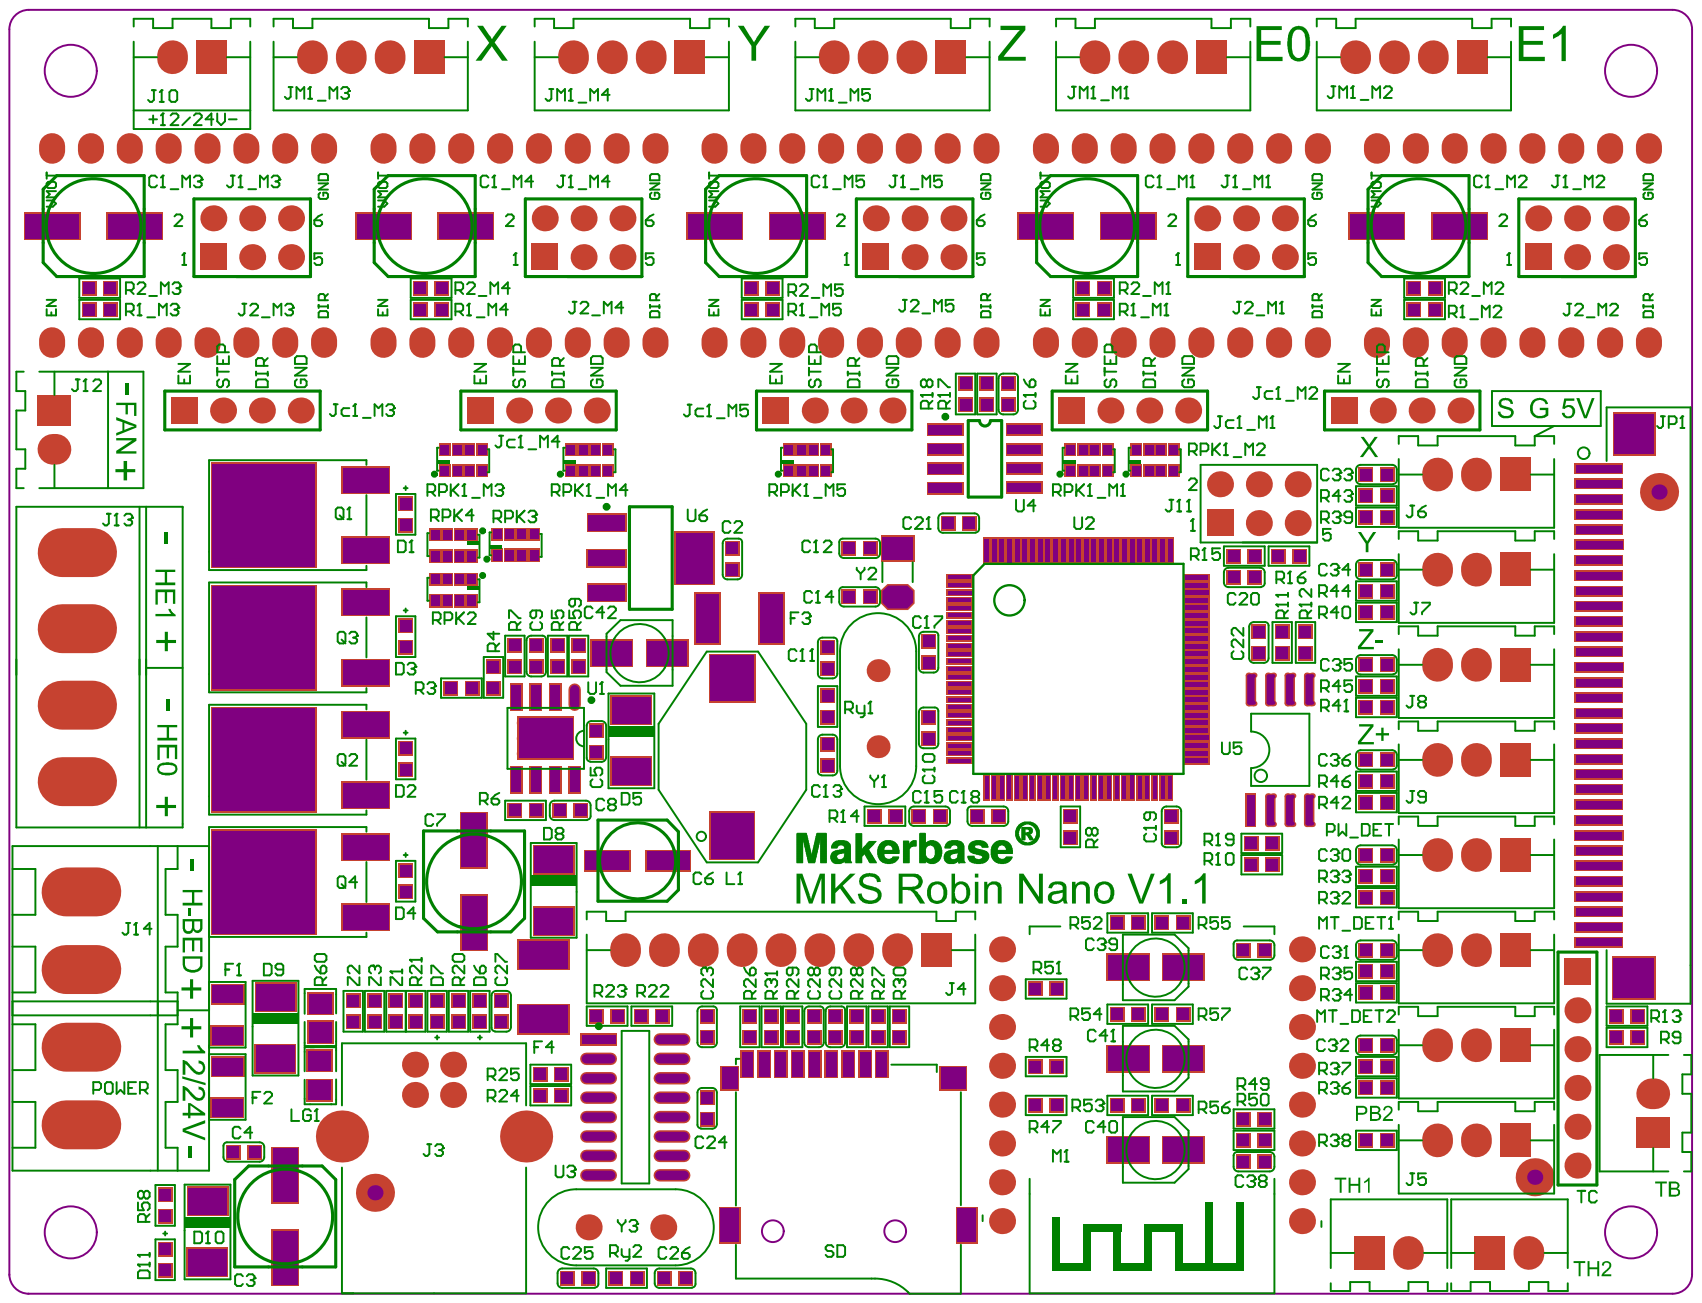
[picture p56: page 1]
