makerbase-mks/MKS-Robin-Nano-V1.X/hardware/MKS Robin Nano V1.2_003/MKS Robin Nano V1.2_003 BOTTOM.pdf

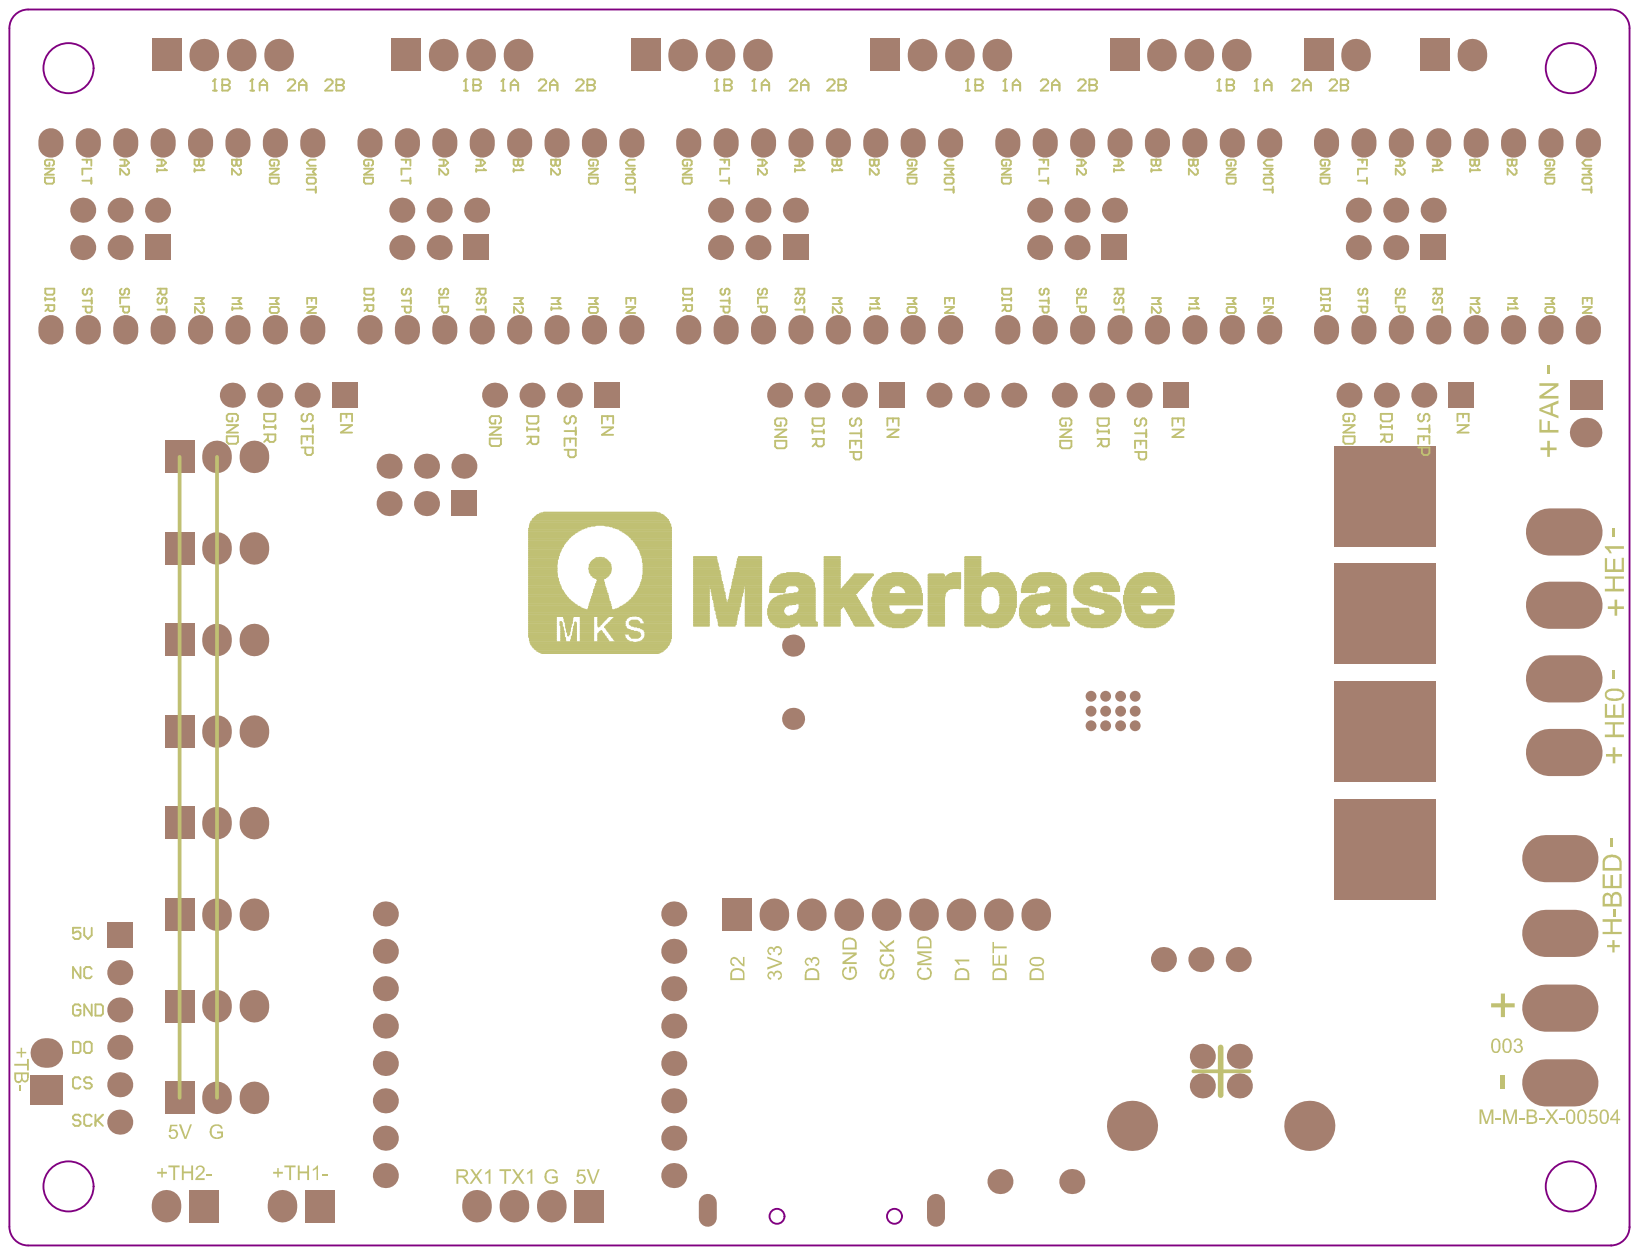
[picture p57: page 1]
