makerbase-mks/MKS-Robin-Nano-V1.X/hardware/MKS Robin Nano V1.2_003/MKS Robin Nano V1.2_003 SIZE.pdf

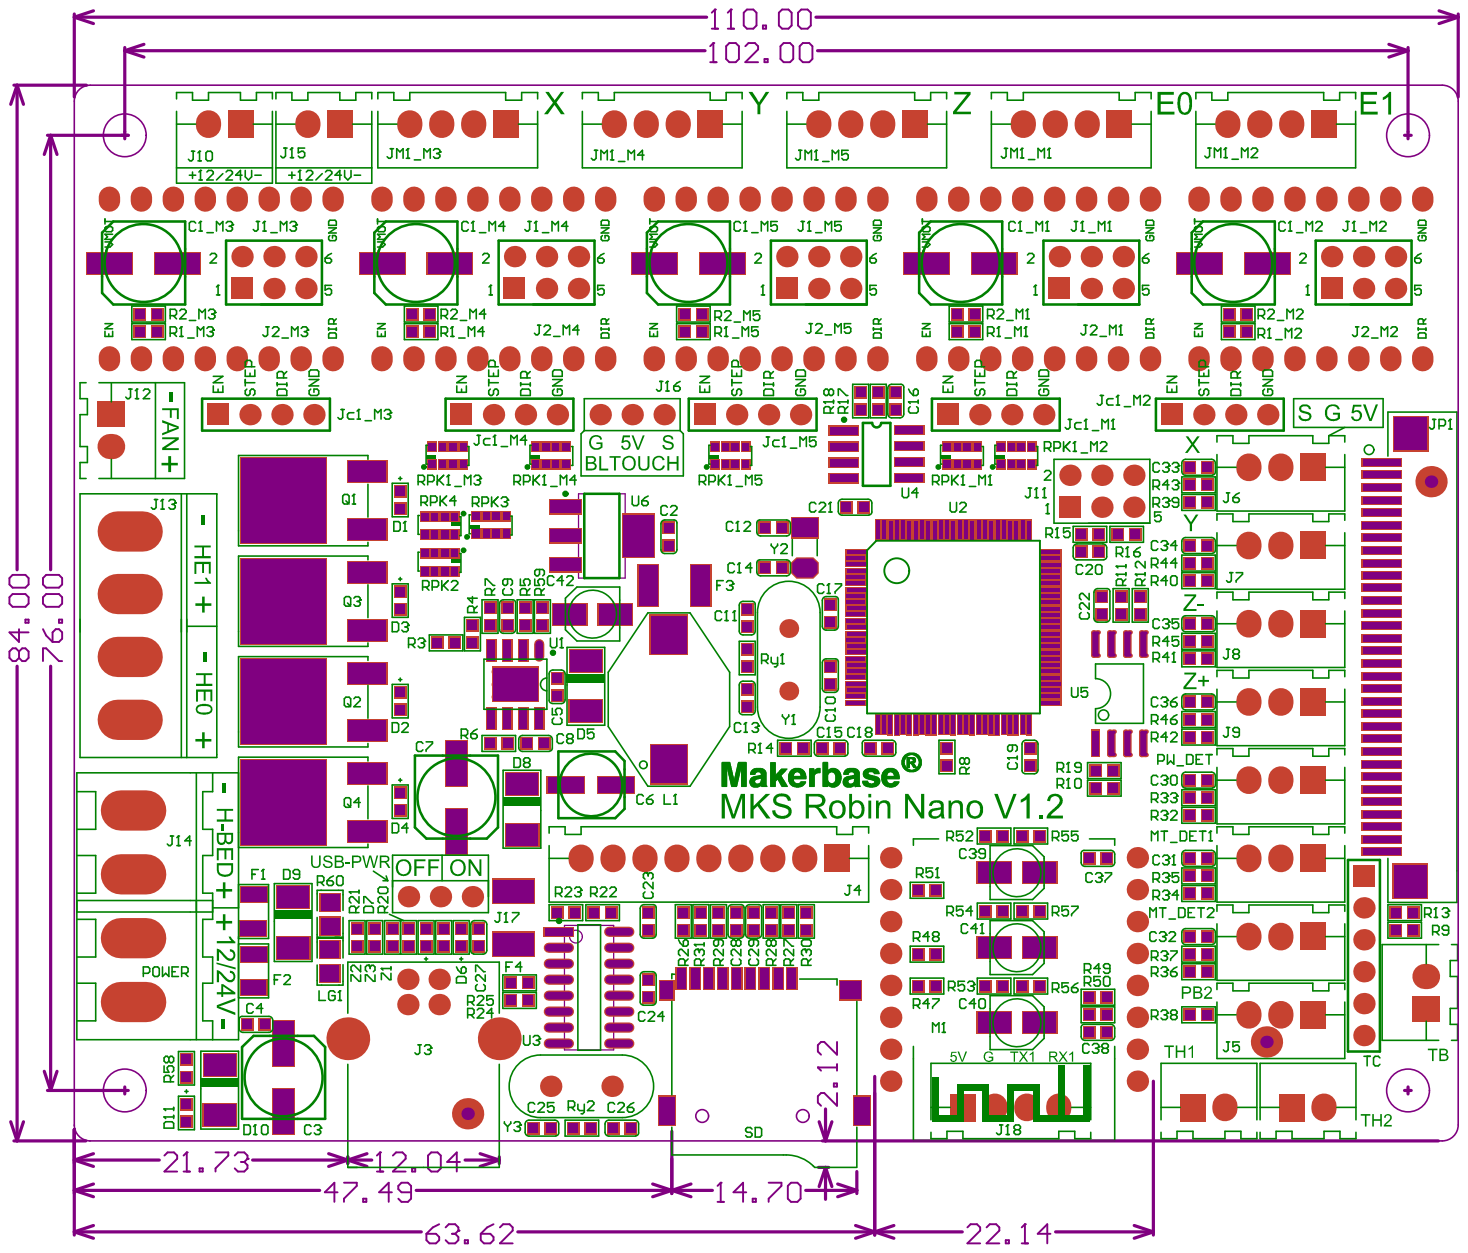
[picture p58: page 1]
