makerbase-mks/MKS-Robin-Nano-V1.X/hardware/MKS Robin Nano V1.2_003/MKS Robin Nano V1.2_003 TOP.pdf

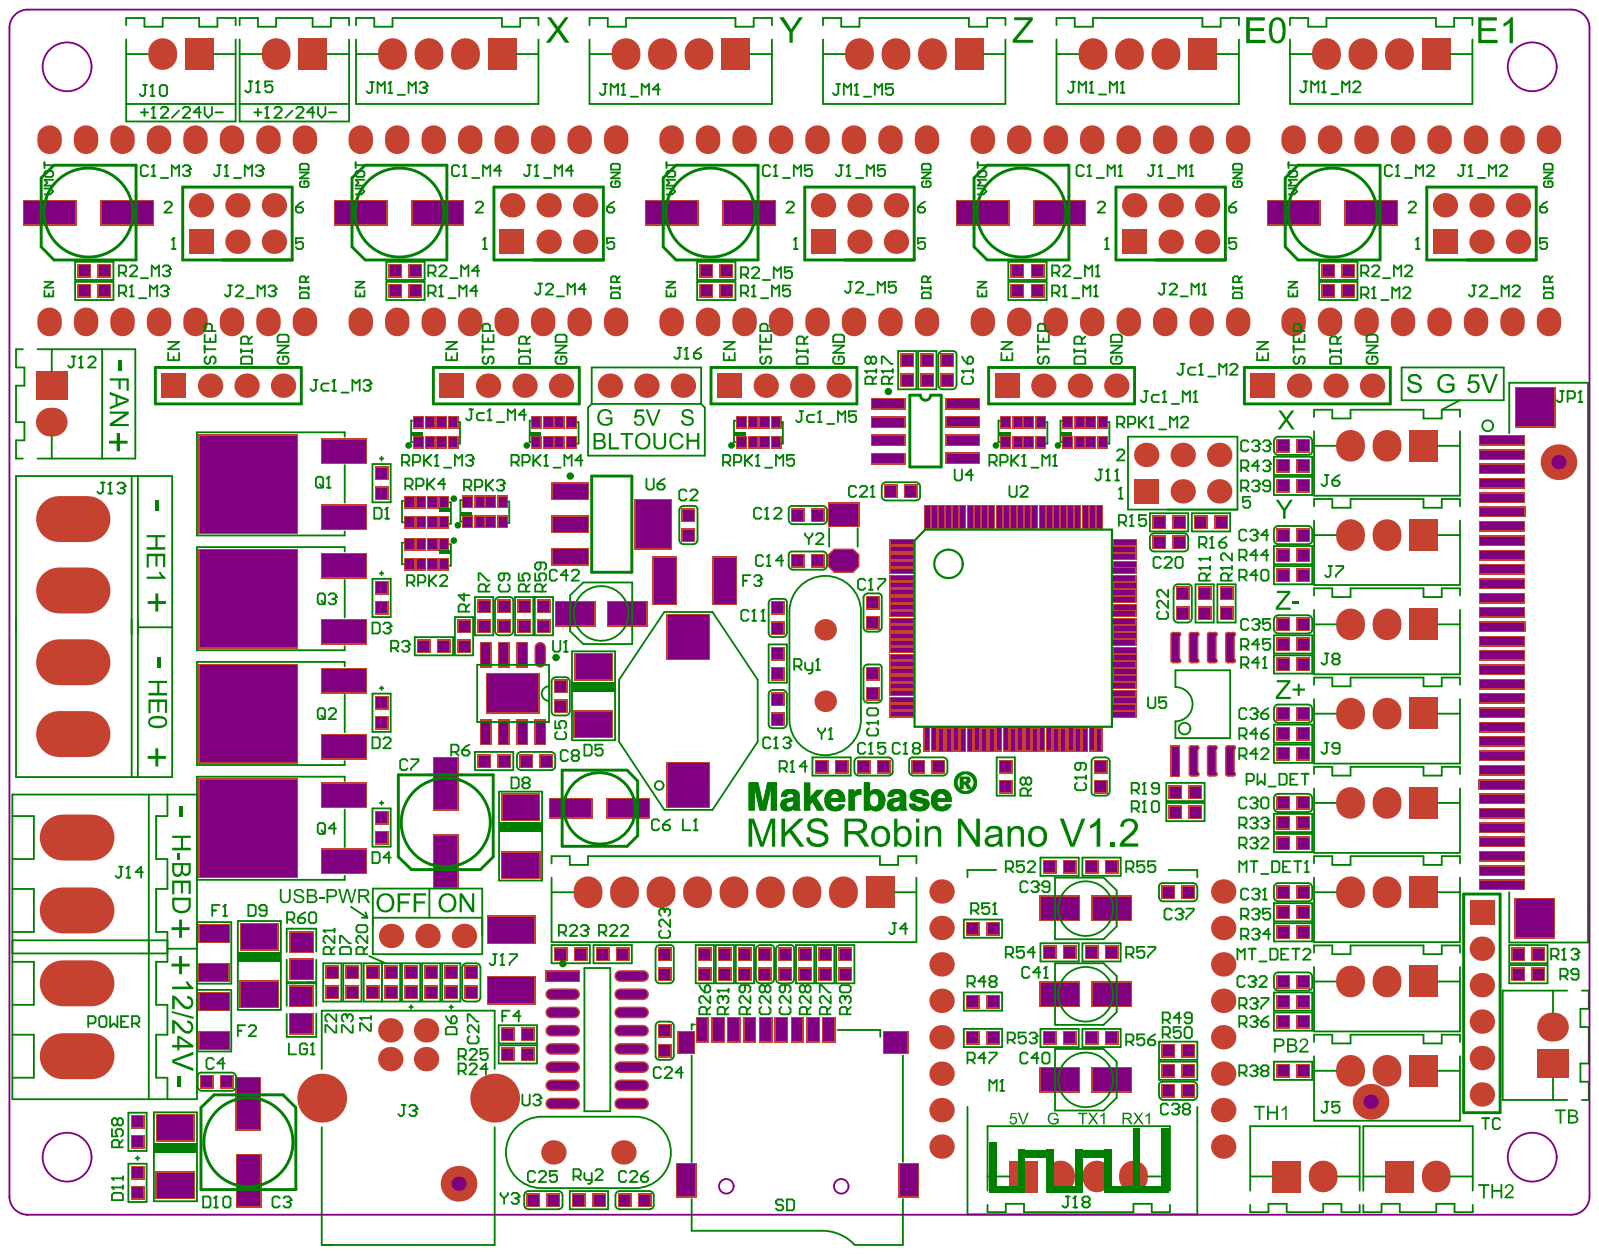
[picture p59: page 1]
