makerbase-mks/MKS-Robin-Nano-V1.X/(commit log)

2019-11-25 update files
    [Configuration.h, Configuration_adv.h]
2020-02-29 upload nano+Robin TFT35 display firmware
    [Configuration.h, Configuration_adv.h]
2020-03-13 Migrating the Marin2.0-for-RobinNano version to a separate repository
    [Configuration.h, Configuration_adv.h]
2020-07-20 add MKS Robin Nano V2.0 BOM
